MinhThuanLe/RAI_Lab_Kicad_Library/3D/Connector/USB/USB-C_12pin_SMD/USB C Top.png

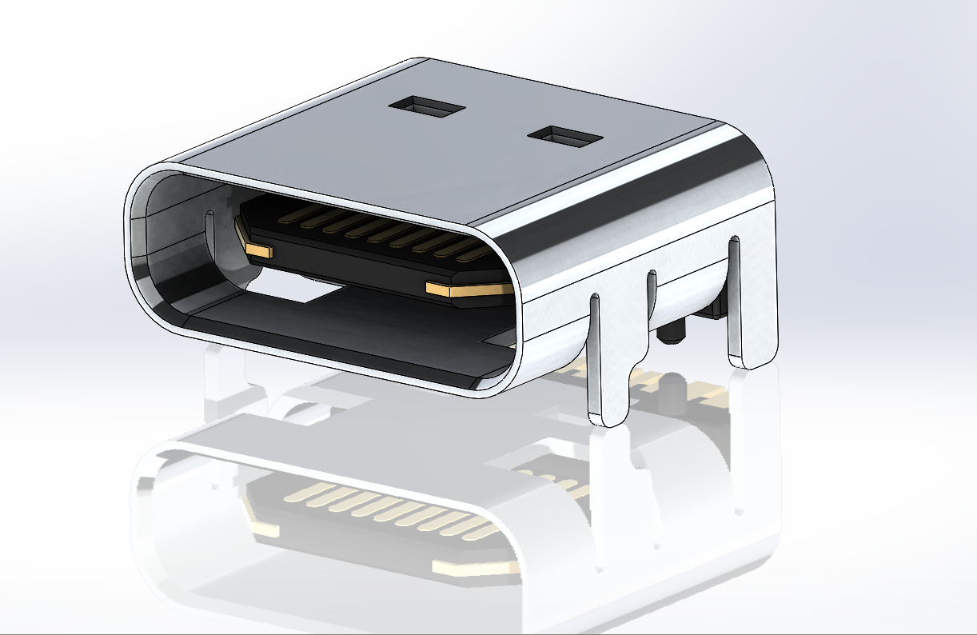
3D/Connector/USB/USB-C_12pin_SMD/USB C Top.png
