MinhThuanLe/RAI_Lab_Kicad_Library/3D/BatteryHolder/14500_BatteryHolder/14500 ICR.PNG

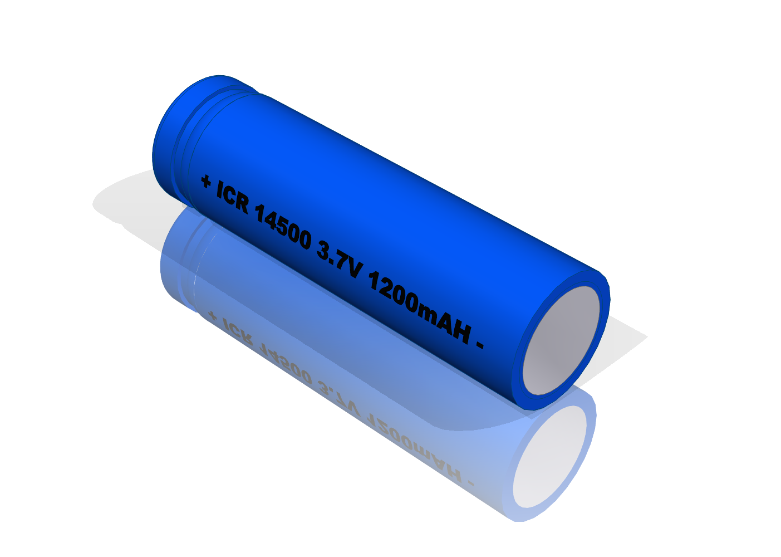
3D/BatteryHolder/14500_BatteryHolder/14500 ICR.PNG
