MinhThuanLe/RAI_Lab_Kicad_Library/3D/BatteryHolder/CR1220_BatteryHolder/Top_CR1220.PNG

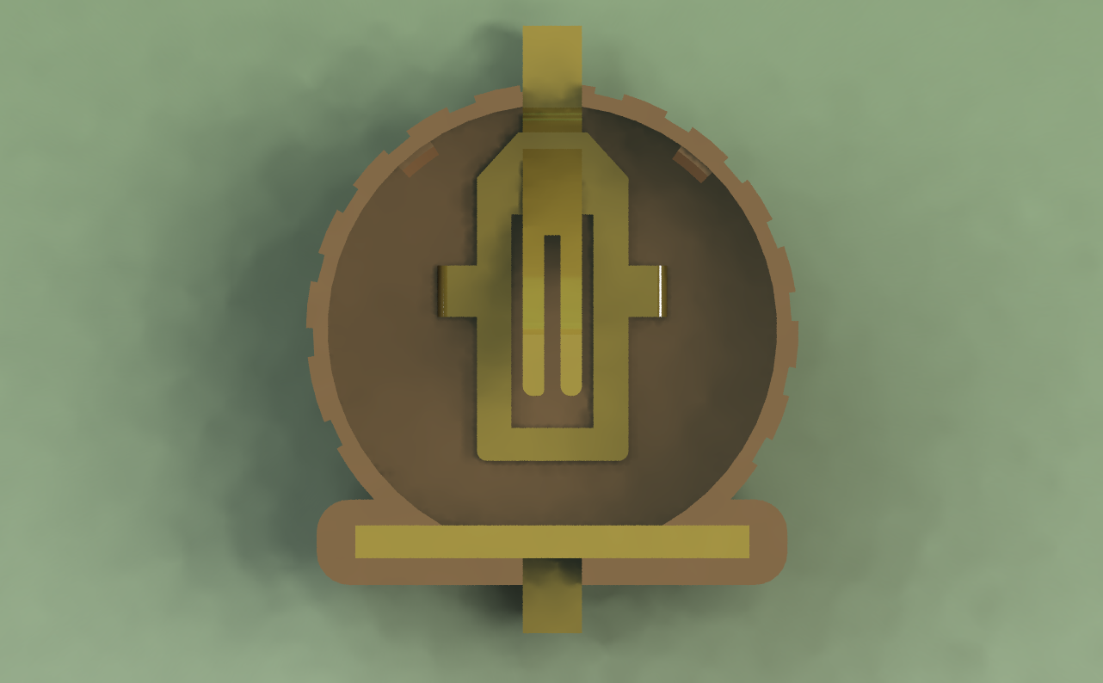
3D/BatteryHolder/CR1220_BatteryHolder/Top_CR1220.PNG
