MinhThuanLe/RAI_Lab_Kicad_Library/3D/BatteryHolder/CR2032_BatteryHolder/CR2032_holder_2018-Jul-28_07-22-14PM-000_CustomizedView1611227186.jpg

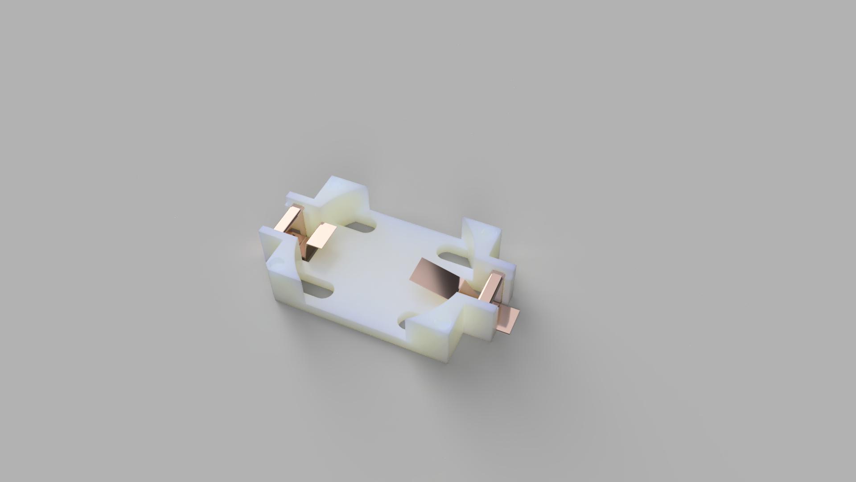
3D/BatteryHolder/CR2032_BatteryHolder/CR2032_holder_2018-Jul-28_07-22-14PM-000_CustomizedView1611227186.jpg
