MinhThuanLe/RAI_Lab_Kicad_Library/3D/BatteryHolder/SINGLE AA BATHOLDER/Renderings/BATT-1.JPG

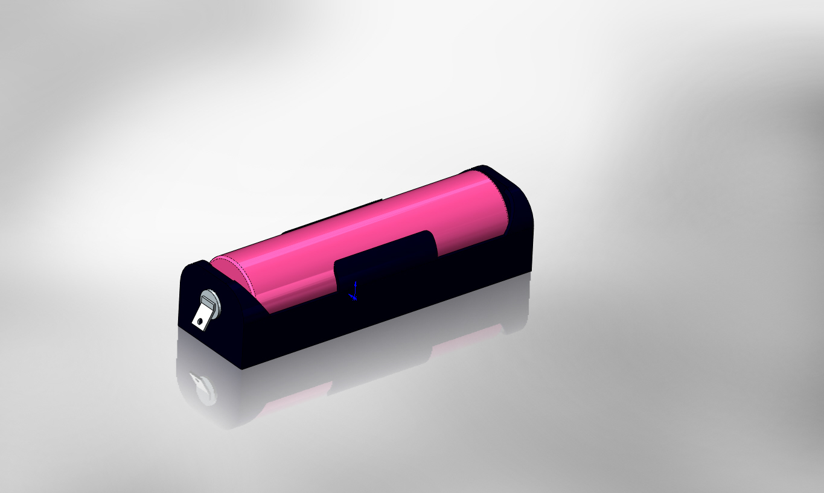
3D/BatteryHolder/SINGLE AA BATHOLDER/Renderings/BATT-1.JPG
