MinhThuanLe/RAI_Lab_Kicad_Library/3D/Comunication/TD301D485/TDx01D485.jpg

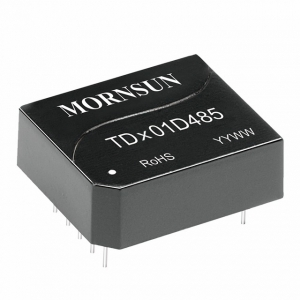
3D/Comunication/TD301D485/TDx01D485.jpg
