MinhThuanLe/RAI_Lab_Kicad_Library/3D/Connector/1706714/1706714.jpg

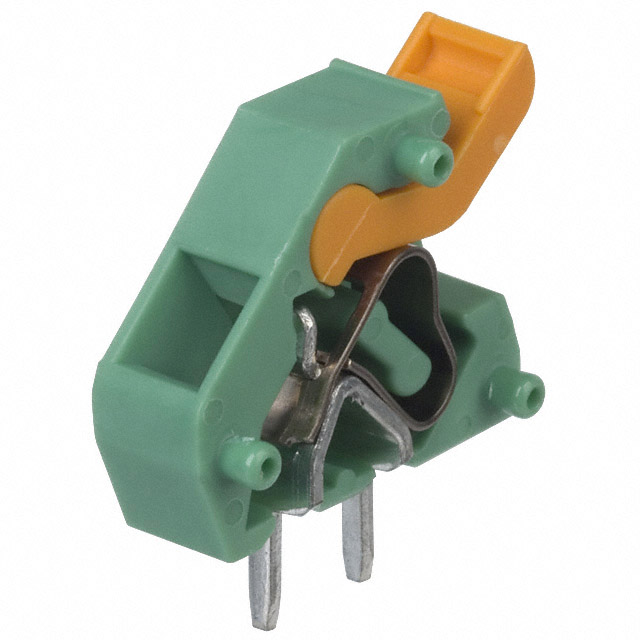
3D/Connector/1706714/1706714.jpg
