MinhThuanLe/RAI_Lab_Kicad_Library/3D/Connector/Banana/14116.jpg

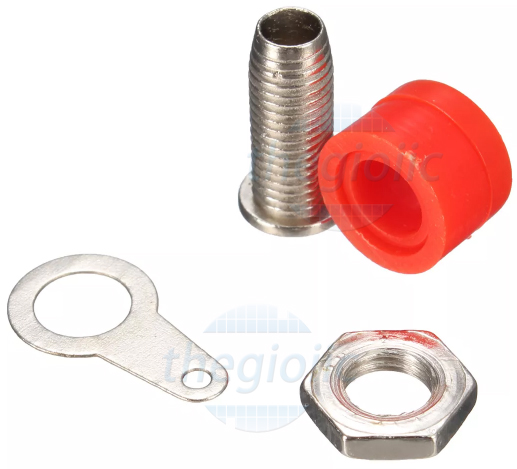
3D/Connector/Banana/14116.jpg
