MinhThuanLe/RAI_Lab_Kicad_Library/3D/Connector/Barrel Jack SMD/BarrelJackSMD.png

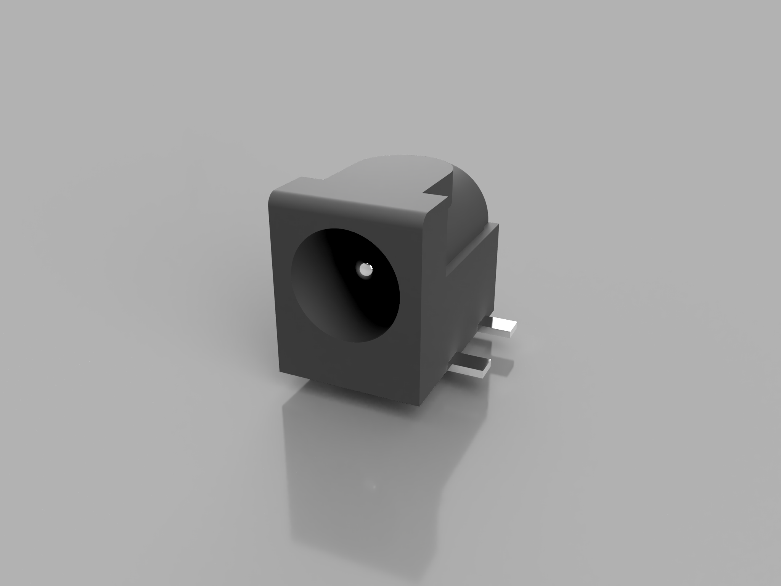
3D/Connector/Barrel Jack SMD/BarrelJackSMD.png
