MinhThuanLe/RAI_Lab_Kicad_Library/3D/Connector/DB/Db15 male PCB Connector.jpg

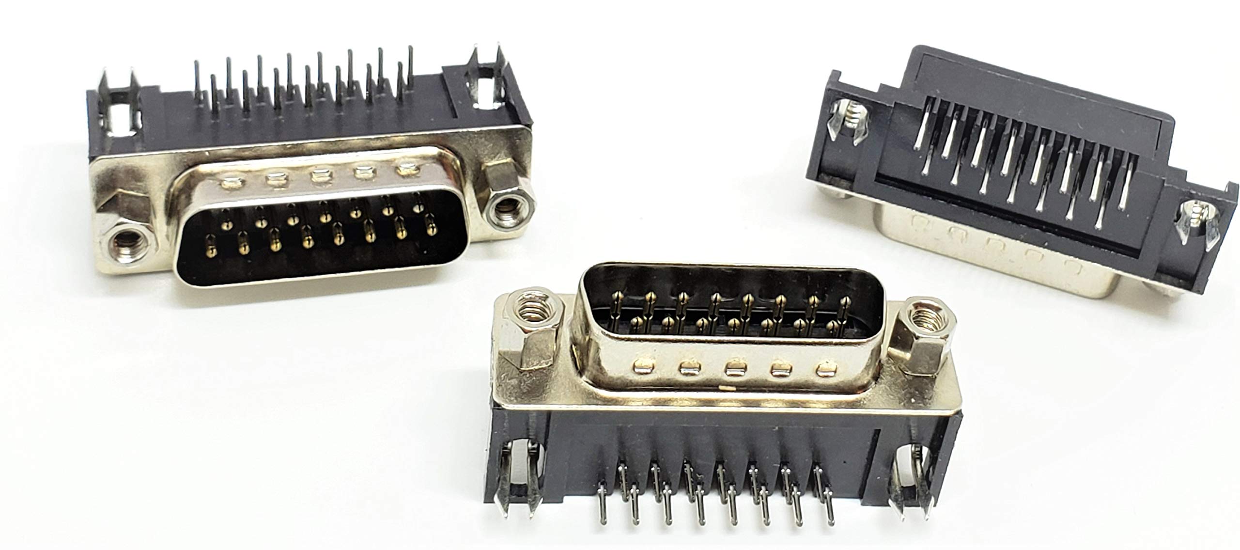
3D/Connector/DB/Db15 male PCB Connector.jpg
