MinhThuanLe/RAI_Lab_Kicad_Library/3D/Connector/DB/VGA_DB15_PCB_RightAngle/c0fe27b1468488ebe378d43be63cc26ed1ba039f.jpg

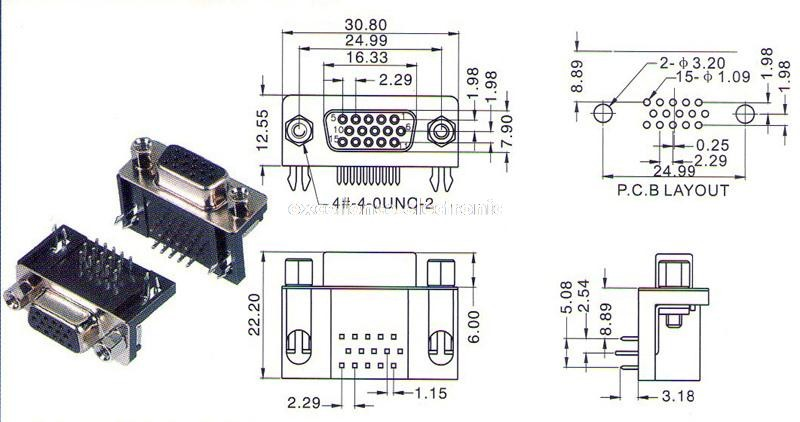
3D/Connector/DB/VGA_DB15_PCB_RightAngle/c0fe27b1468488ebe378d43be63cc26ed1ba039f.jpg
