MinhThuanLe/RAI_Lab_Kicad_Library/3D/Connector/DB/VGA_DB15_PCB_RightAngle/VGA connector on plate (short) - Render image.jpg

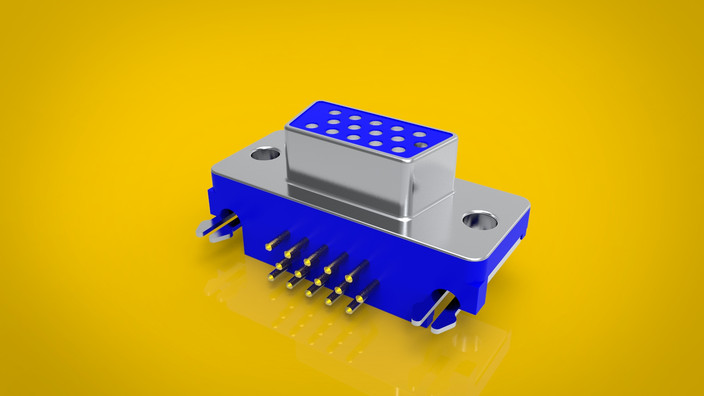
3D/Connector/DB/VGA_DB15_PCB_RightAngle/VGA connector on plate (short) - Render image.jpg
