MinhThuanLe/RAI_Lab_Kicad_Library/3D/Connector/GroveConnector/sit_back.PNG

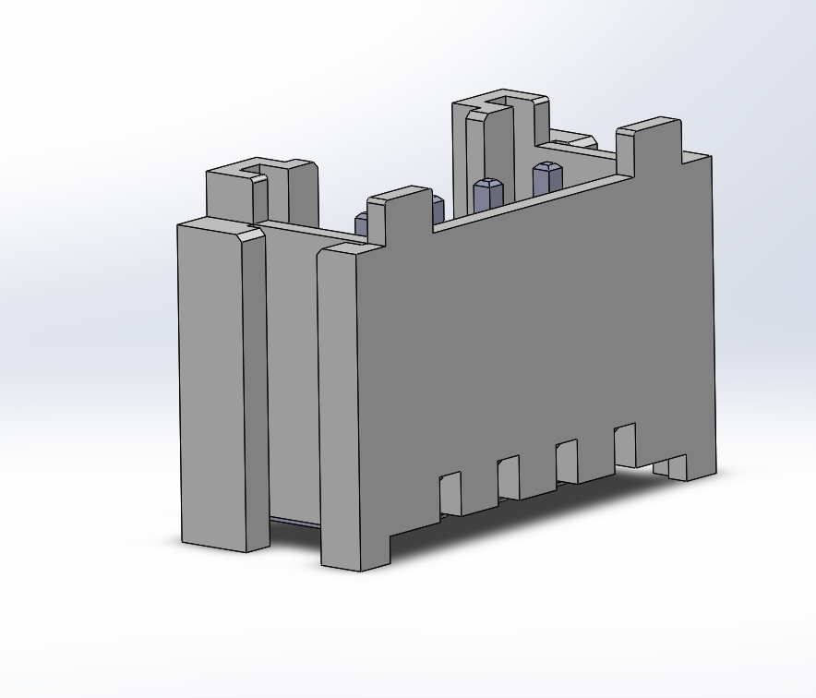
3D/Connector/GroveConnector/sit_back.PNG
