MinhThuanLe/RAI_Lab_Kicad_Library/3D/Connector/GroveConnector/stand_front2.PNG

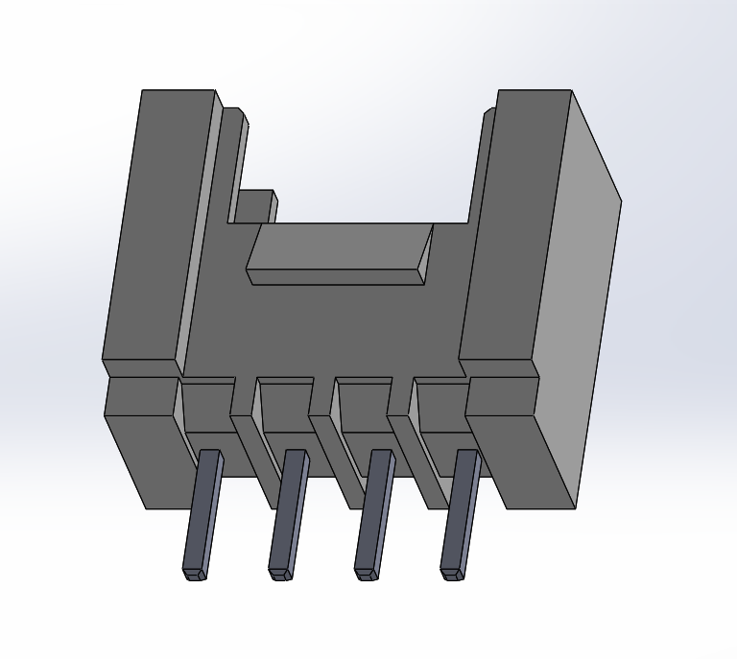
3D/Connector/GroveConnector/stand_front2.PNG
