MinhThuanLe/RAI_Lab_Kicad_Library/3D/Connector/Header Male 2.0mm/TH/Renderings/PinHeadersSF2014.jpg

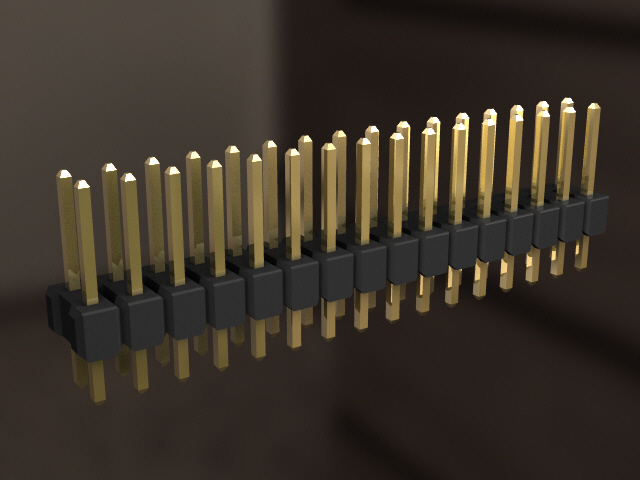
3D/Connector/Header Male 2.0mm/TH/Renderings/PinHeadersSF2014.jpg
