MinhThuanLe/RAI_Lab_Kicad_Library/3D/Connector/Header/Header 1.27mm/Male 1.27mm 2Row SMD/1_27mm_2x11pin.PNG

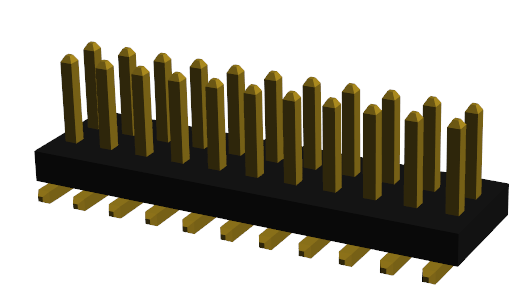
3D/Connector/Header/Header 1.27mm/Male 1.27mm 2Row SMD/1_27mm_2x11pin.PNG
