MinhThuanLe/RAI_Lab_Kicad_Library/3D/Connector/IDC/bh-connector-set-1.snapshot.1/render.JPG

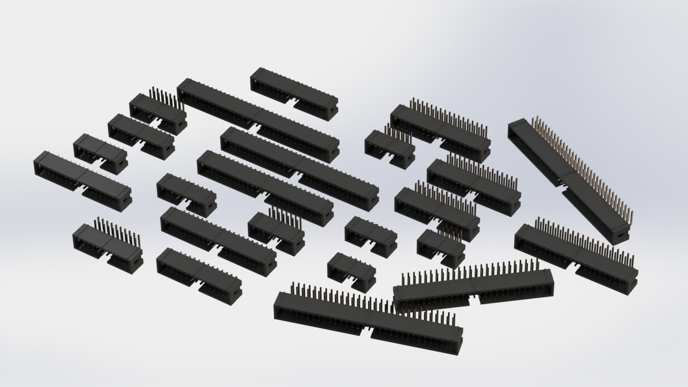
3D/Connector/IDC/bh-connector-set-1.snapshot.1/render.JPG
