MinhThuanLe/RAI_Lab_Kicad_Library/3D/Connector/IDC/IDC Connector 2.54mm/IDC_prev.png

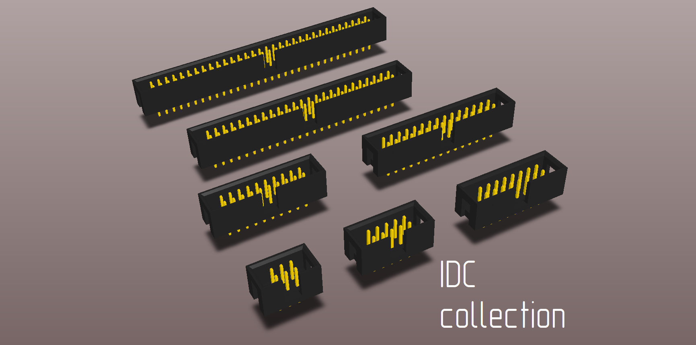
3D/Connector/IDC/IDC Connector 2.54mm/IDC_prev.png
