MinhThuanLe/RAI_Lab_Kicad_Library/3D/Connector/IPEX_Antenna/i-pex-mhf-micro-coax-rf-receptacle-switch-sw23-1.snapshot.2/I-PEX MHF SW23 Coax Switch Recepticle photo.JPG

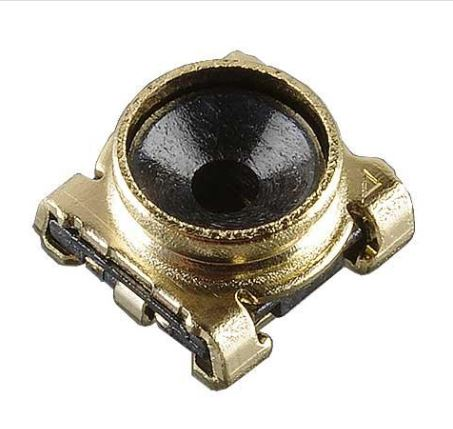
3D/Connector/IPEX_Antenna/i-pex-mhf-micro-coax-rf-receptacle-switch-sw23-1.snapshot.2/I-PEX MHF SW23 Coax Switch Recepticle photo.JPG
