MinhThuanLe/RAI_Lab_Kicad_Library/3D/Connector/Jack_DC/Power Jack Front.jpg

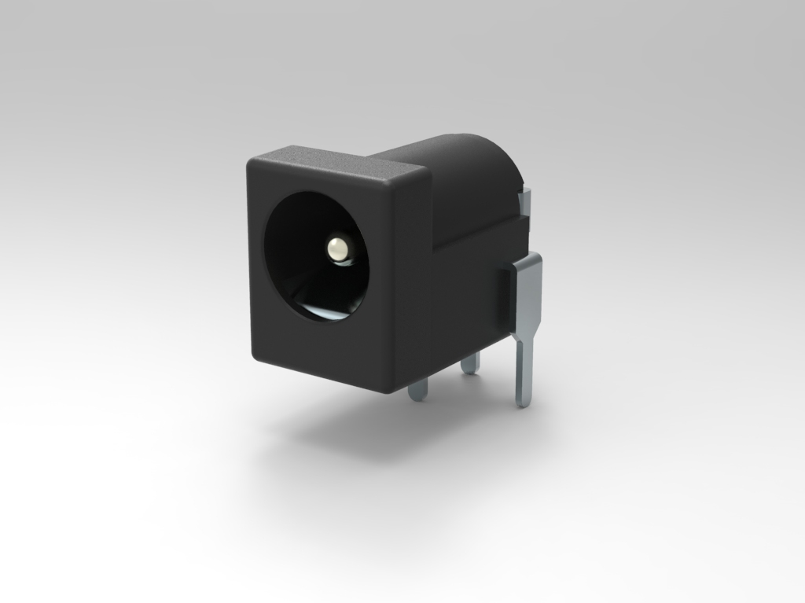
3D/Connector/Jack_DC/Power Jack Front.jpg
