MinhThuanLe/RAI_Lab_Kicad_Library/3D/Connector/JST/DIP/JST-PH-Thru-Vertical-2.00mm/JST - 2.00mm - PH - Assortment.PNG

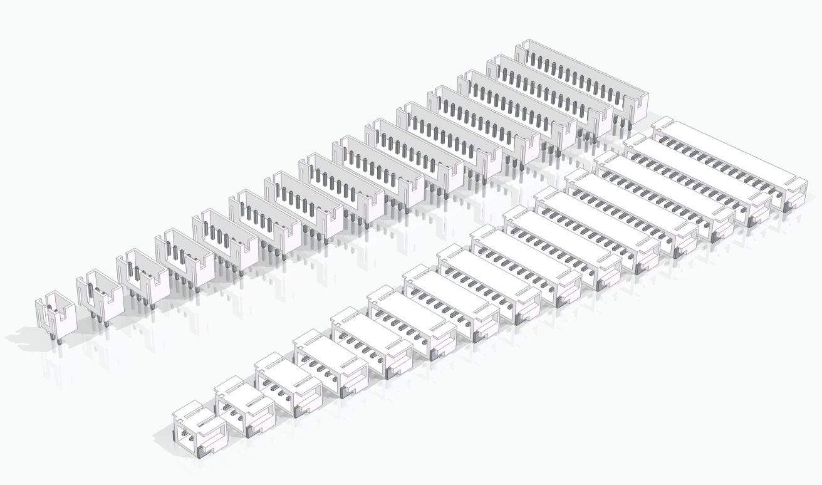
3D/Connector/JST/DIP/JST-PH-Thru-Vertical-2.00mm/JST - 2.00mm - PH - Assortment.PNG
