MinhThuanLe/RAI_Lab_Kicad_Library/3D/Connector/JST/DIP/JST-VH-Thru-Vertical-3.96mm/Capture.PNG

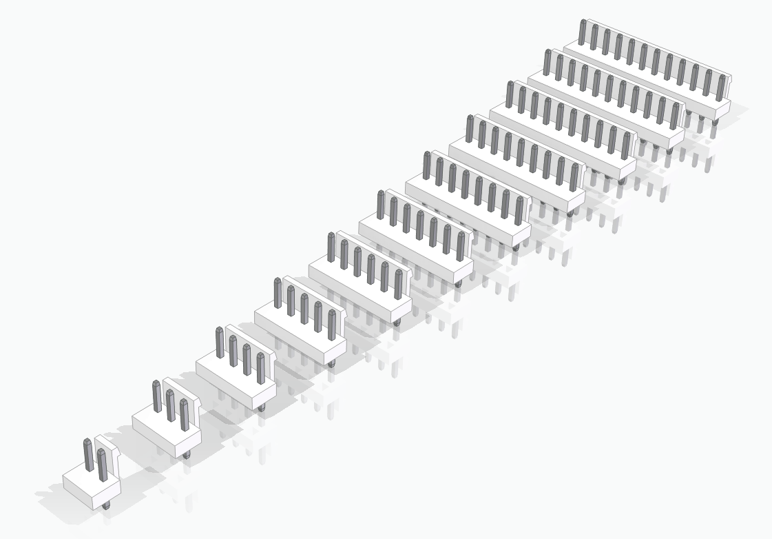
3D/Connector/JST/DIP/JST-VH-Thru-Vertical-3.96mm/Capture.PNG
