MinhThuanLe/RAI_Lab_Kicad_Library/3D/Connector/JST/DIP/JST-XH-Thru-Vertical-2.54mm-4P/2016-12-01_19-26-19.png

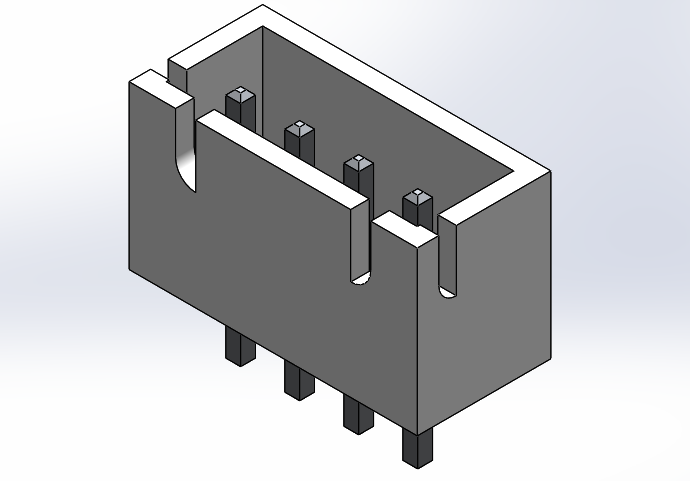
3D/Connector/JST/DIP/JST-XH-Thru-Vertical-2.54mm-4P/2016-12-01_19-26-19.png
