MinhThuanLe/RAI_Lab_Kicad_Library/3D/Connector/JST/DIP/JST-XH-Thru-Vertical-2.54mm-5P/JST 5pin.PNG

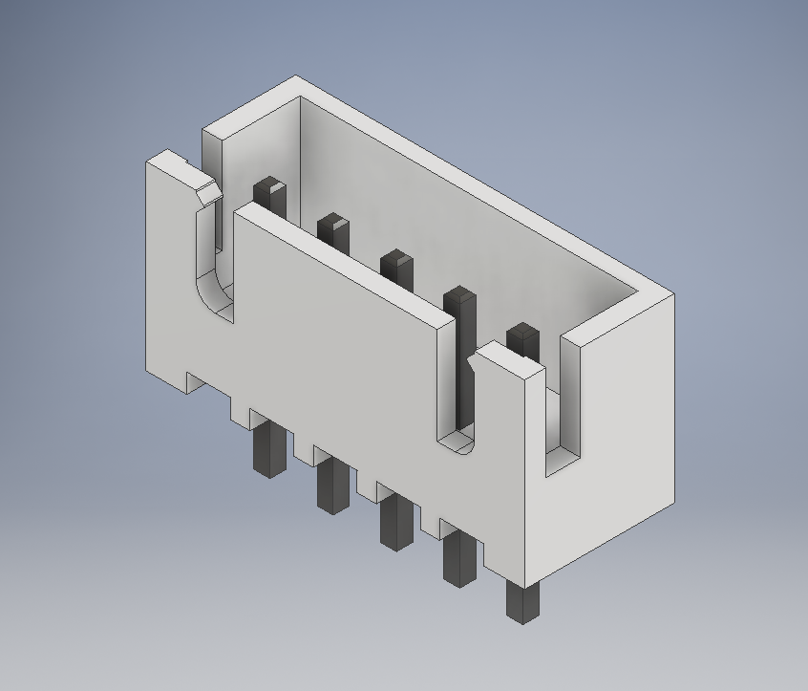
3D/Connector/JST/DIP/JST-XH-Thru-Vertical-2.54mm-5P/JST 5pin.PNG
