MinhThuanLe/RAI_Lab_Kicad_Library/3D/Connector/JST/DIP/JST-XH-Thru-Vertical-2.54mm-8P/JST XH 8 S8B-XH-A1 shrouded header connector v4.png

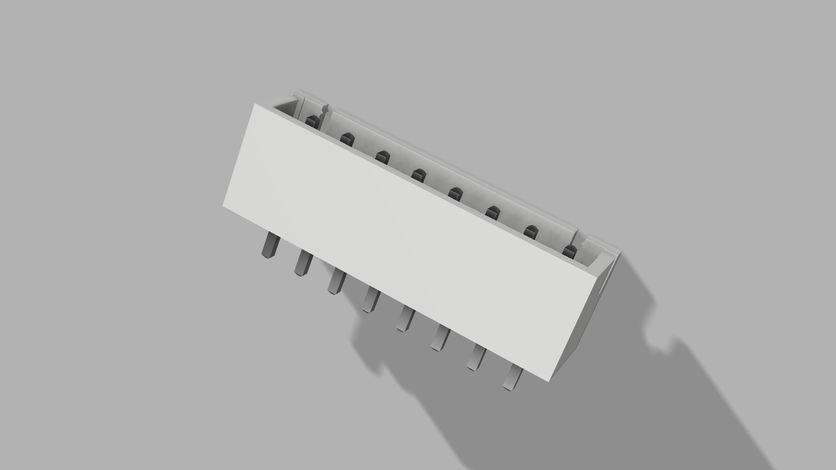
3D/Connector/JST/DIP/JST-XH-Thru-Vertical-2.54mm-8P/JST XH 8 S8B-XH-A1 shrouded header connector v4.png
