MinhThuanLe/RAI_Lab_Kicad_Library/3D/Connector/KF7.62/kf7-62-screw-terminal-1.snapshot.1/KF7.62.png

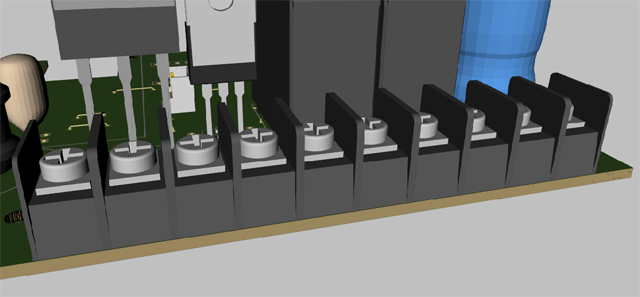
3D/Connector/KF7.62/kf7-62-screw-terminal-1.snapshot.1/KF7.62.png
