MinhThuanLe/RAI_Lab_Kicad_Library/3D/Connector/KF2510/molex3.jpg

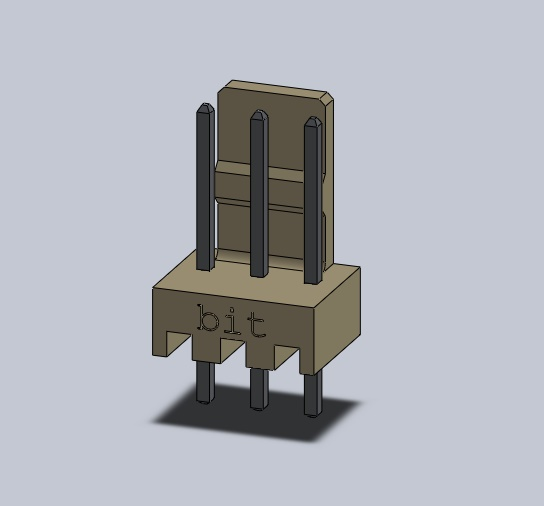
3D/Connector/KF2510/molex3.jpg
