MinhThuanLe/RAI_Lab_Kicad_Library/3D/Connector/RJ11/TJ6P6C/Pic_TJ6-6Cmin.jpg

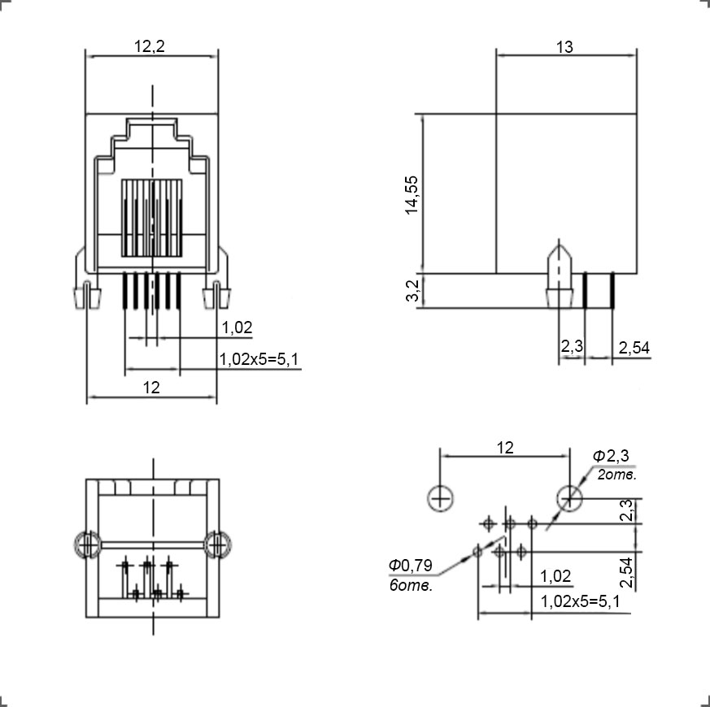
3D/Connector/RJ11/TJ6P6C/Pic_TJ6-6Cmin.jpg
