MinhThuanLe/RAI_Lab_Kicad_Library/3D/Connector/RJ11/TJ6P6C/TJ6P6C 2.png

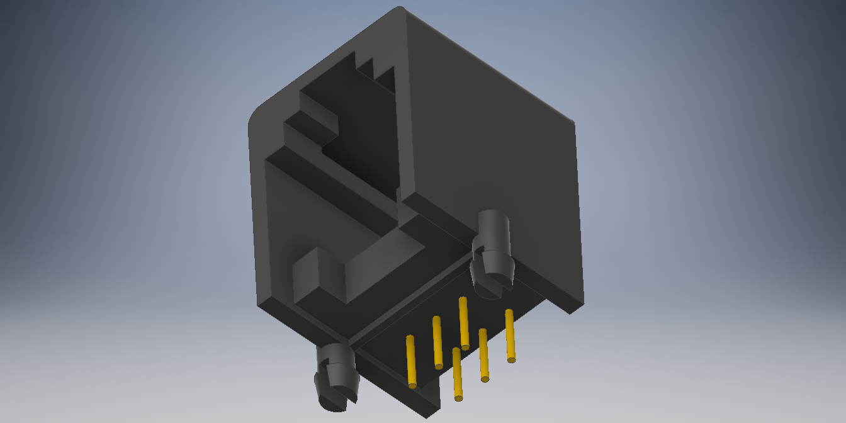
3D/Connector/RJ11/TJ6P6C/TJ6P6C 2.png
