MinhThuanLe/RAI_Lab_Kicad_Library/3D/Connector/ShuntJumpter/Jumper Closed.png

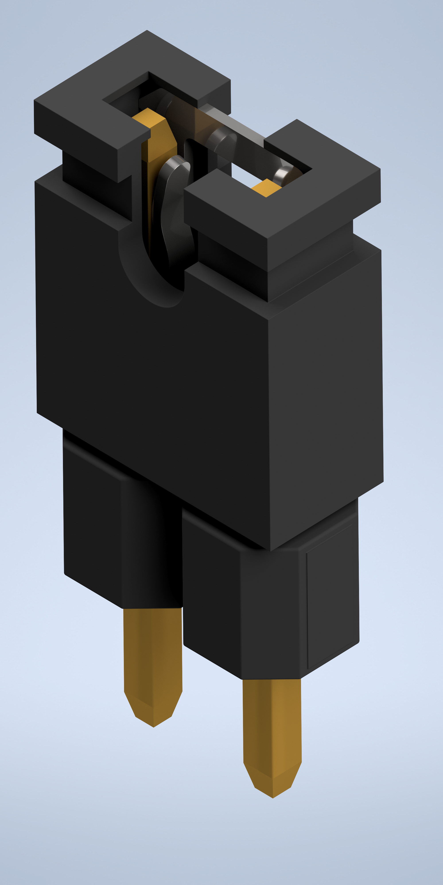
3D/Connector/ShuntJumpter/Jumper Closed.png
