MinhThuanLe/RAI_Lab_Kicad_Library/3D/Connector/Sim_card_holder/Renderings/ATTEND_115A-ADA0-R02.JPG

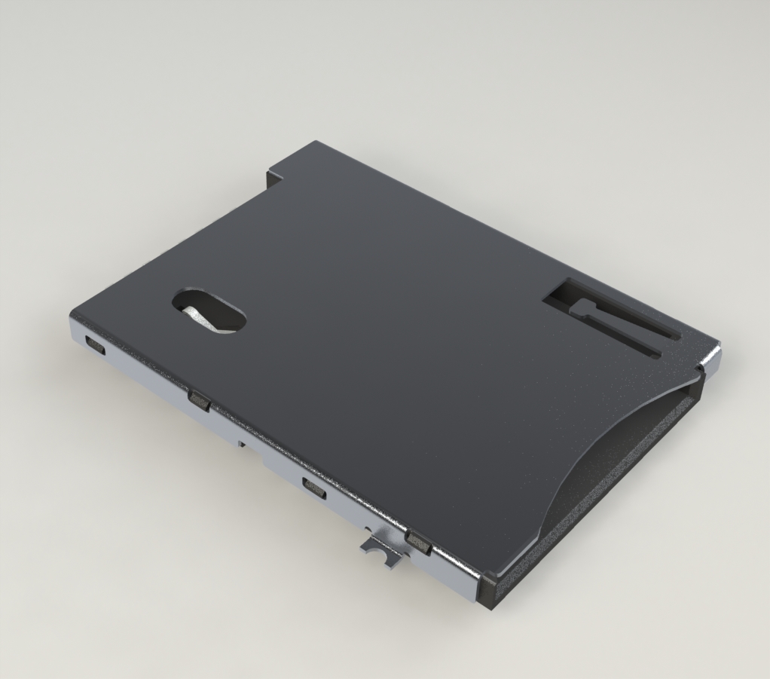
3D/Connector/Sim_card_holder/Renderings/ATTEND_115A-ADA0-R02.JPG
