MinhThuanLe/RAI_Lab_Kicad_Library/3D/Connector/SIMCardHolder/NanoSIM/Molex/47388001/2.JPG

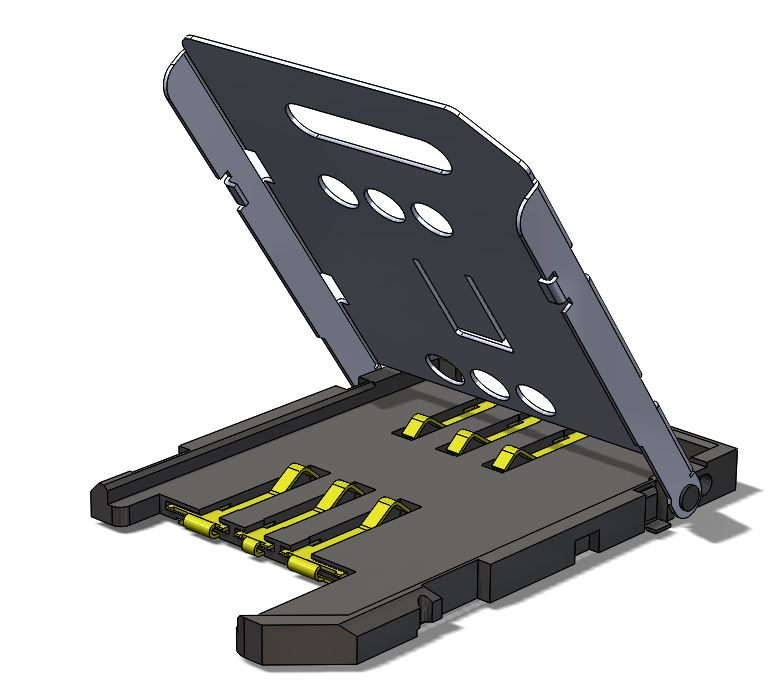
3D/Connector/SIMCardHolder/NanoSIM/Molex/47388001/2.JPG
