MinhThuanLe/RAI_Lab_Kicad_Library/3D/Connector/Terminal Screw 3P Blue/001.JPG

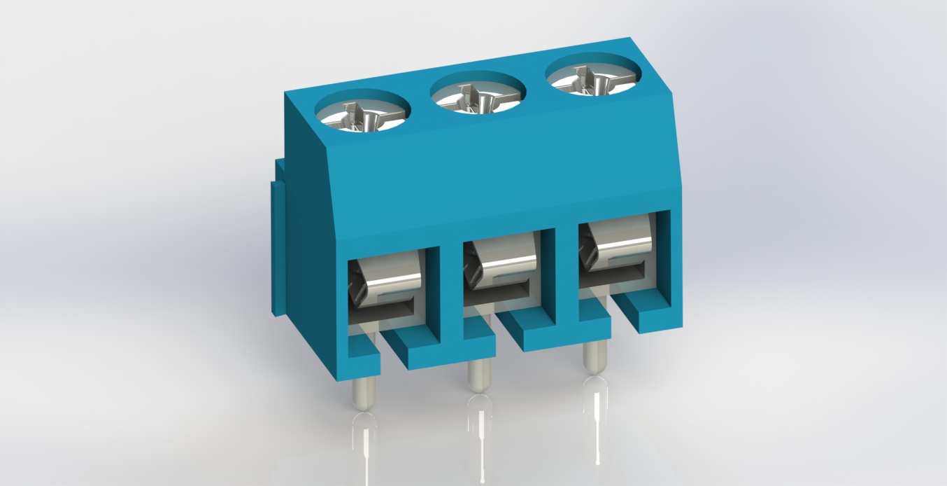
3D/Connector/Terminal Screw 3P Blue/001.JPG
