MinhThuanLe/RAI_Lab_Kicad_Library/3D/Connector/terminal-block-connector-1.snapshot.7/691216510002_1776244-2.jpg

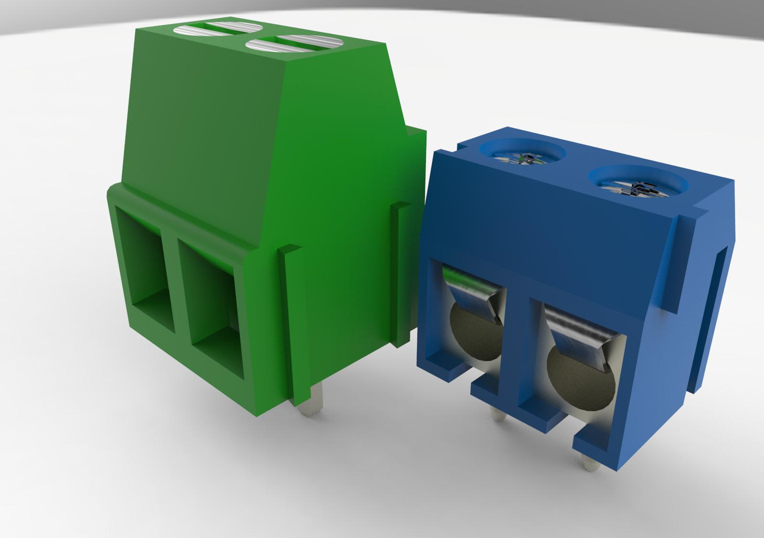
3D/Connector/terminal-block-connector-1.snapshot.7/691216510002_1776244-2.jpg
