MinhThuanLe/RAI_Lab_Kicad_Library/3D/Connector/terminal-block-connector-1.snapshot.7/TE 1776244-2-1.JPG

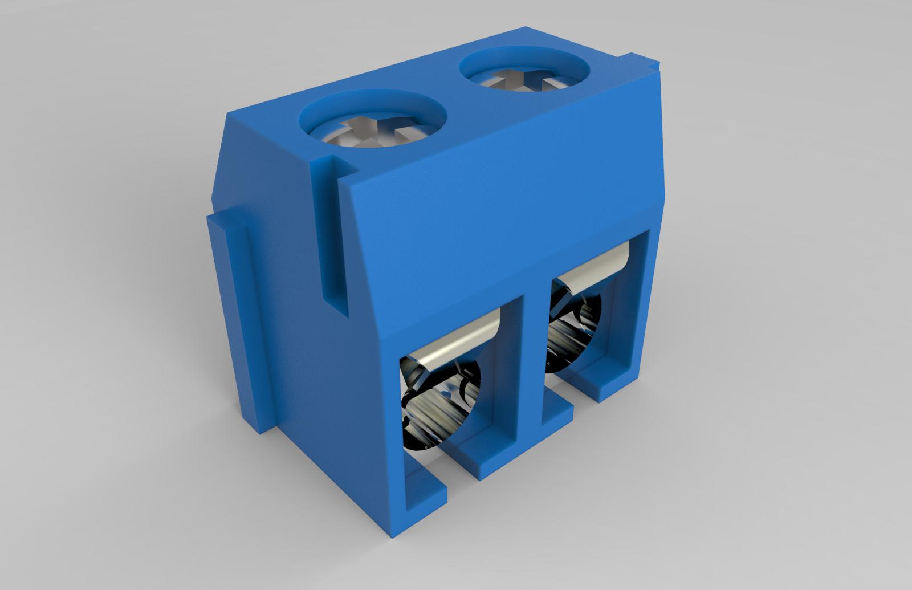
3D/Connector/terminal-block-connector-1.snapshot.7/TE 1776244-2-1.JPG
