MinhThuanLe/RAI_Lab_Kicad_Library/3D/Connector/terminal-block-connector-1.snapshot.7/WURTH_691216510002.jpg

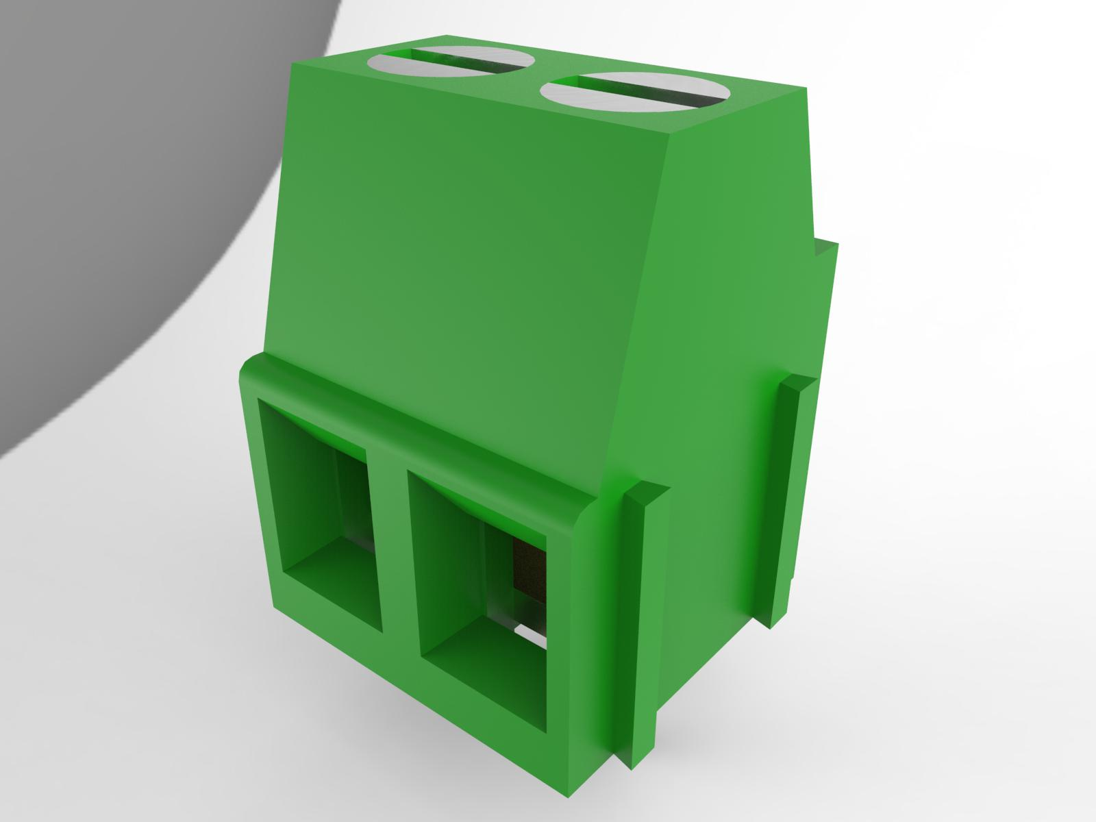
3D/Connector/terminal-block-connector-1.snapshot.7/WURTH_691216510002.jpg
