MinhThuanLe/RAI_Lab_Kicad_Library/3D/Connector/TerminalBlock/borne-5-08mm-duplo-nivel-1.snapshot.2/borne 2.png

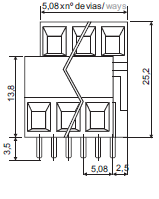
3D/Connector/TerminalBlock/borne-5-08mm-duplo-nivel-1.snapshot.2/borne 2.png
