MinhThuanLe/RAI_Lab_Kicad_Library/3D/Connector/USB-C_12pin_SMD/USB C Bottom.png

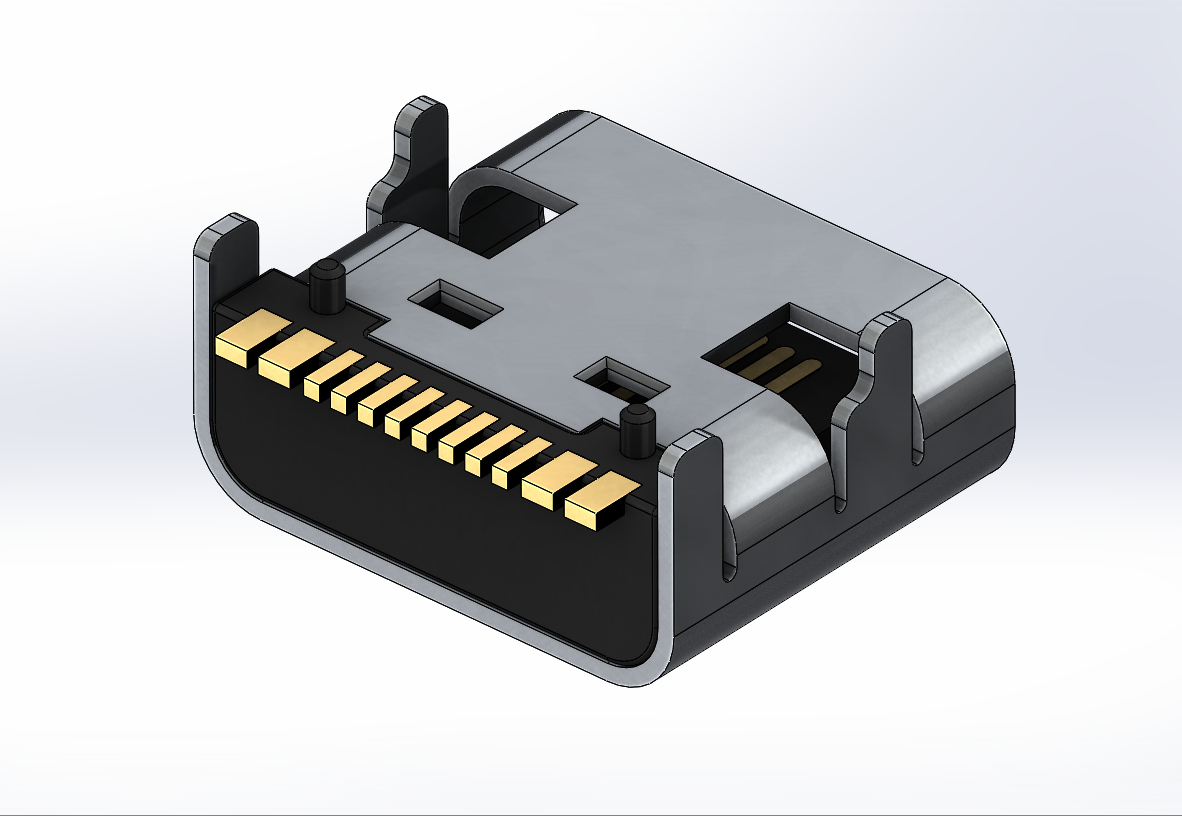
3D/Connector/USB-C_12pin_SMD/USB C Bottom.png
