MinhThuanLe/RAI_Lab_Kicad_Library/3D/Connector/XH_2.54/JST XH Assortment.PNG

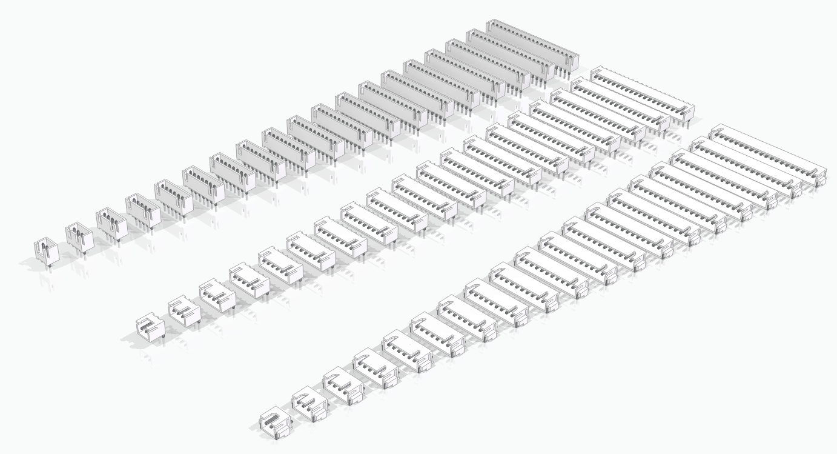
3D/Connector/XH_2.54/JST XH Assortment.PNG
