MinhThuanLe/RAI_Lab_Kicad_Library/3D/Crystal/CrystalOscillator2016_4P_SMD/QFN_2016_4pins iso rendering - top.JPG

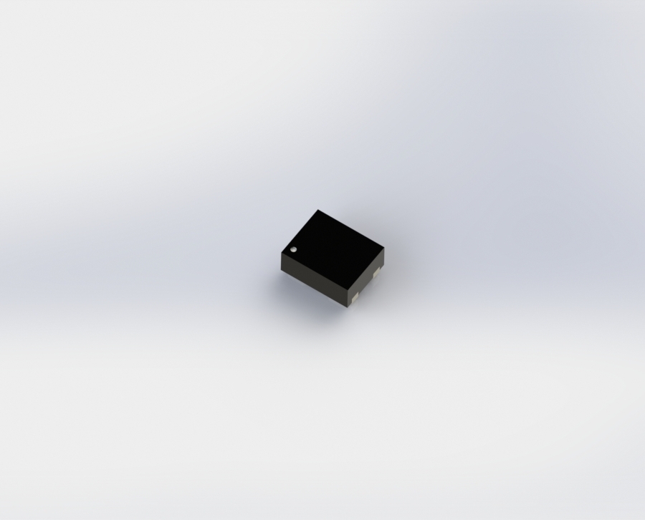
3D/Crystal/CrystalOscillator2016_4P_SMD/QFN_2016_4pins iso rendering - top.JPG
