MinhThuanLe/RAI_Lab_Kicad_Library/3D/Diode/Diodes-smd-packages.png

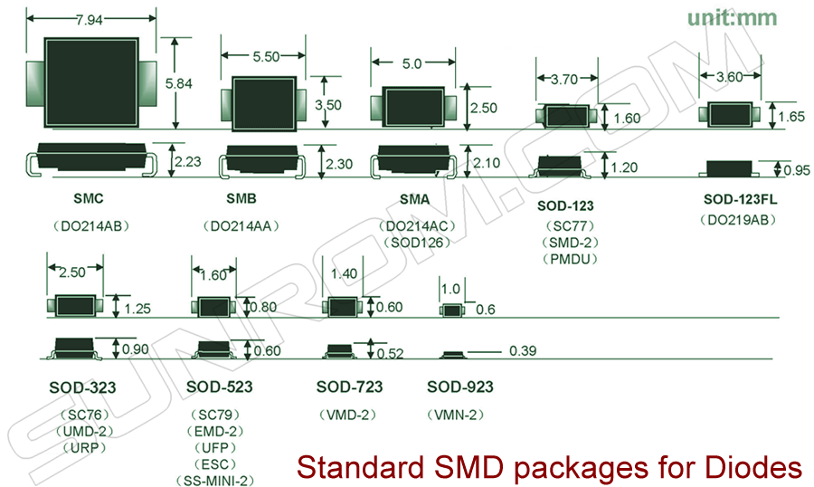
3D/Diode/Diodes-smd-packages.png
