MinhThuanLe/RAI_Lab_Kicad_Library/3D/Diode/LED/GP1UE26RK0VF.jpg

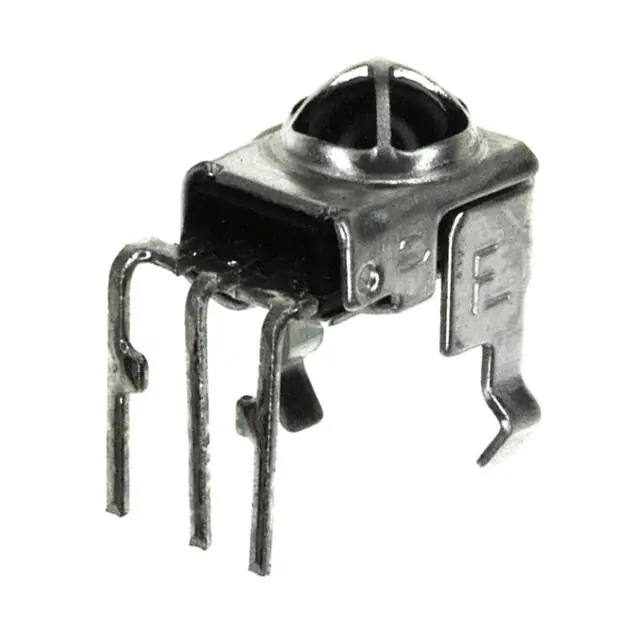
3D/Diode/LED/GP1UE26RK0VF.jpg
