MinhThuanLe/RAI_Lab_Kicad_Library/3D/Diode/LED/ITR9909.jpg

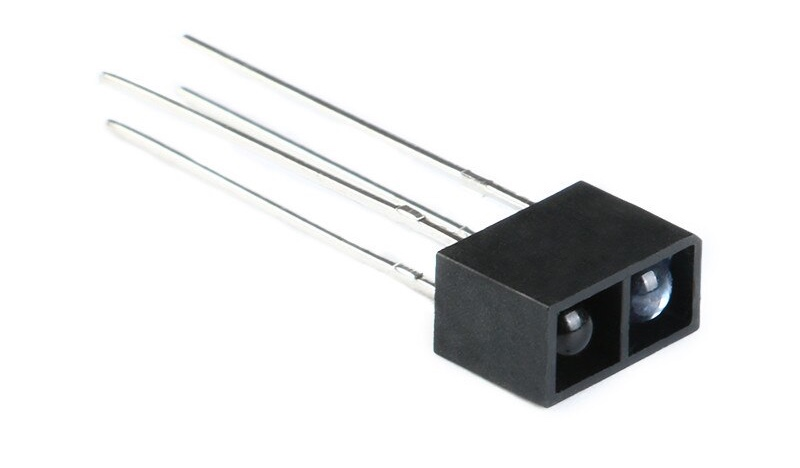
3D/Diode/LED/ITR9909.jpg
