MinhThuanLe/RAI_Lab_Kicad_Library/3D/Diode/LED/LED/Lite-On SMD LEDs.PNG

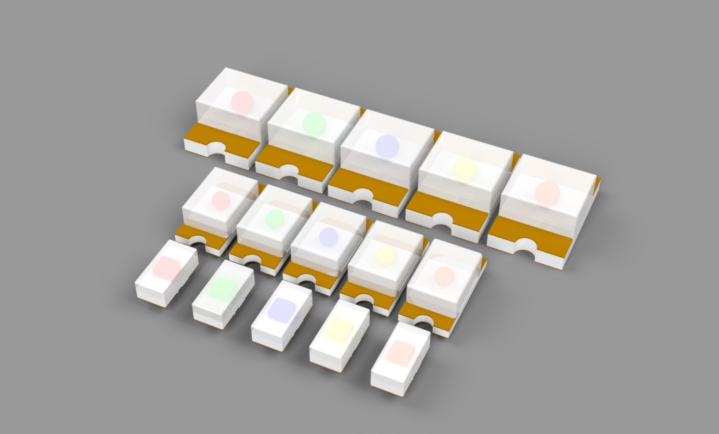
3D/Diode/LED/LED/Lite-On SMD LEDs.PNG
