MinhThuanLe/RAI_Lab_Kicad_Library/3D/Diode/LED/LED_Housing/LED 3mm red housing_1.jpg

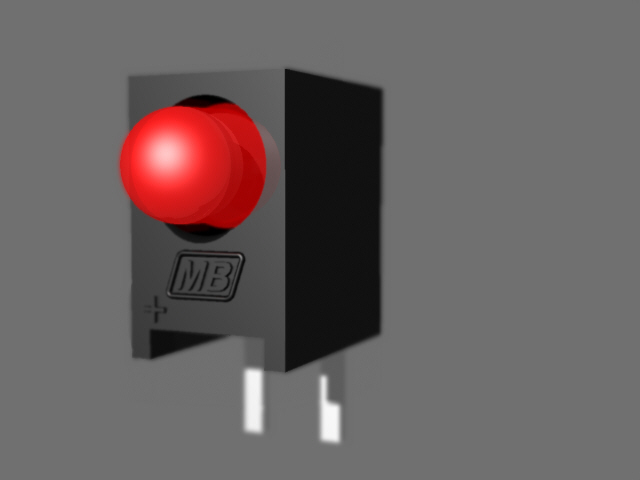
3D/Diode/LED/LED_Housing/LED 3mm red housing_1.jpg
