MinhThuanLe/RAI_Lab_Kicad_Library/3D/Diode/LED/LED_Housing/led model dimensions.png

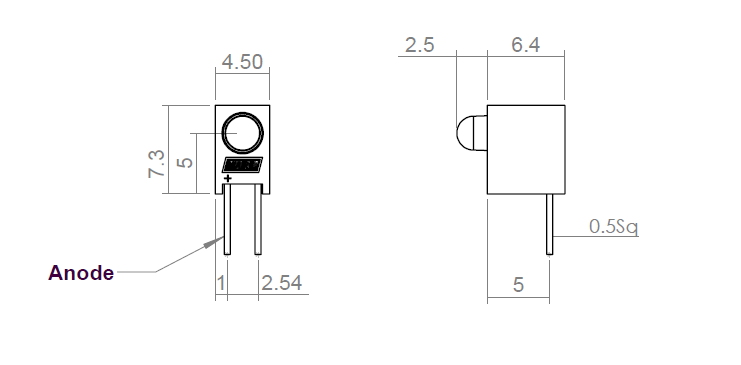
3D/Diode/LED/LED_Housing/led model dimensions.png
