MinhThuanLe/RAI_Lab_Kicad_Library/3D/Diode/LED/LED_Housing/LEDs 3mm housing_4.jpg

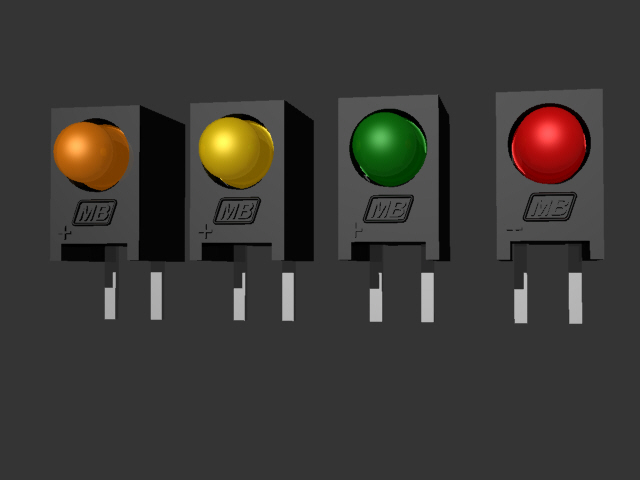
3D/Diode/LED/LED_Housing/LEDs 3mm housing_4.jpg
