MinhThuanLe/RAI_Lab_Kicad_Library/3D/Diode/LED/TCRT5000 .png

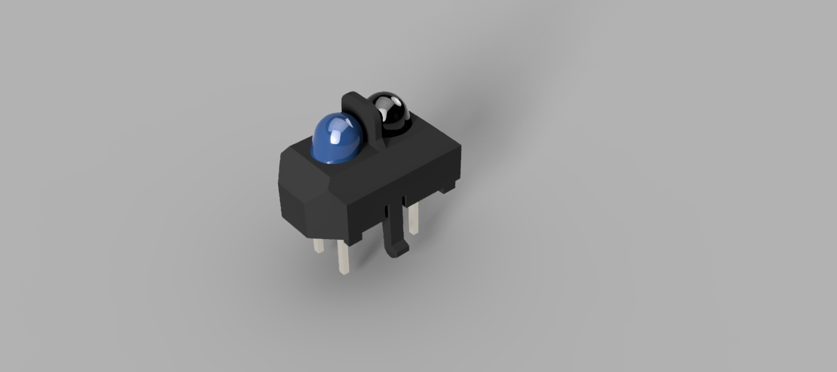
3D/Diode/LED/TCRT5000 .png
