MinhThuanLe/RAI_Lab_Kicad_Library/3D/Diode/LED/VS1383B back.JPG

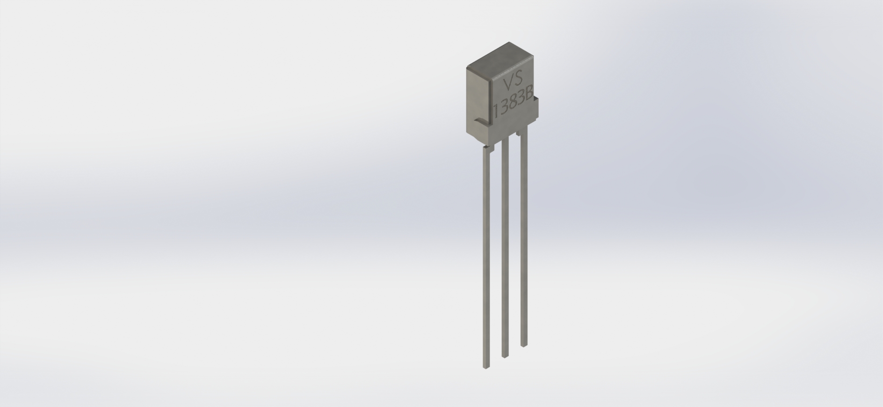
3D/Diode/LED/VS1383B back.JPG
