MinhThuanLe/RAI_Lab_Kicad_Library/3D/Diode/LED/VS1383B front.JPG

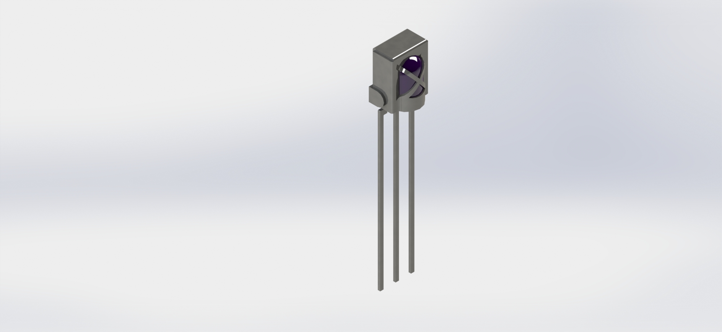
3D/Diode/LED/VS1383B front.JPG
