MinhThuanLe/RAI_Lab_Kicad_Library/3D/Diode/SMA/Package diode SMA.jpg

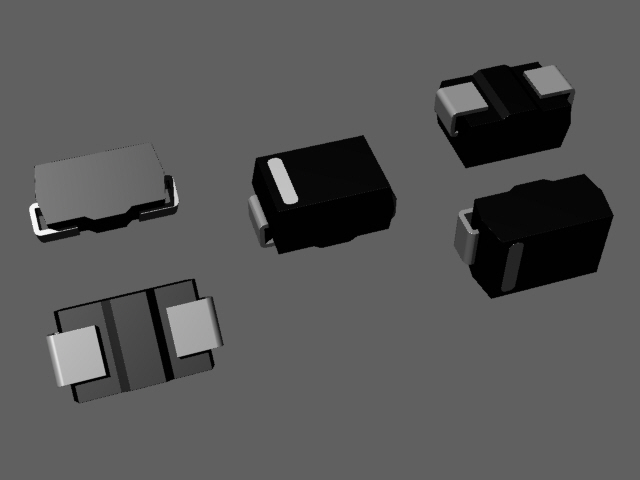
3D/Diode/SMA/Package diode SMA.jpg
