MinhThuanLe/RAI_Lab_Kicad_Library/3D/Diode/SOD323/SOD-600.jpg

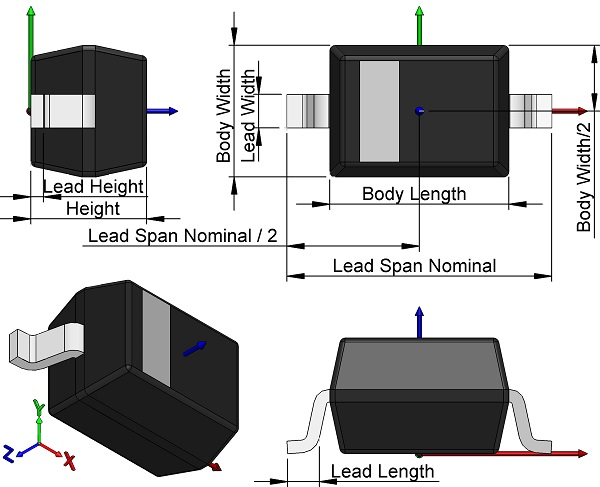
3D/Diode/SOD323/SOD-600.jpg
