MinhThuanLe/RAI_Lab_Kicad_Library/3D/Encoder/DIP/11mm-metal-shaft-rotary-encoders-horizontal-w-push-on-switch/EC11B-SW-Horiz-F.png

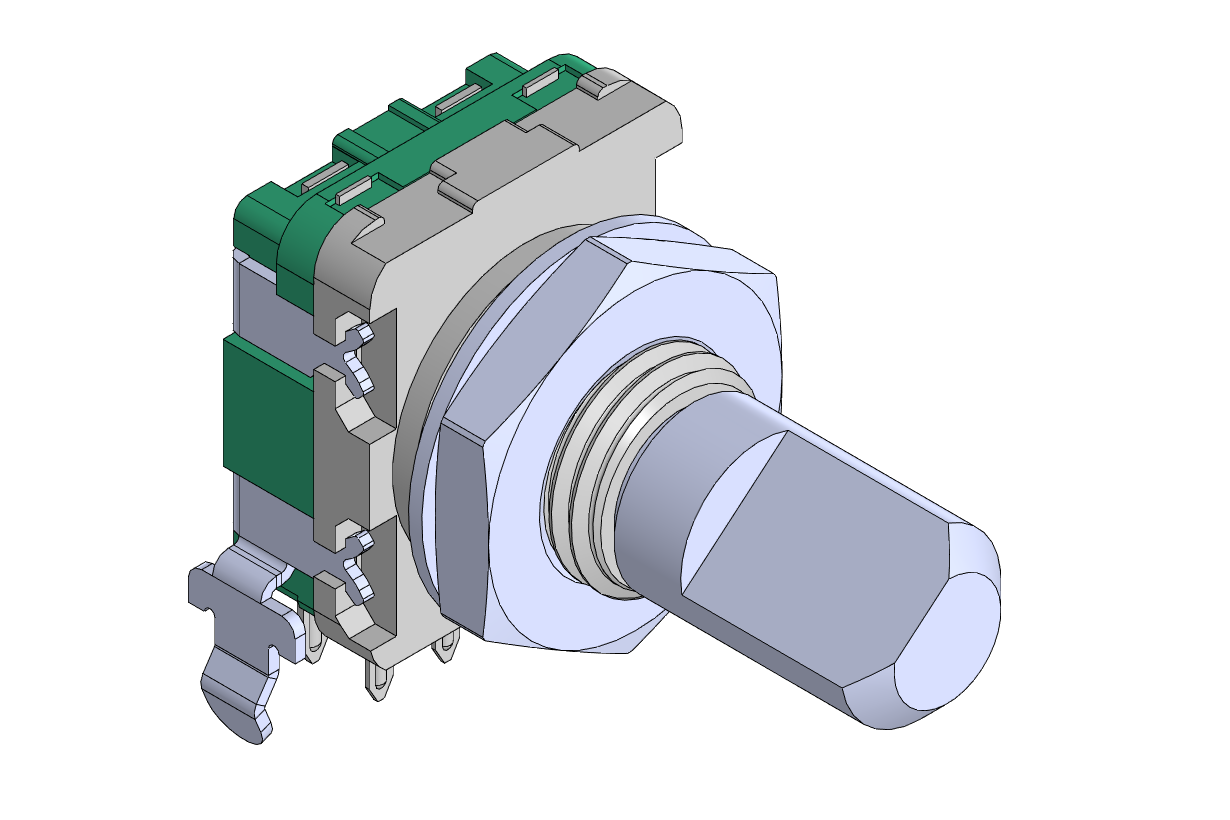
3D/Encoder/DIP/11mm-metal-shaft-rotary-encoders-horizontal-w-push-on-switch/EC11B-SW-Horiz-F.png
