MinhThuanLe/RAI_Lab_Kicad_Library/3D/Encoder/DIP/11mm-metal-shaft-rotary-encoders-tht-vertical-w-push-on-switch/EC11-THT-25R-black.png

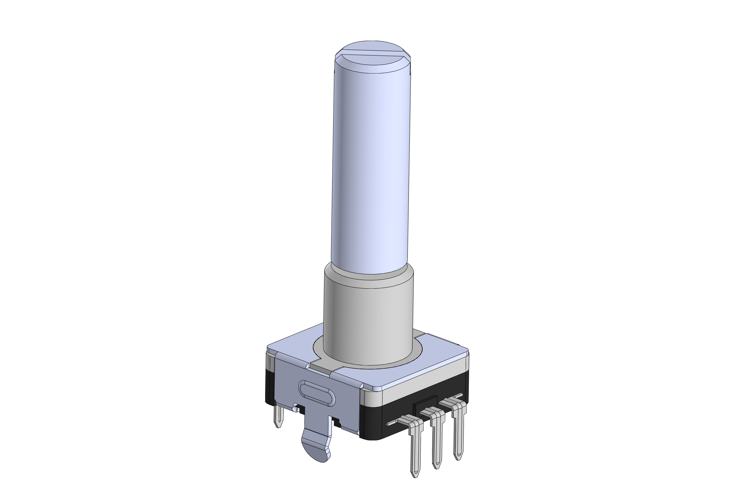
3D/Encoder/DIP/11mm-metal-shaft-rotary-encoders-tht-vertical-w-push-on-switch/EC11-THT-25R-black.png
