MinhThuanLe/RAI_Lab_Kicad_Library/3D/Encoder/DIP/rotary-encoder-17.snapshot.2/1.PNG

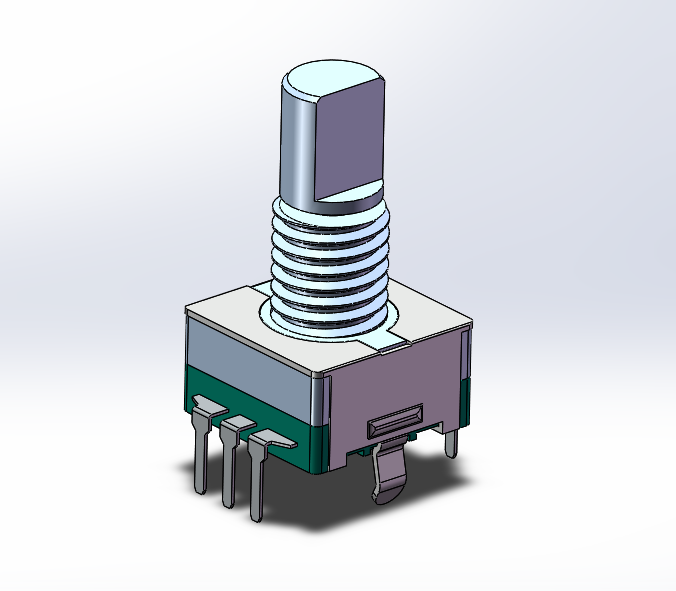
3D/Encoder/DIP/rotary-encoder-17.snapshot.2/1.PNG
