MinhThuanLe/RAI_Lab_Kicad_Library/3D/Fuses/FuseHolderGlass5x20mm/fuse.jpg

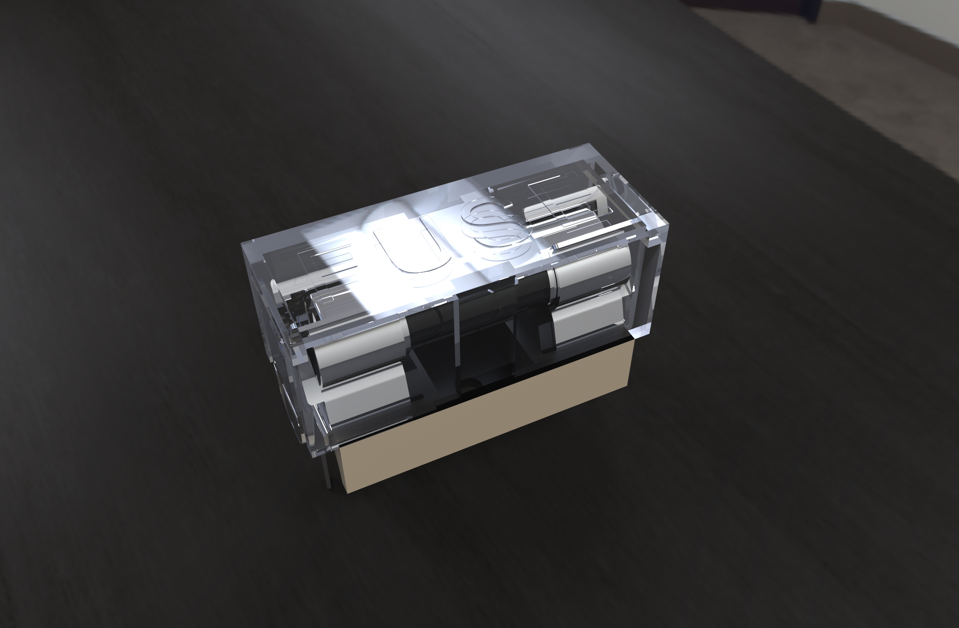
3D/Fuses/FuseHolderGlass5x20mm/fuse.jpg
