MinhThuanLe/RAI_Lab_Kicad_Library/3D/Fuses/FuseSMD/litteFuse/Littelfuse_0154.500DRT_without_value_black_2020-Jun-30_08-23-00AM-000_CustomizedView4664949642.png

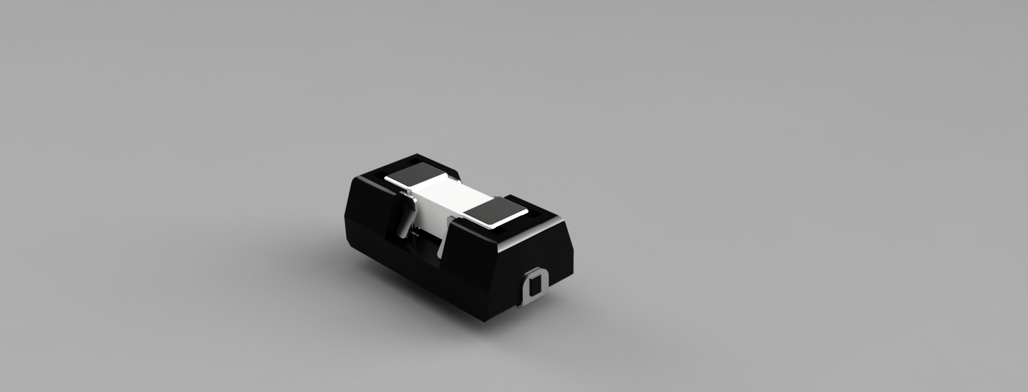
3D/Fuses/FuseSMD/litteFuse/Littelfuse_0154.500DRT_without_value_black_2020-Jun-30_08-23-00AM-000_CustomizedView4664949642.png
