MinhThuanLe/RAI_Lab_Kicad_Library/3D/Fuses/FuseSMD/Resettable Fuse/1206/Bourns SF Fuse/Bourns SF-1206SA-R series SMD Fuses.jpg

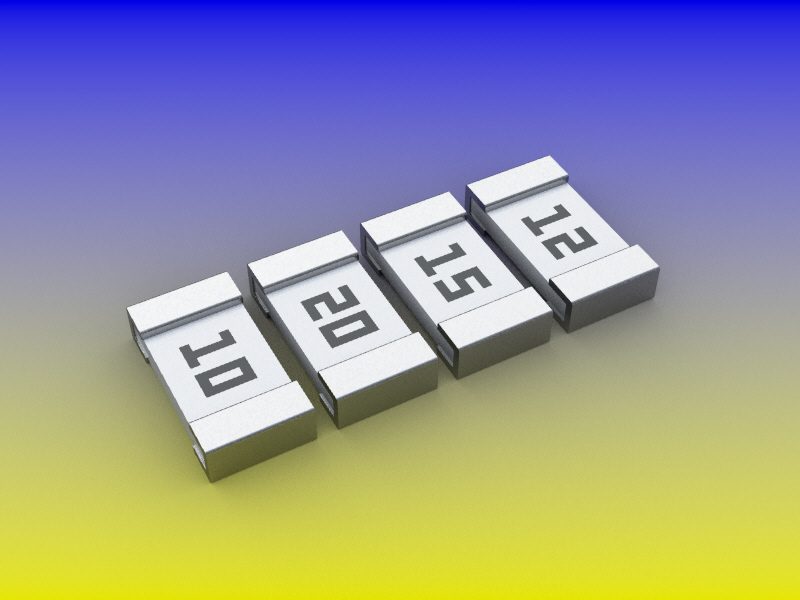
3D/Fuses/FuseSMD/Resettable Fuse/1206/Bourns SF Fuse/Bourns SF-1206SA-R series SMD Fuses.jpg
