MinhThuanLe/RAI_Lab_Kicad_Library/3D/Fuses/FuseSMD/Resettable Fuse/1206_dimensions.PNG

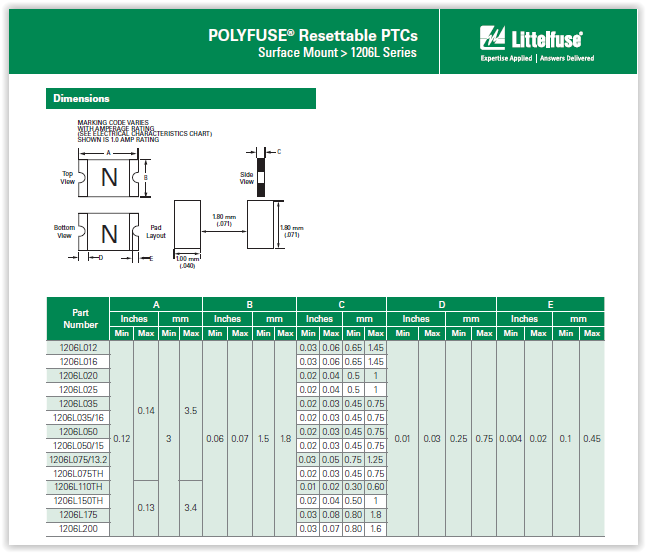
3D/Fuses/FuseSMD/Resettable Fuse/1206_dimensions.PNG
