MinhThuanLe/RAI_Lab_Kicad_Library/3D/Fuses/FuseSMD/Resettable Fuse/1812/smd1812.bmp

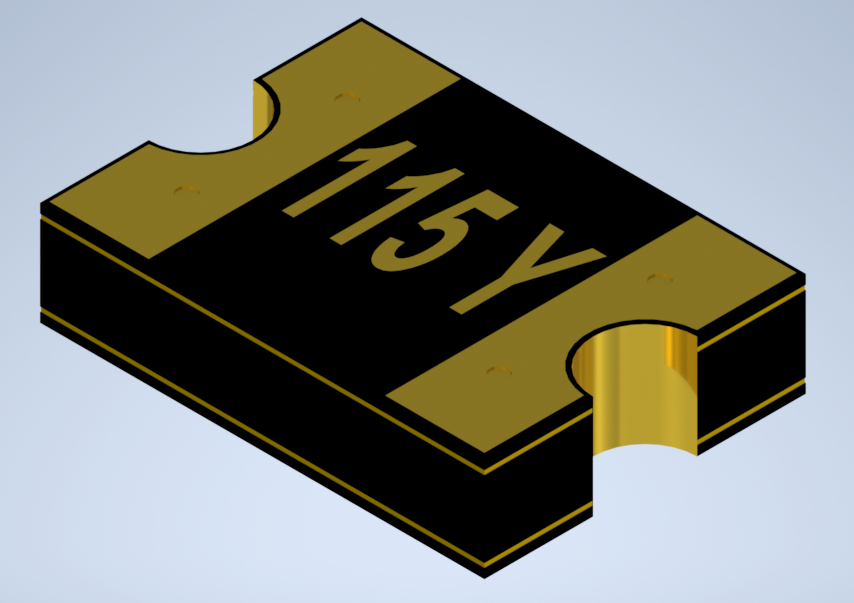
3D/Fuses/FuseSMD/Resettable Fuse/1812/smd1812.bmp
