MinhThuanLe/RAI_Lab_Kicad_Library/3D/Fuses/FuseSMD/Resettable Fuse/fuse_dimensions.PNG

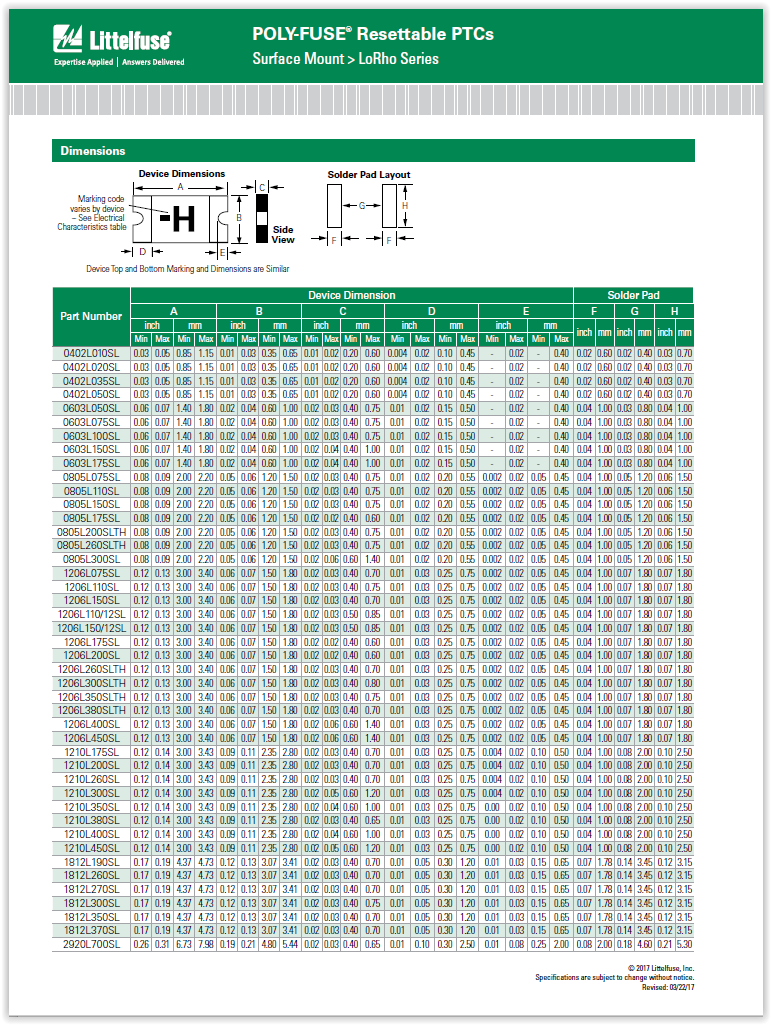
3D/Fuses/FuseSMD/Resettable Fuse/fuse_dimensions.PNG
