MinhThuanLe/RAI_Lab_Kicad_Library/3D/Inductor/SMD/GrayPowerInductor/AMPLF-MPC-ASPI.jpg

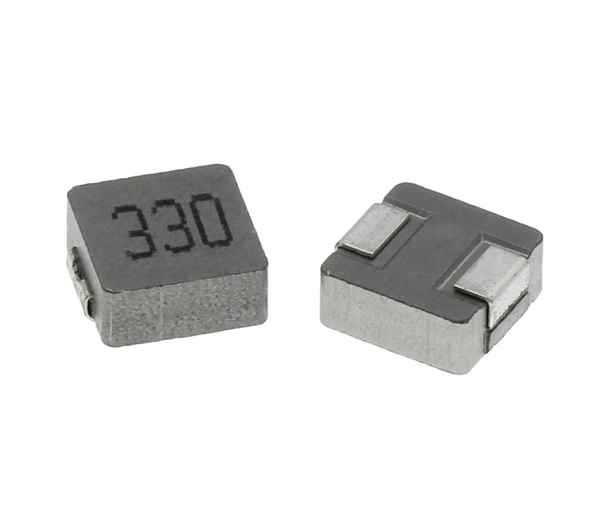
3D/Inductor/SMD/GrayPowerInductor/AMPLF-MPC-ASPI.jpg
