MinhThuanLe/RAI_Lab_Kicad_Library/3D/Inductor/SMD/GrayPowerInductor/Inductors.JPG

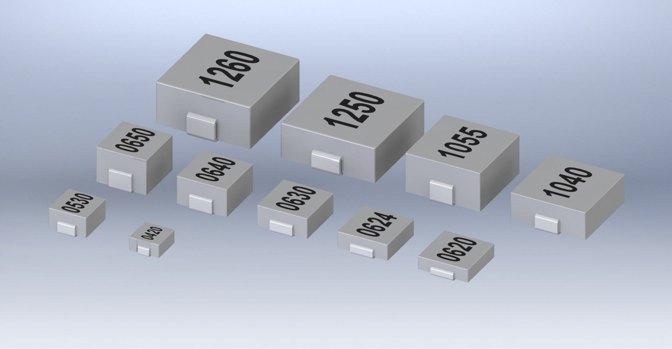
3D/Inductor/SMD/GrayPowerInductor/Inductors.JPG
