MinhThuanLe/RAI_Lab_Kicad_Library/3D/Isolation/OPTO/pc817/tải xuống.png

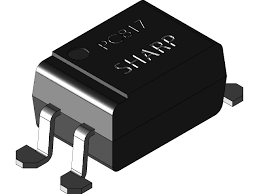
3D/Isolation/OPTO/pc817/tải xuống.png
