MinhThuanLe/RAI_Lab_Kicad_Library/3D/LCD/LCD1602/I2c board detail.jpg

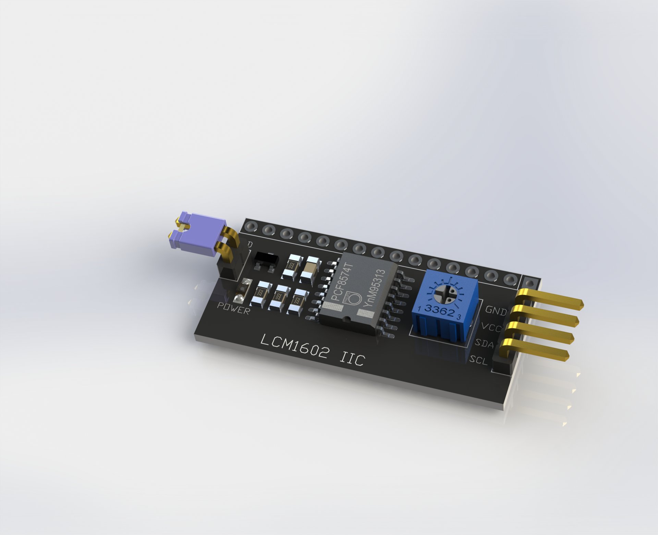
3D/LCD/LCD1602/I2c board detail.jpg
