MinhThuanLe/RAI_Lab_Kicad_Library/3D/MCU_SoC_Package/Espressif/ESP32-C3-MINI/ESP32PICOMINI02 v1501.png

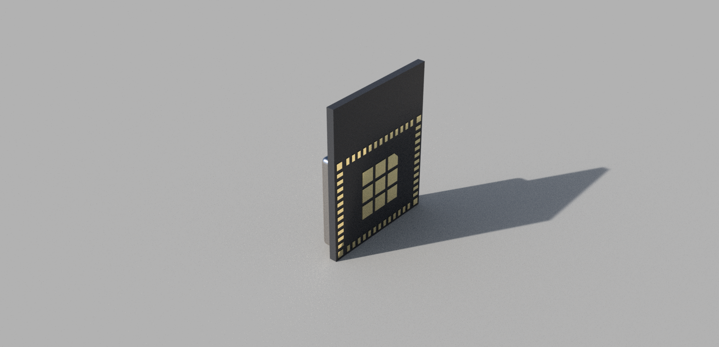
3D/MCU_SoC_Package/Espressif/ESP32-C3-MINI/ESP32PICOMINI02 v1501.png
