MinhThuanLe/RAI_Lab_Kicad_Library/3D/MCU_SoC_Package/Espressif/ESP32-C3-WROOM-02/3.png

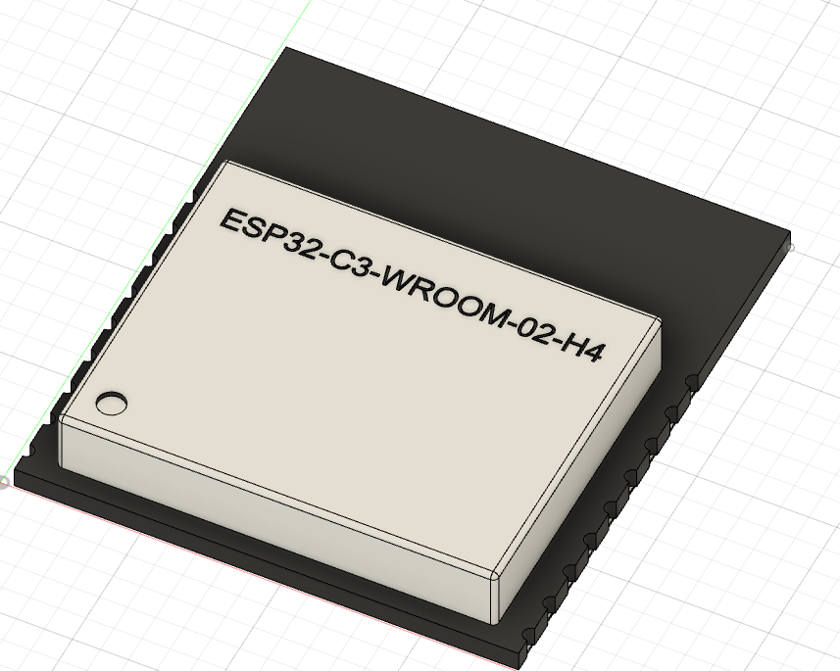
3D/MCU_SoC_Package/Espressif/ESP32-C3-WROOM-02/3.png
