MinhThuanLe/RAI_Lab_Kicad_Library/3D/MCU_SoC_Package/QFN28 5x5/QFN28.PNG

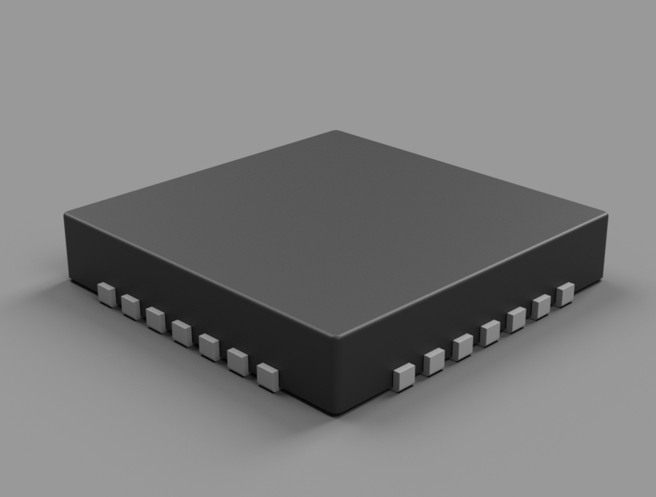
3D/MCU_SoC_Package/QFN28 5x5/QFN28.PNG
