MinhThuanLe/RAI_Lab_Kicad_Library/3D/MCU_SoC_Package/QFN/QFN-40_5x5.PNG

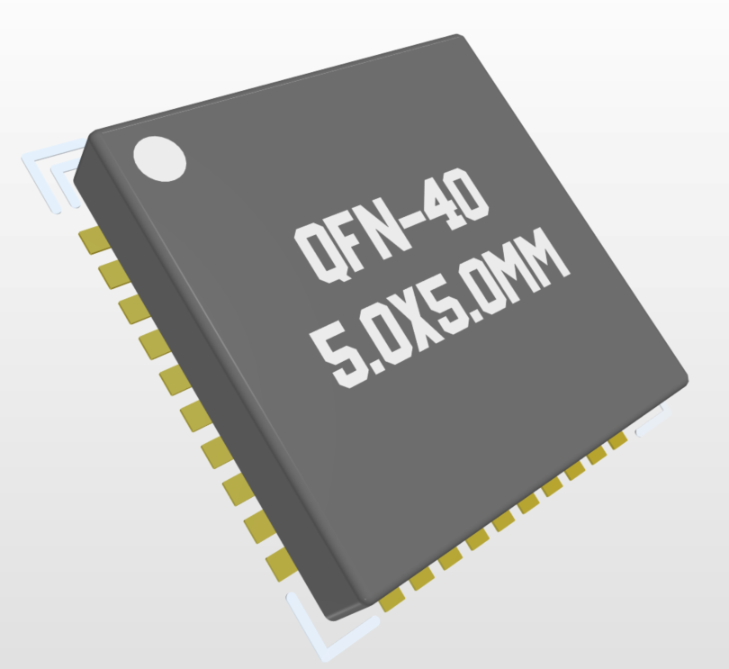
3D/MCU_SoC_Package/QFN/QFN-40_5x5.PNG
