MinhThuanLe/RAI_Lab_Kicad_Library/3D/MCU_SoC_Package/QFN/QFN_family.PNG

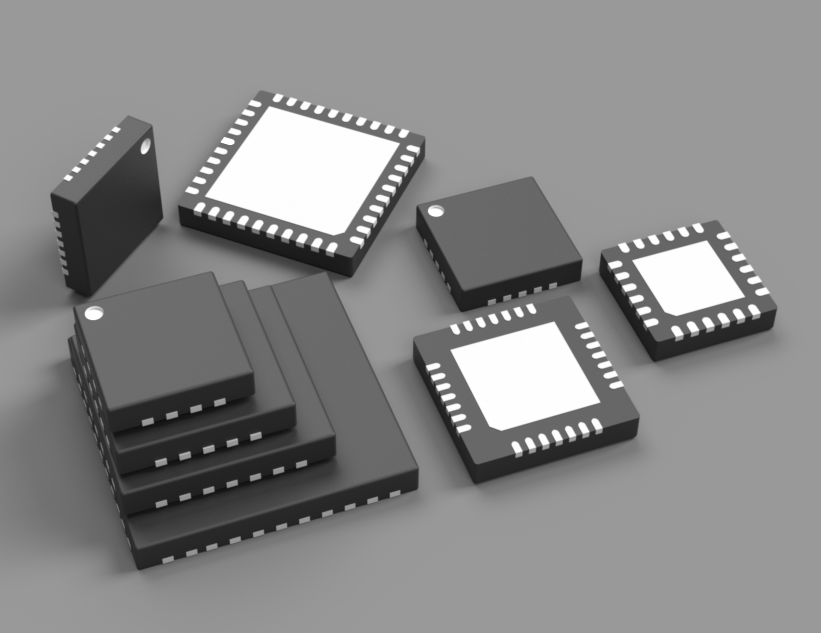
3D/MCU_SoC_Package/QFN/QFN_family.PNG
