MinhThuanLe/RAI_Lab_Kicad_Library/3D/MCU_SoC_Package/SOIC_package/SOIC_Render.JPG

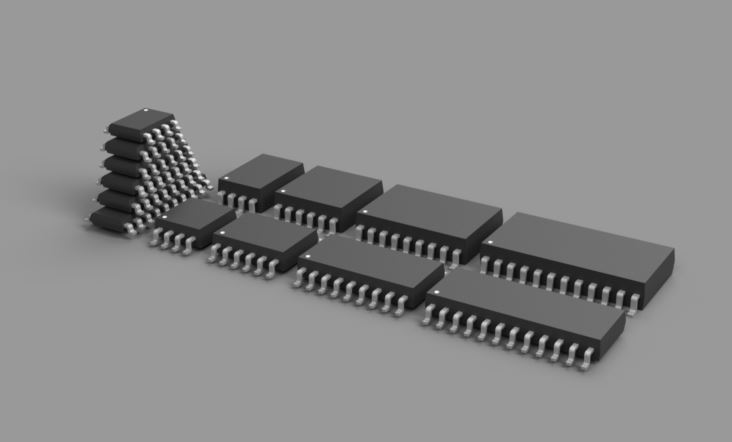
3D/MCU_SoC_Package/SOIC_package/SOIC_Render.JPG
