MinhThuanLe/RAI_Lab_Kicad_Library/3D/MCU_SoC_Package/SOP4/DiodeBridge/SOIC-4 (Fairchild) 02.JPG

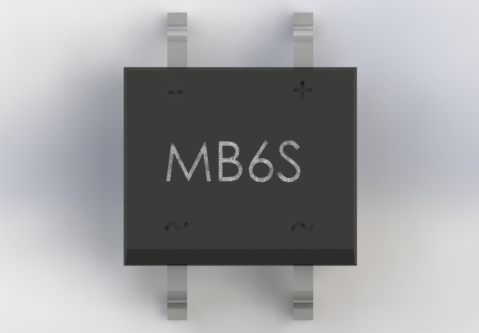
3D/MCU_SoC_Package/SOP4/DiodeBridge/SOIC-4 (Fairchild) 02.JPG
