MinhThuanLe/RAI_Lab_Kicad_Library/3D/MCU_SoC_Package/SOP4/SOP-5-4.png

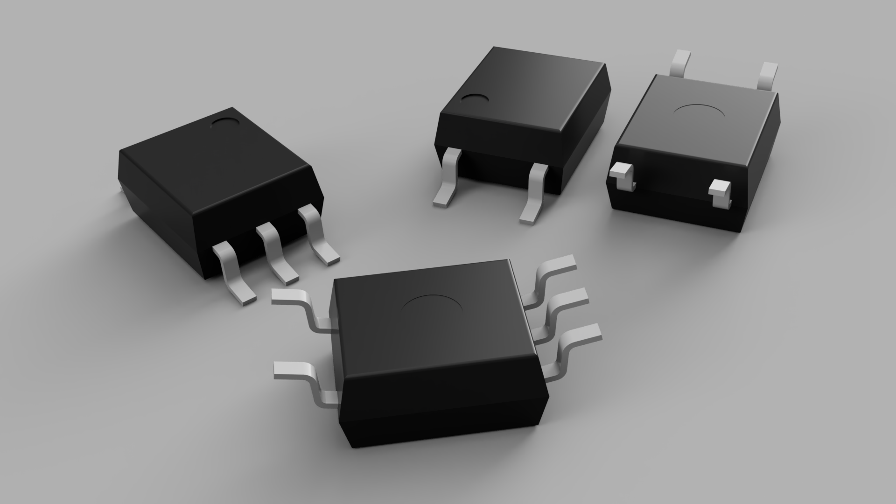
3D/MCU_SoC_Package/SOP4/SOP-5-4.png
