MinhThuanLe/RAI_Lab_Kicad_Library/3D/MCU_SoC_Package/SOT23-5/SOT-23_5pins iso rendering.JPG

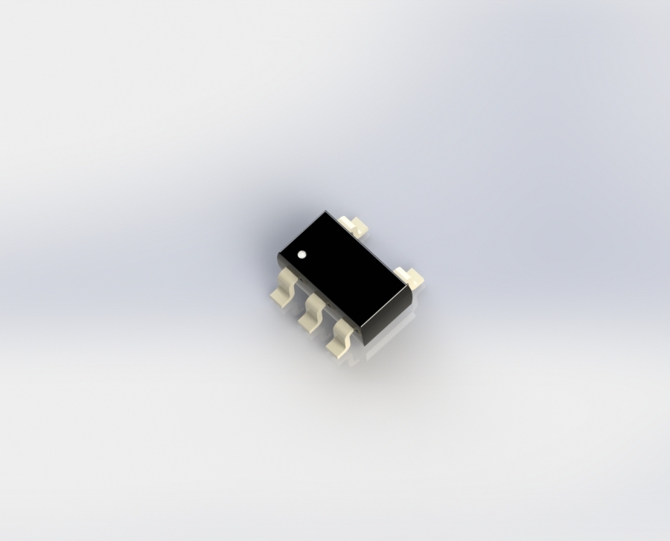
3D/MCU_SoC_Package/SOT23-5/SOT-23_5pins iso rendering.JPG
