MinhThuanLe/RAI_Lab_Kicad_Library/3D/MCU_SoC_Package/SOT23/SOT23.jpg

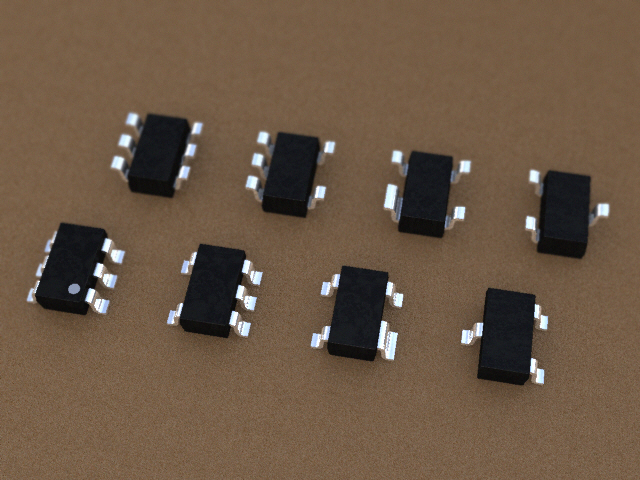
3D/MCU_SoC_Package/SOT23/SOT23.jpg
