MinhThuanLe/RAI_Lab_Kicad_Library/3D/MCU_SoC_Package/SOT223/large.png

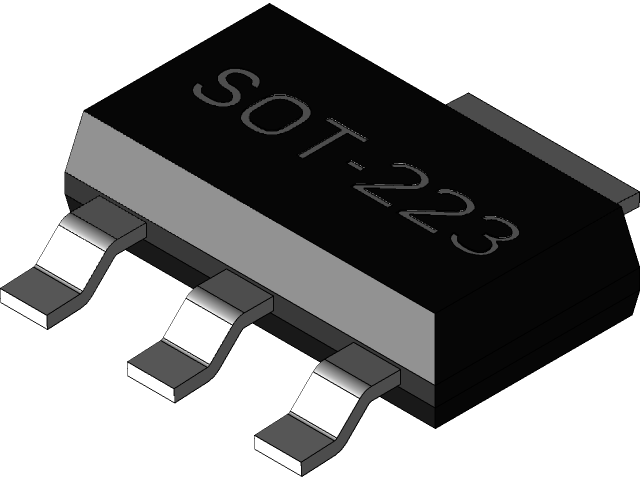
3D/MCU_SoC_Package/SOT223/large.png
