MinhThuanLe/RAI_Lab_Kicad_Library/3D/MCU_SoC_Package/SOT363/1.PNG

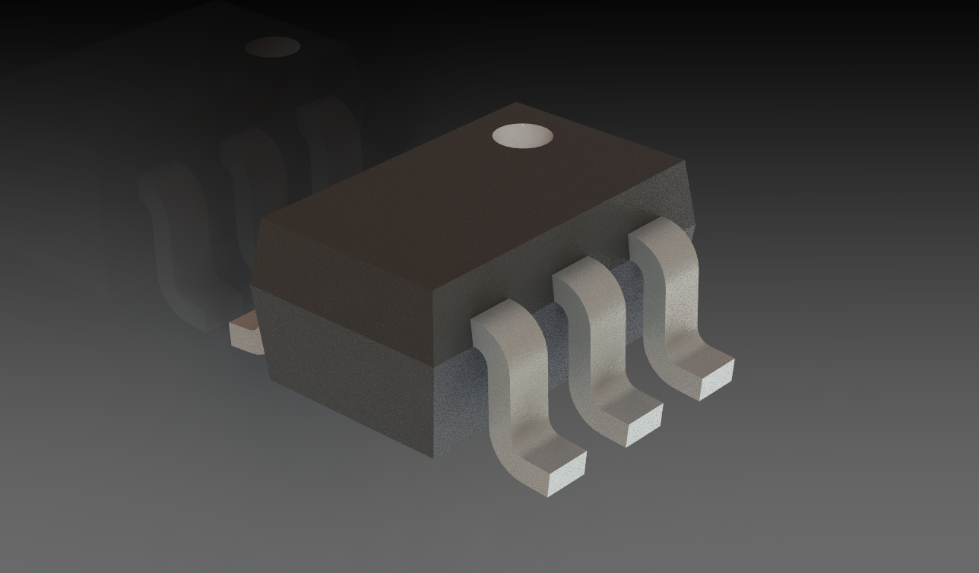
3D/MCU_SoC_Package/SOT363/1.PNG
