MinhThuanLe/RAI_Lab_Kicad_Library/3D/MCU_SoC_Package/SSOP28/Renderings/untitled.118.jpg

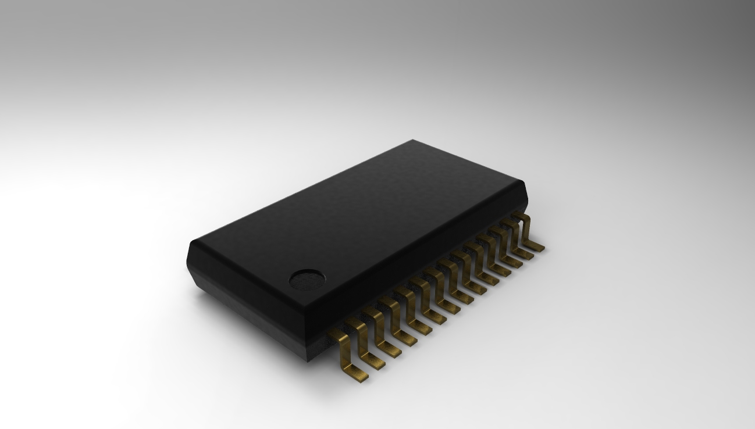
3D/MCU_SoC_Package/SSOP28/Renderings/untitled.118.jpg
