MinhThuanLe/RAI_Lab_Kicad_Library/3D/MCU_SoC_Package/STM32F103C8T6 chip/STM32.PNG

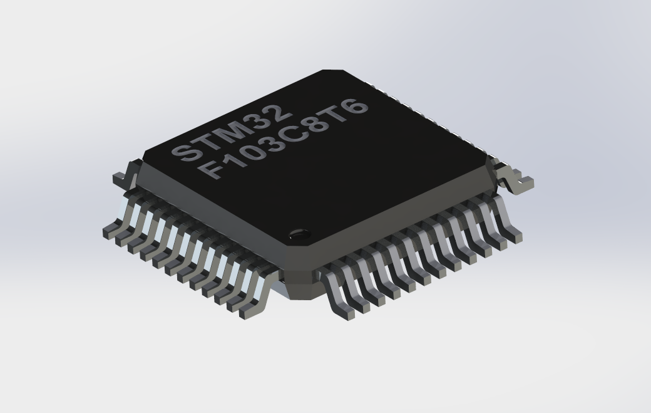
3D/MCU_SoC_Package/STM32F103C8T6 chip/STM32.PNG
