MinhThuanLe/RAI_Lab_Kicad_Library/3D/MCU_SoC_Package/TO247/TO247.jpg

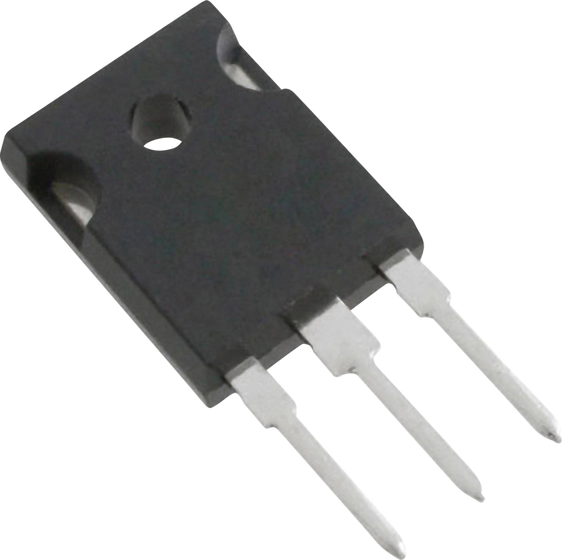
3D/MCU_SoC_Package/TO247/TO247.jpg
