MinhThuanLe/RAI_Lab_Kicad_Library/3D/MCU_SoC_Package/TO252/TO252_2/tải xuống.png

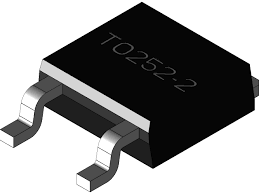
3D/MCU_SoC_Package/TO252/TO252_2/tải xuống.png
