MinhThuanLe/RAI_Lab_Kicad_Library/3D/MCU_SoC_Package/TQFP_32pin/Package, TQFP, 32, 7x7x1mm.JPG

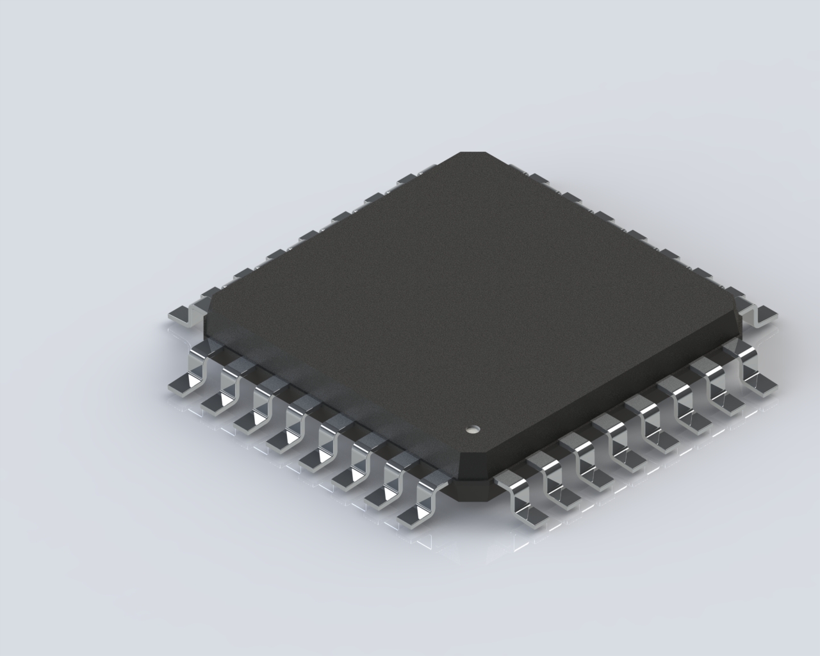
3D/MCU_SoC_Package/TQFP_32pin/Package, TQFP, 32, 7x7x1mm.JPG
