MinhThuanLe/RAI_Lab_Kicad_Library/3D/MCU_SoC_Package/TSSOP/TSSOP .jpg

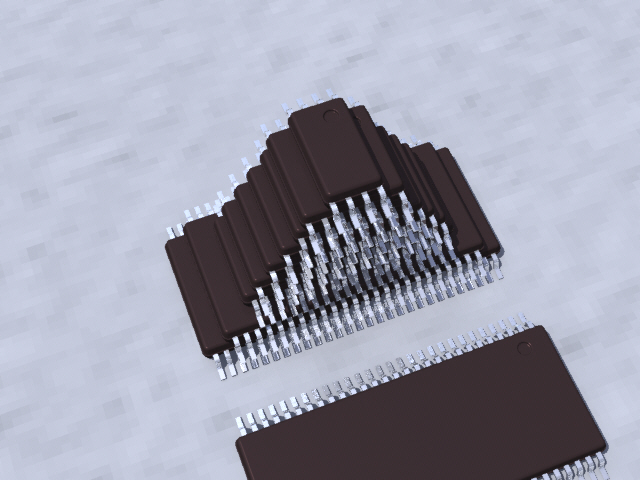
3D/MCU_SoC_Package/TSSOP/TSSOP .jpg
