MinhThuanLe/RAI_Lab_Kicad_Library/3D/Module/DepKitESP32/Goouuu-ESP32 Development Board - ISO.JPG

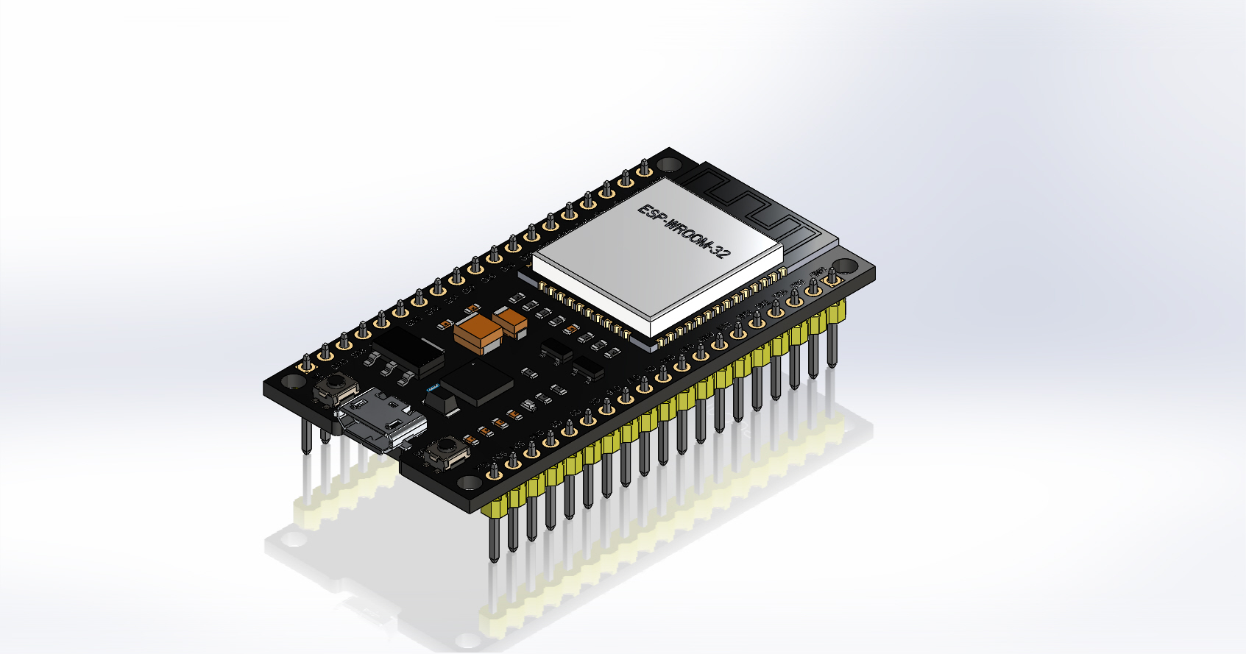
3D/Module/DepKitESP32/Goouuu-ESP32 Development Board - ISO.JPG
