MinhThuanLe/RAI_Lab_Kicad_Library/3D/Module/LCD/LCD_20x4_I2C_PCF8574/LCD Display 2.PNG

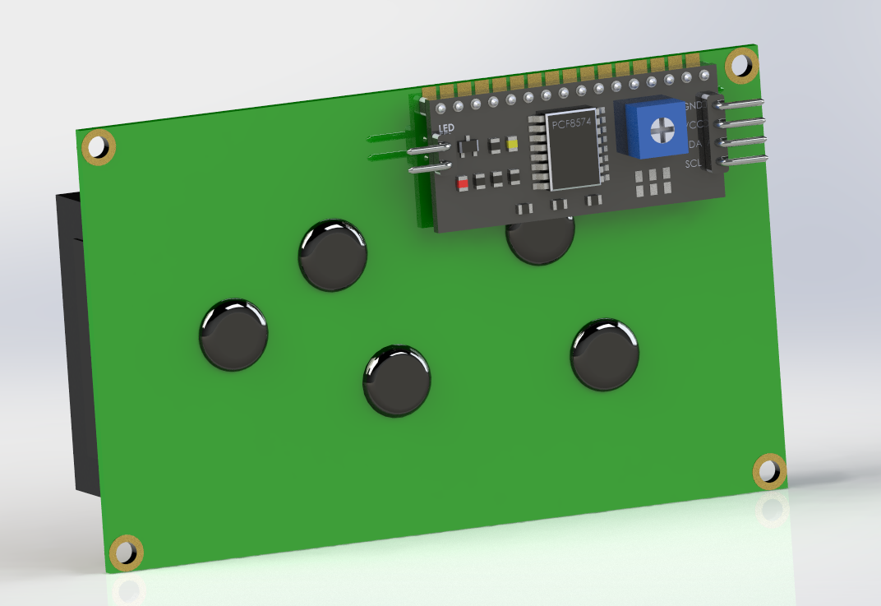
3D/Module/LCD/LCD_20x4_I2C_PCF8574/LCD Display 2.PNG
