MinhThuanLe/RAI_Lab_Kicad_Library/3D/Module/LCD/LCD_20x4_I2C_PCF8574/LCD Display.PNG

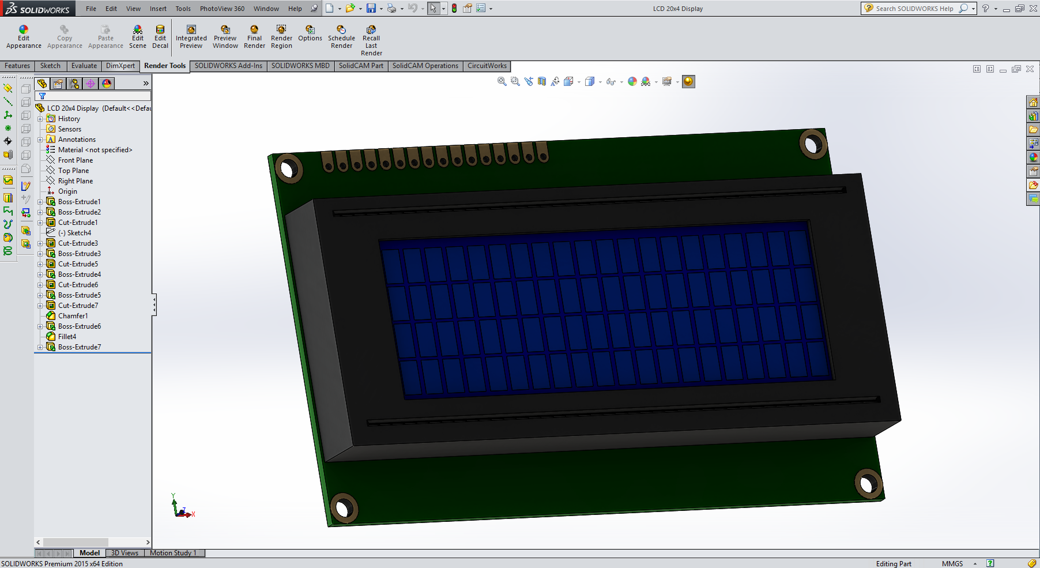
3D/Module/LCD/LCD_20x4_I2C_PCF8574/LCD Display.PNG
