MinhThuanLe/RAI_Lab_Kicad_Library/3D/Module/LCD/WG12864A_LCD128x64/wg12864a.jpg

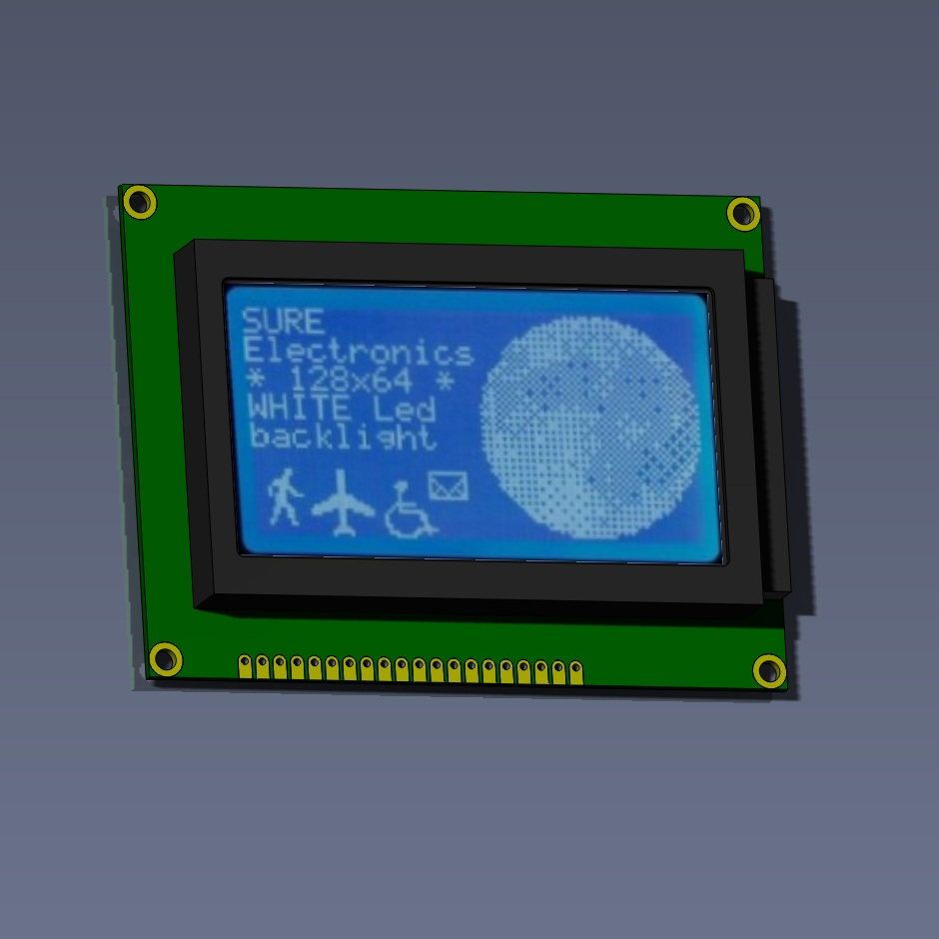
3D/Module/LCD/WG12864A_LCD128x64/wg12864a.jpg
