MinhThuanLe/RAI_Lab_Kicad_Library/3D/Module/RTL8720BW16/BW16_back.png

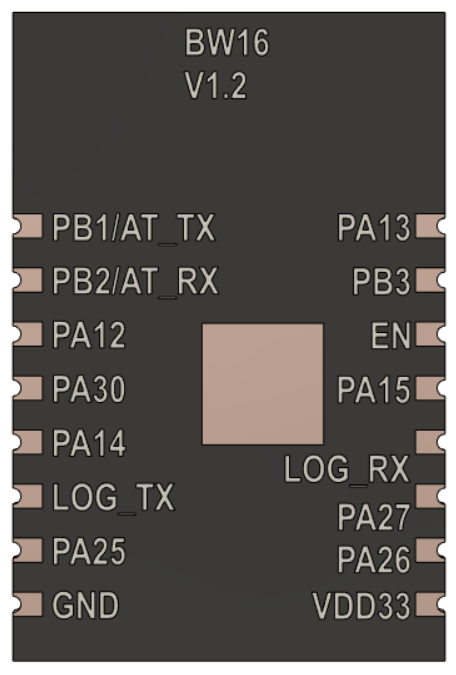
3D/Module/RTL8720BW16/BW16_back.png
