MinhThuanLe/RAI_Lab_Kicad_Library/3D/Module/STM32F1C8T6/STM32F103C8T6_Blue_Pill v6.png

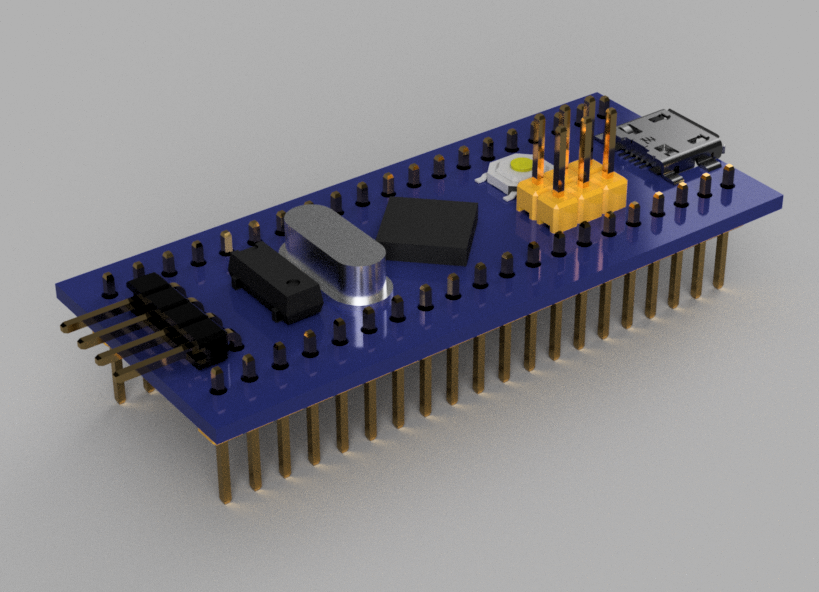
3D/Module/STM32F1C8T6/STM32F103C8T6_Blue_Pill v6.png
