MinhThuanLe/RAI_Lab_Kicad_Library/3D/Potentiometer/RM065/Poti_10kohm.jpg

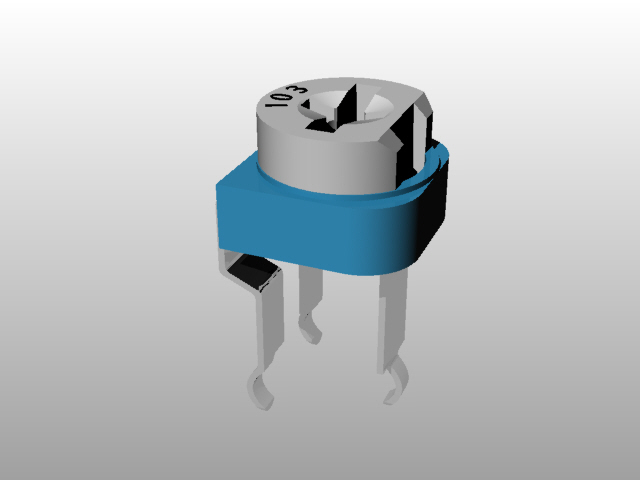
3D/Potentiometer/RM065/Poti_10kohm.jpg
