MinhThuanLe/RAI_Lab_Kicad_Library/3D/Potentiometer/TC-33X-2/Renderings/AB2_POT_TRIM_SIDE.png

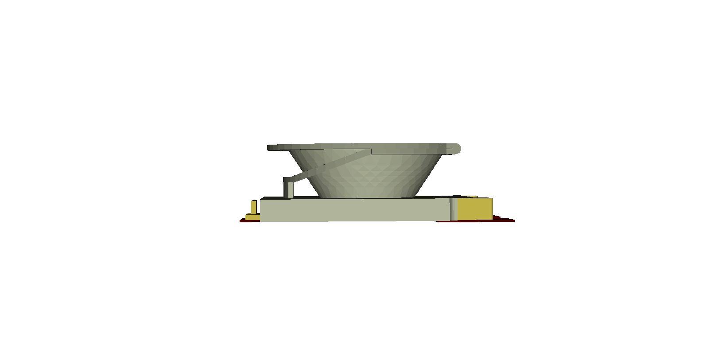
3D/Potentiometer/TC-33X-2/Renderings/AB2_POT_TRIM_SIDE.png
