MinhThuanLe/RAI_Lab_Kicad_Library/3D/Potentiometer/Trimmer 3296/Trimmer 3296.JPG

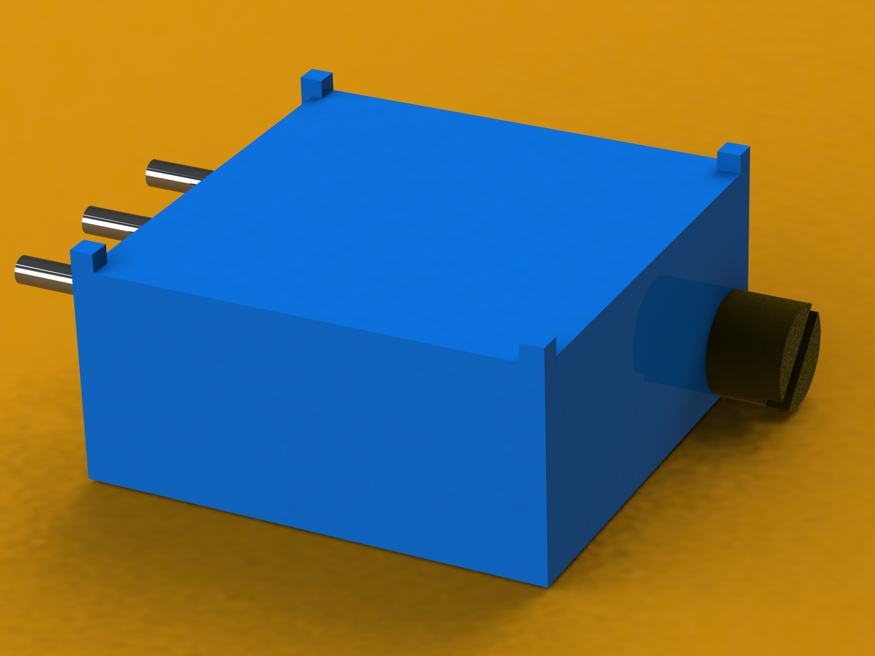
3D/Potentiometer/Trimmer 3296/Trimmer 3296.JPG
