MinhThuanLe/RAI_Lab_Kicad_Library/3D/Potentiometer/WH148-3P/4067.jpg

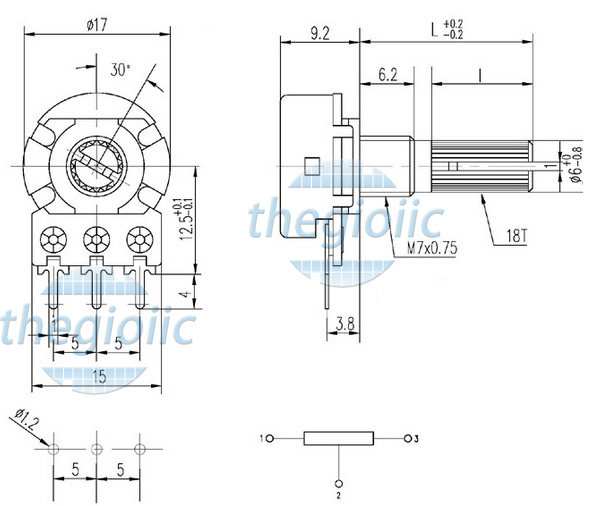
3D/Potentiometer/WH148-3P/4067.jpg
