MinhThuanLe/RAI_Lab_Kicad_Library/3D/Power/DCDC_converter/Isolate/1W/34749.jpg

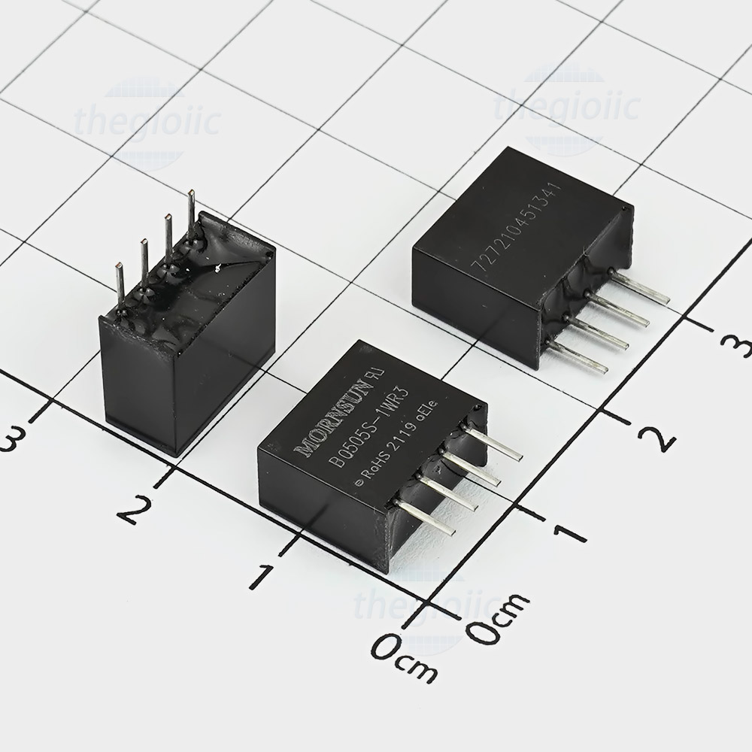
3D/Power/DCDC_converter/Isolate/1W/34749.jpg
