MinhThuanLe/RAI_Lab_Kicad_Library/3D/Switch_Button/Button/DIP/PTS125S_12x12/12mm x 12mm Tactile switch front view.png

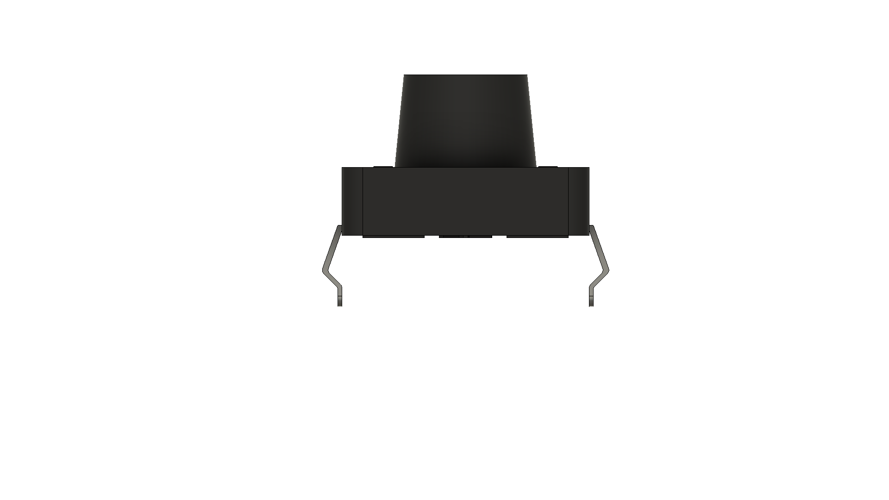
3D/Switch_Button/Button/DIP/PTS125S_12x12/12mm x 12mm Tactile switch front view.png
