MinhThuanLe/RAI_Lab_Kicad_Library/3D/Switch_Button/Button/SMD/PTS125S_12x12/12x12mm SMD Assortment.PNG

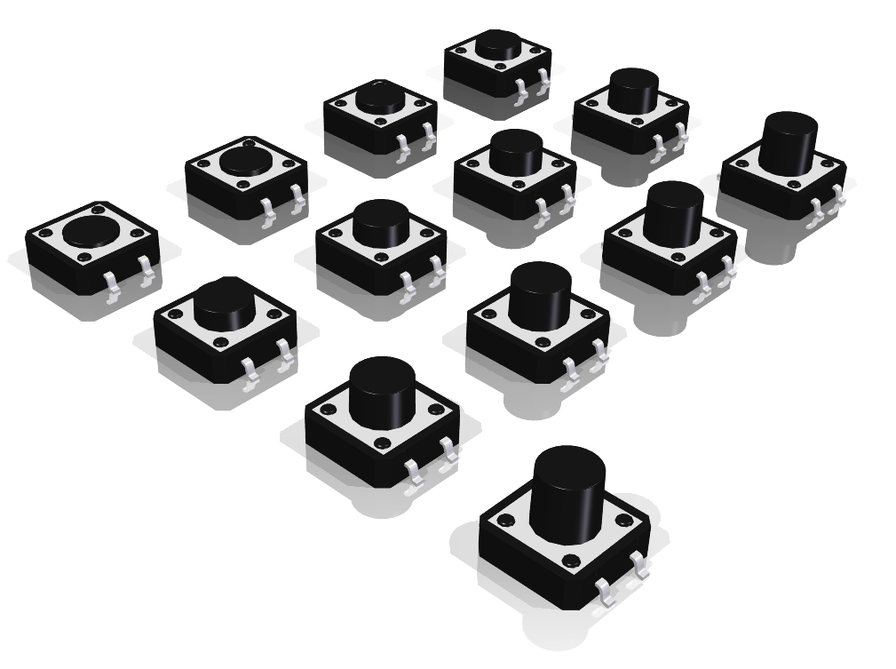
3D/Switch_Button/Button/SMD/PTS125S_12x12/12x12mm SMD Assortment.PNG
