MinhThuanLe/RAI_Lab_Kicad_Library/3D/Switch_Button/Button/SMD/PTS810_SKRPABE010_Button/Untitled.JPG

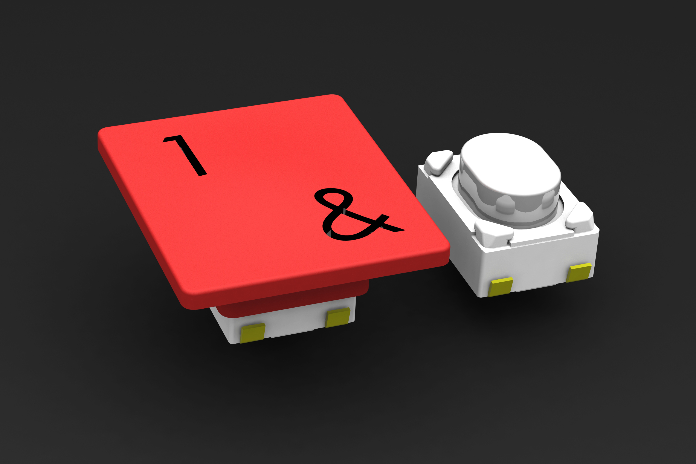
3D/Switch_Button/Button/SMD/PTS810_SKRPABE010_Button/Untitled.JPG
