MinhThuanLe/RAI_Lab_Kicad_Library/3D/Switch_Button/Button_SMD/21894.jpg

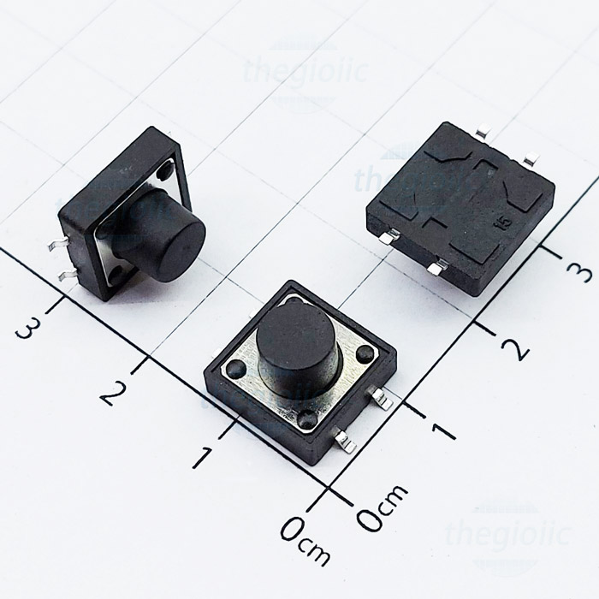
3D/Switch_Button/Button_SMD/21894.jpg
