MinhThuanLe/RAI_Lab_Kicad_Library/3D/Switch_Button/DIP Switch SMD 1Pto12P 2.54mm/SMD DIP SWITCH RENDER.png

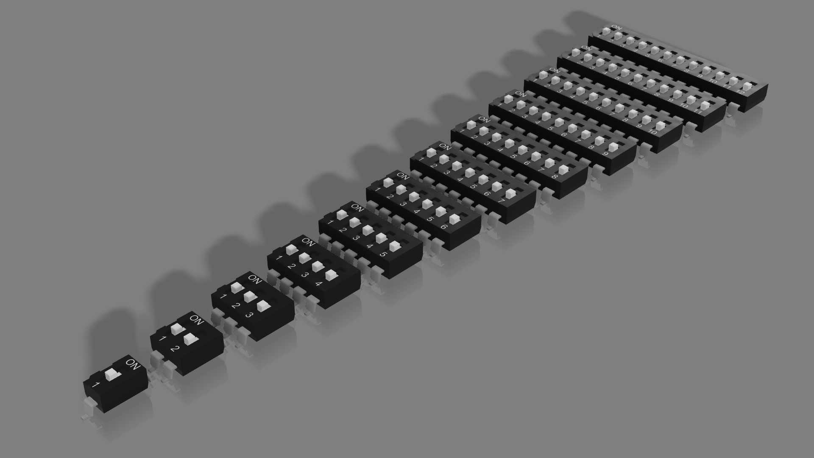
3D/Switch_Button/DIP Switch SMD 1Pto12P 2.54mm/SMD DIP SWITCH RENDER.png
