MinhThuanLe/RAI_Lab_Kicad_Library/3D/Switch_Button/DIP/SlideSwitch_SPDT/09609-01.jpg

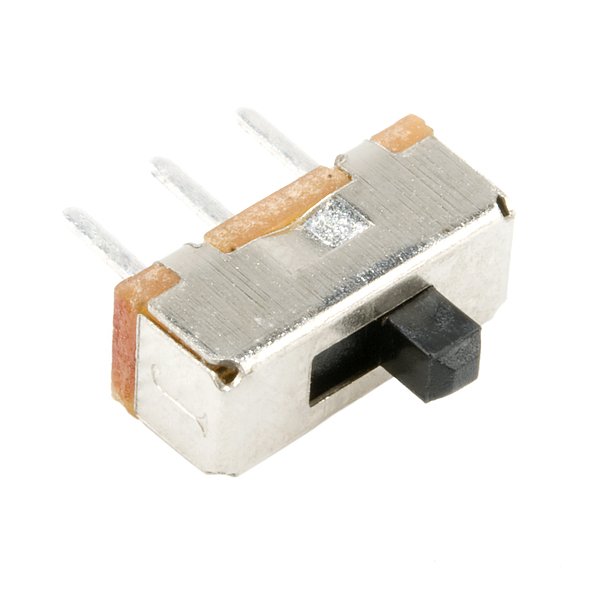
3D/Switch_Button/DIP/SlideSwitch_SPDT/09609-01.jpg
