MinhThuanLe/RAI_Lab_Kicad_Library/3D/Switch_Button/Selector_Switch/Selector Switch Assortment.PNG

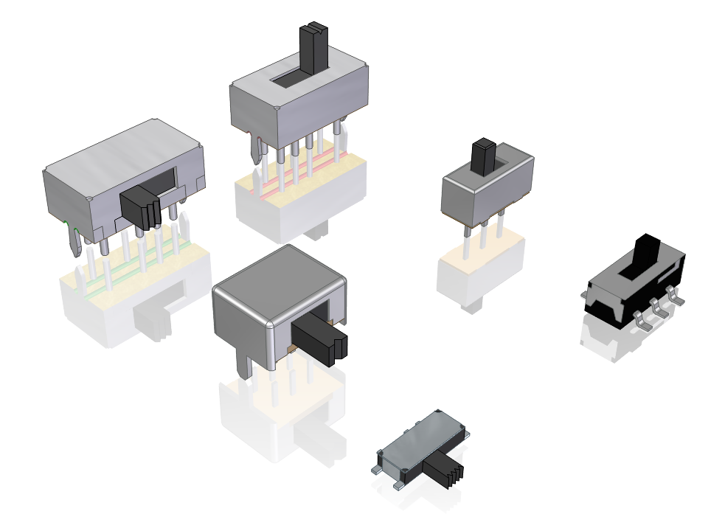
3D/Switch_Button/Selector_Switch/Selector Switch Assortment.PNG
