MinhThuanLe/RAI_Lab_Kicad_Library/3D/Switch_Button/Slide Switch SMD/Renderings/10860-01.jpg

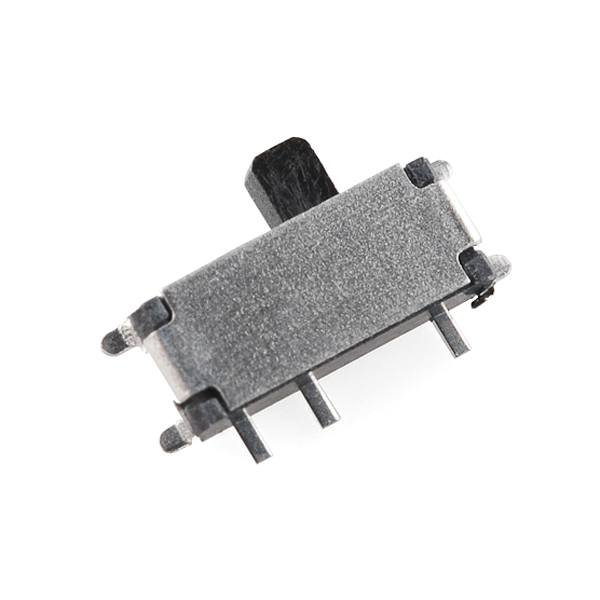
3D/Switch_Button/Slide Switch SMD/Renderings/10860-01.jpg
