MinhThuanLe/RAI_Lab_Kicad_Library/3D/Switch_Button/Slide Switch SMD/Renderings/switch.PNG

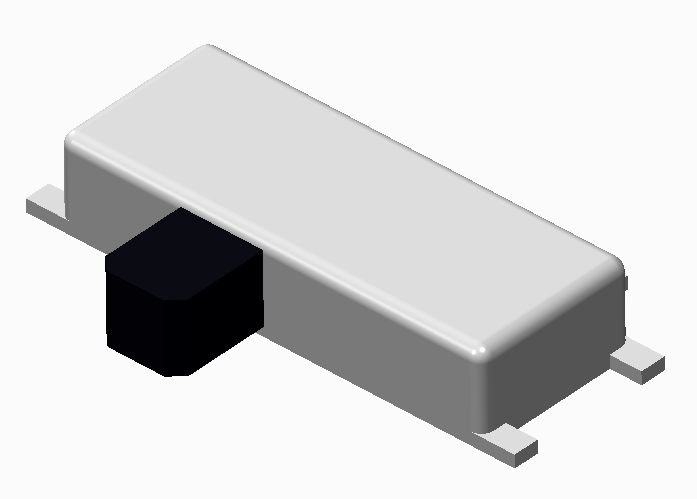
3D/Switch_Button/Slide Switch SMD/Renderings/switch.PNG
