MinhThuanLe/RAI_Lab_Kicad_Library/3D/Switch_Button/Switch/DIP/MFG_JS203011CQN.jpg

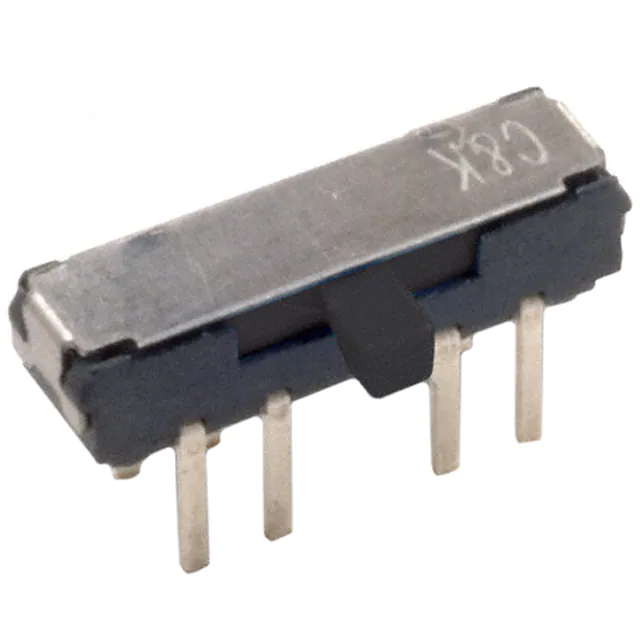
3D/Switch_Button/Switch/DIP/MFG_JS203011CQN.jpg
