MinhThuanLe/RAI_Lab_Kicad_Library/3D/Switch_Button/Switch/DIP/MSS22D18.jpg

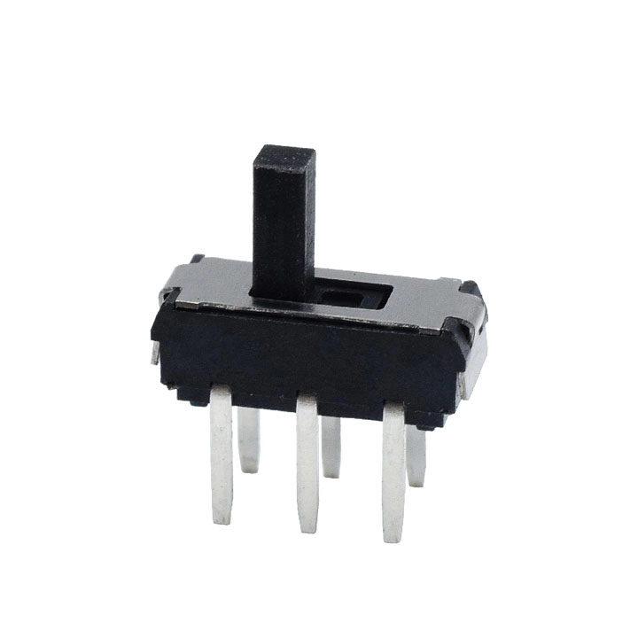
3D/Switch_Button/Switch/DIP/MSS22D18.jpg
