MinhThuanLe/RAI_Lab_Kicad_Library/3D/Switch_Button/Switch/DIP/SK22D07.jpg

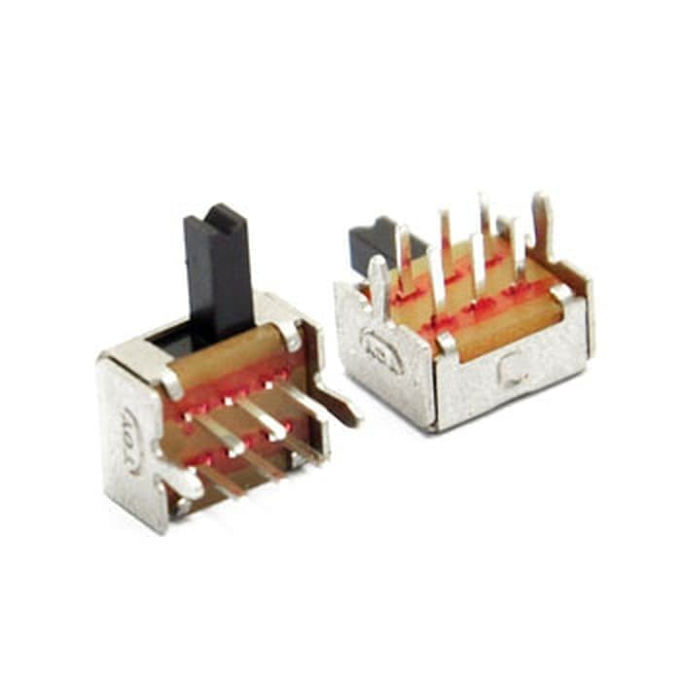
3D/Switch_Button/Switch/DIP/SK22D07.jpg
