MinhThuanLe/RAI_Lab_Kicad_Library/3D/Switch_Button/Switch/DIP/SS12D00.jpg

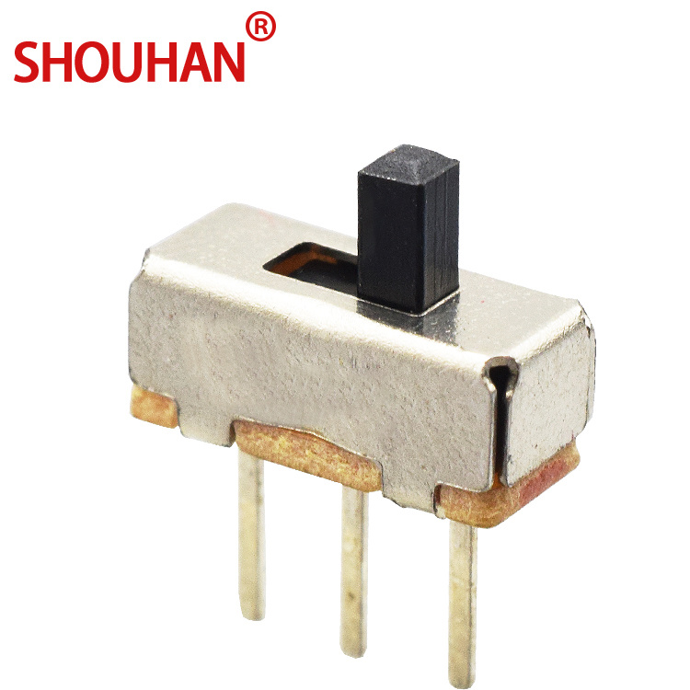
3D/Switch_Button/Switch/DIP/SS12D00.jpg
