MinhThuanLe/RAI_Lab_Kicad_Library/3D/Connector/Header/Header 1.27mm/Male 1.27mm 2Row SMD/1_27mm_single_pin_assembled.STEP

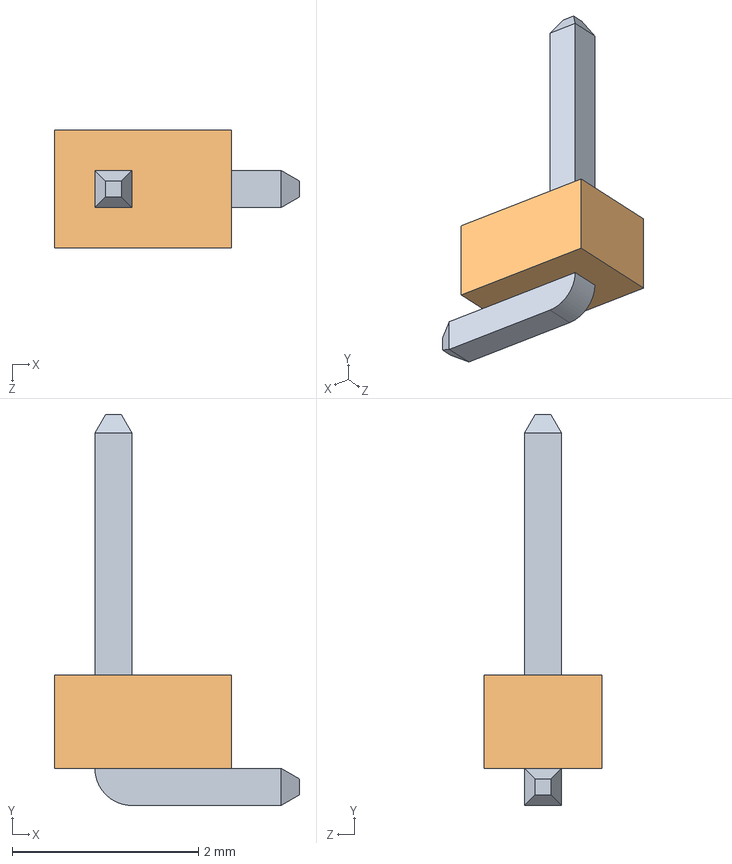
[picture p166: CAD file, 2025-10-22]
3D/Connector/Header/Header 1.27mm/Male 1.27mm 2Row SMD/1_27mm_single_pin_assembled.STEP
2.64 x 4.20 x 1.27 mm
1_27mm_pin_right_angle
1_27mm_plastic_for_pin
