MinhThuanLe/RAI_Lab_Kicad_Library/3D/Connector/SIMCardHolder/NanoSIM/Molex/78800001/SIM, Micro, 78800001, ASSY.STEP

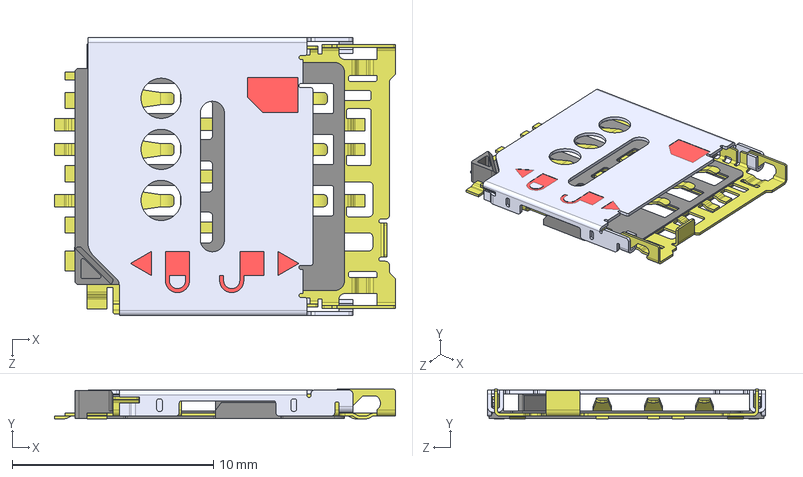
[picture p167: CAD file, 2025-10-22]
3D/Connector/SIMCardHolder/NanoSIM/Molex/78800001/SIM, Micro, 78800001, ASSY.STEP
17.0 x 1.47 x 13.9 mm
SIM, Micro, 78800001, Base
SIM, Micro, 78800001, Contacts
SIM, Micro, 78800001, Lid
