MinhThuanLe/RAI_Lab_Kicad_Library/3D/Module/LCD/LCD_20x4_I2C_PCF8574/LCD Assem.SLDASM

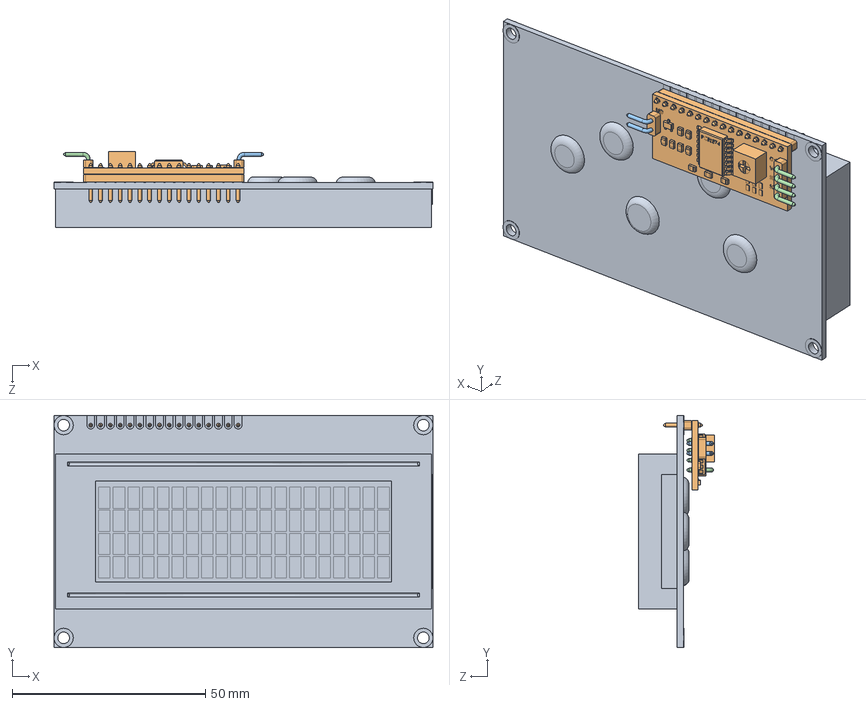
[picture p169: CAD file, 2025-10-22]
3D/Module/LCD/LCD_20x4_I2C_PCF8574/LCD Assem.SLDASM
98.0 x 60.0 x 19.6 mm
LCD 20x4 Display
I2C LCD Adapter PCF8574
2 way header curved
4 way header curved
