MinhThuanLe/RAI_Lab_Kicad_Library/3D/Switch_Button/Button/SMD/PTS810_SKRPABE010_Button/keycapall.SLDASM

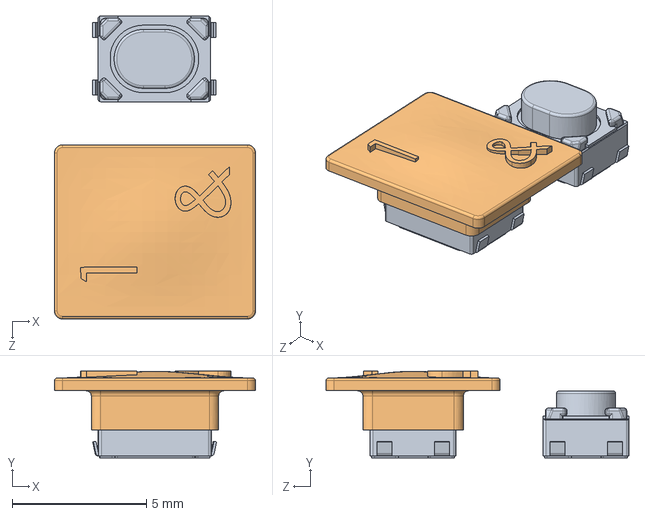
[picture p170: CAD file, 2025-10-22]
3D/Switch_Button/Button/SMD/PTS810_SKRPABE010_Button/keycapall.SLDASM
7.50 x 3.23 x 11.3 mm
SKRPABE010 x 2
keycap
