MinhThuanLe/RAI_Lab_Kicad_Library/3D/Module/LCD/LCD16x2 Display with Driver I2C/LCD WITH IIC/i2c board.SLDASM

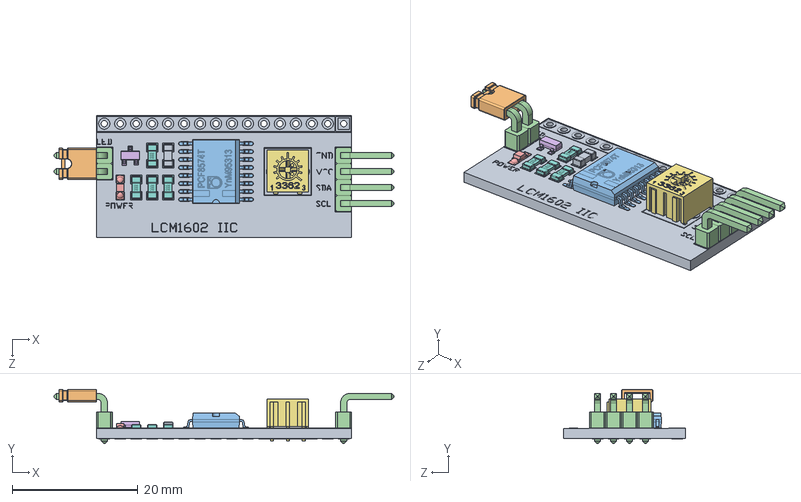
[picture p173: CAD file, 2025-10-22]
3D/Module/LCD/LCD16x2 Display with Driver I2C/LCD WITH IIC/i2c board.SLDASM
54.1 x 8.62 x 19.4 mm
i2C board
jumper__
pcf8574p
bent header x 6
led
ssot3
trimpot 3662
smt_resistor222 x 4
smt_cap
