MinhThuanLe/RAI_Lab_Kicad_Library/3D/BatteryHolder/14500_BatteryHolder/ICR 14500.stp

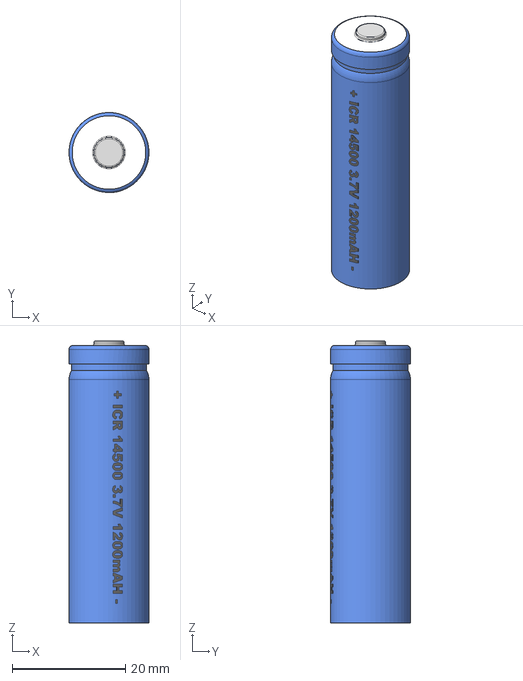
[picture p175: CAD file, 2025-10-22]
3D/BatteryHolder/14500_BatteryHolder/ICR 14500.stp
14.1 x 14.1 x 49.7 mm
