MinhThuanLe/RAI_Lab_Kicad_Library/3D/BatteryHolder/SINGLE AA BATHOLDER/SINGLE AA BATHOLDER.SLDPRT

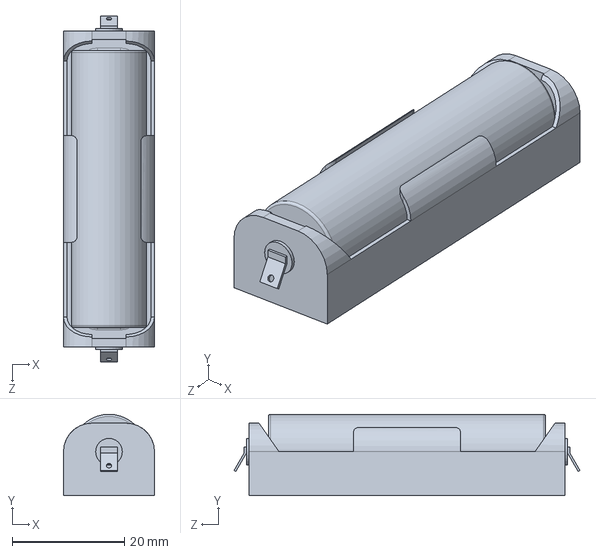
[picture p178: CAD file, 2025-10-22]
3D/BatteryHolder/SINGLE AA BATHOLDER/SINGLE AA BATHOLDER.SLDPRT
16.3 x 14.5 x 61.8 mm
