MinhThuanLe/RAI_Lab_Kicad_Library/3D/Buzzer/Buzzer 9 mm.STEP

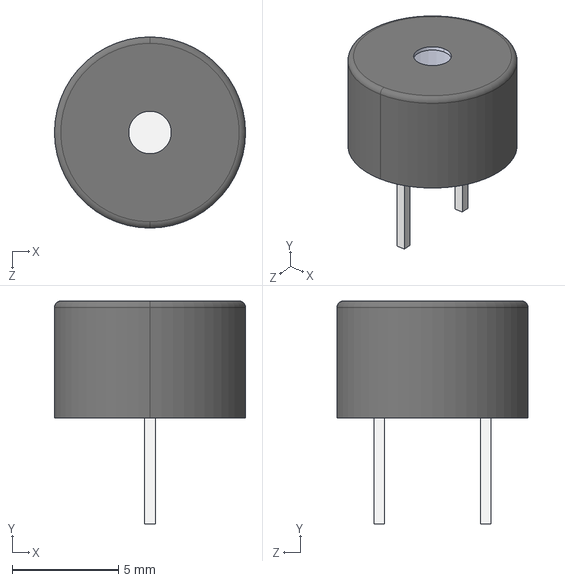
[picture p179: CAD file, 2025-10-22]
3D/Buzzer/Buzzer 9 mm.STEP
9.00 x 10.5 x 9.00 mm
