MinhThuanLe/RAI_Lab_Kicad_Library/3D/Capacitor/Cap_SMD/AluminumCap/100uF 35V.STEP

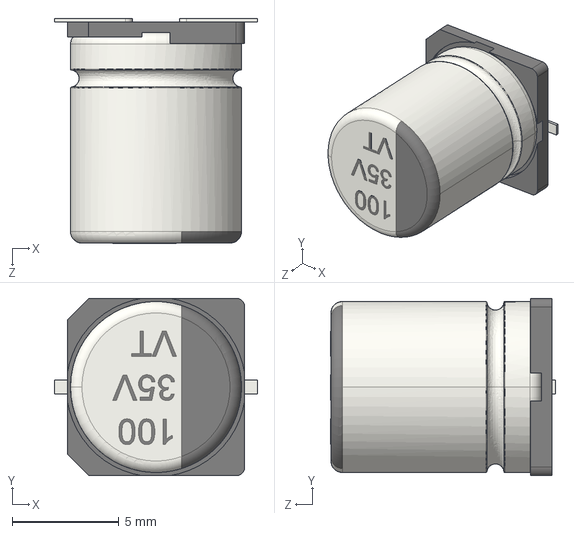
[picture p180: CAD file, 2025-10-22]
3D/Capacitor/Cap_SMD/AluminumCap/100uF 35V.STEP
9.50 x 8.30 x 10.5 mm
