MinhThuanLe/RAI_Lab_Kicad_Library/3D/Capacitor/Cap_SMD/CAP/csmd-2225_l5-72_w6-35_h2-79.stp

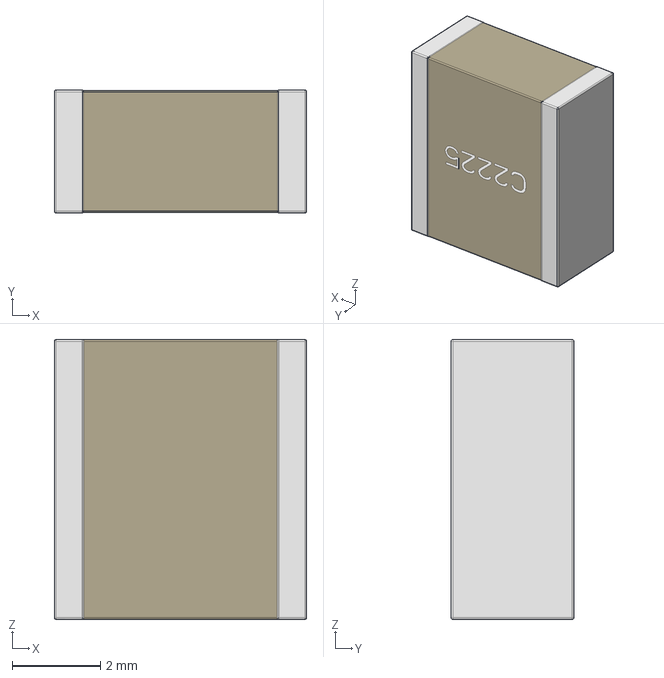
[picture p181: CAD file, 2025-10-22]
3D/Capacitor/Cap_SMD/CAP/csmd-2225_l5-72_w6-35_h2-79.stp
5.72 x 2.79 x 6.35 mm
