MinhThuanLe/RAI_Lab_Kicad_Library/3D/Capacitor/Cap_SMD/CAP/Film Capacitor P10/FILM_GREY_P1000L1300W600H1200PD80.stp

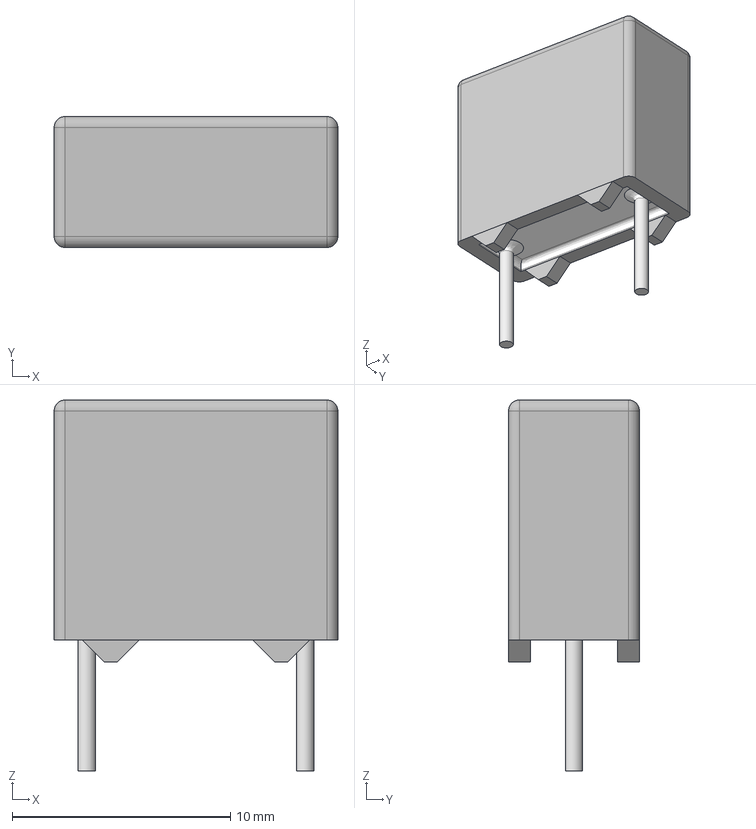
[picture p182: CAD file, 2025-10-22]
3D/Capacitor/Cap_SMD/CAP/Film Capacitor P10/FILM_GREY_P1000L1300W600H1200PD80.stp
13.0 x 6.00 x 17.0 mm
