MinhThuanLe/RAI_Lab_Kicad_Library/3D/Capacitor/Cap_SMD/CAP/Film Capacitor P22.5/FILM_GREY_P2250L2650W1100H2000PD80.stp

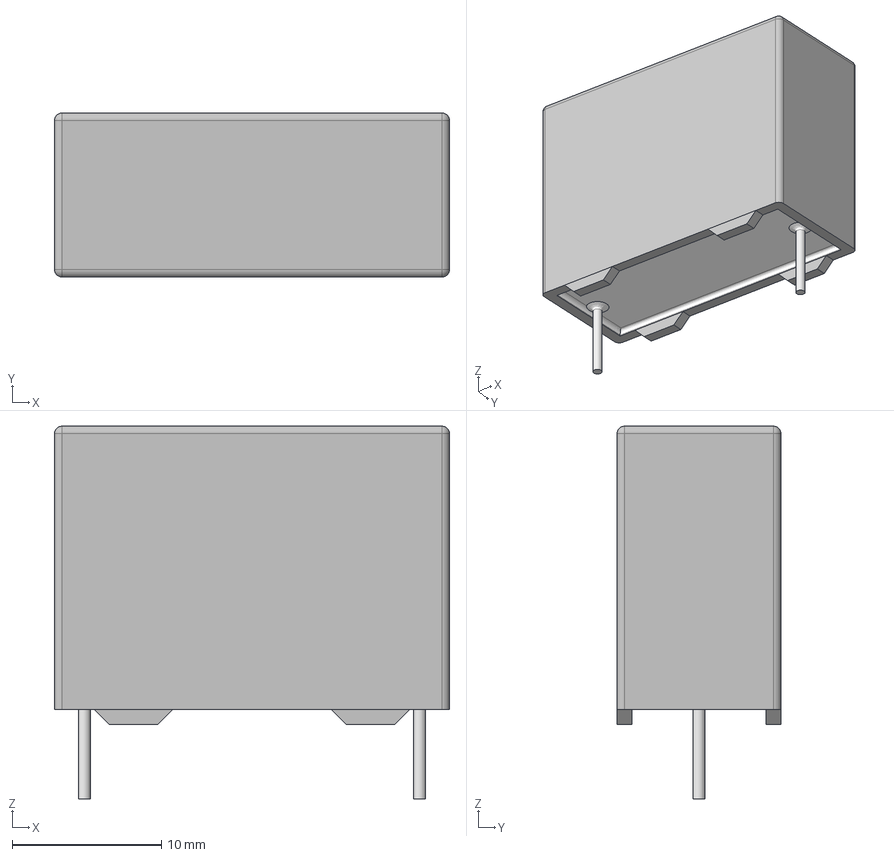
[picture p183: CAD file, 2025-10-22]
3D/Capacitor/Cap_SMD/CAP/Film Capacitor P22.5/FILM_GREY_P2250L2650W1100H2000PD80.stp
26.5 x 11.0 x 25.0 mm
