MinhThuanLe/RAI_Lab_Kicad_Library/3D/Capacitor/Cap_SMD/CAP/Film Capacitor P37.5/FILM_GREY_P3750L4150W2000H4000PD100.stp

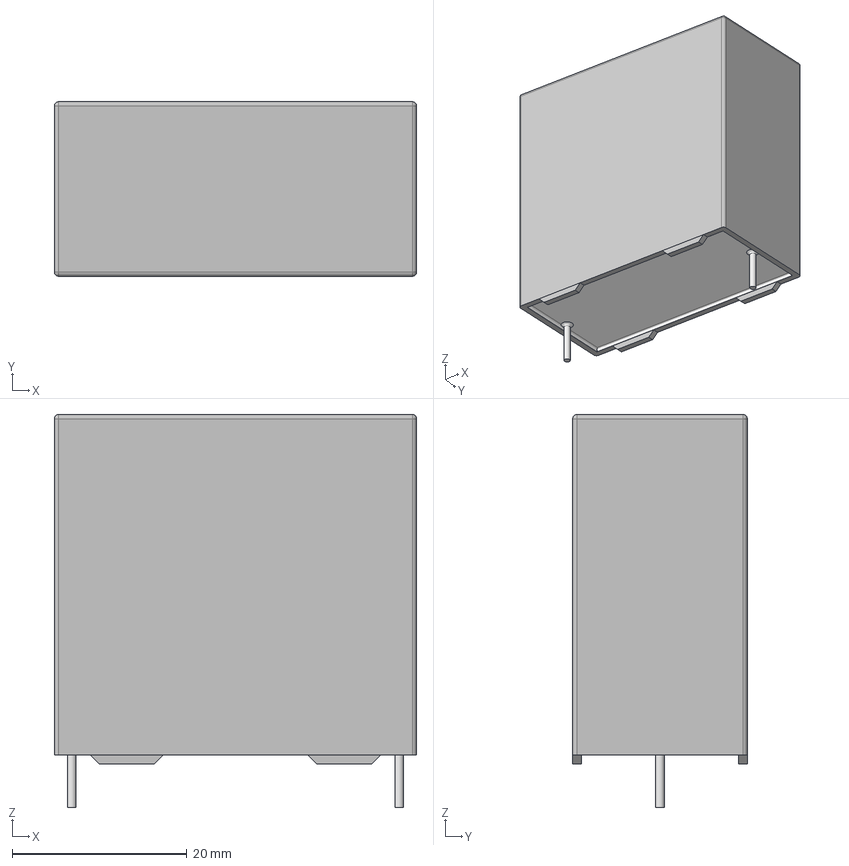
[picture p185: CAD file, 2025-10-22]
3D/Capacitor/Cap_SMD/CAP/Film Capacitor P37.5/FILM_GREY_P3750L4150W2000H4000PD100.stp
41.5 x 20.0 x 45.0 mm
