MinhThuanLe/RAI_Lab_Kicad_Library/3D/Capacitor/Cap_SMD/Tantalum/Tantalum SMD Capacitor .step

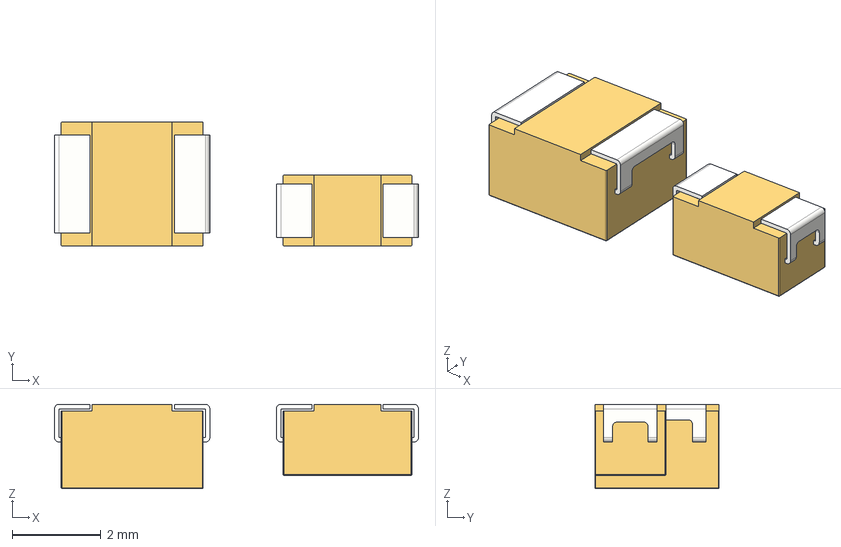
[picture p186: CAD file, 2025-10-22]
3D/Capacitor/Cap_SMD/Tantalum/Tantalum SMD Capacitor .step
8.20 x 2.80 x 1.90 mm
