MinhThuanLe/RAI_Lab_Kicad_Library/3D/Capacitor/Cap_THT/CAP/2200uF 63V electr -20x42mm -P.diameter 10mm.stp

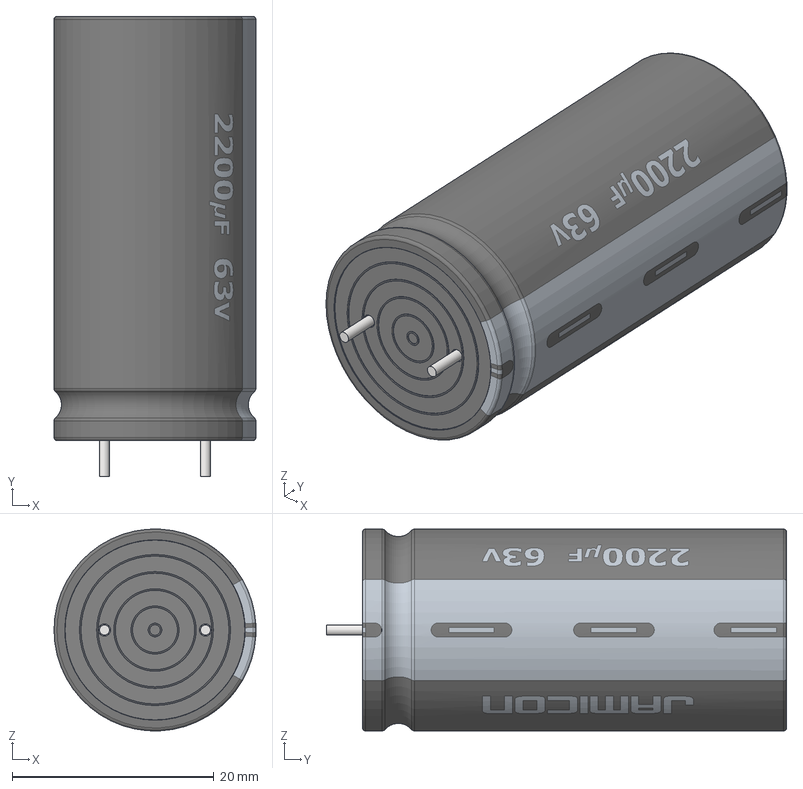
[picture p187: CAD file, 2025-10-22]
3D/Capacitor/Cap_THT/CAP/2200uF 63V electr -20x42mm -P.diameter 10mm.stp
20.0 x 45.6 x 20.0 mm
