MinhThuanLe/RAI_Lab_Kicad_Library/3D/Capacitor/Cap_THT/Film Capacitor P15/FILM_GREY_P1500L1800W1100H1900PD80.stp

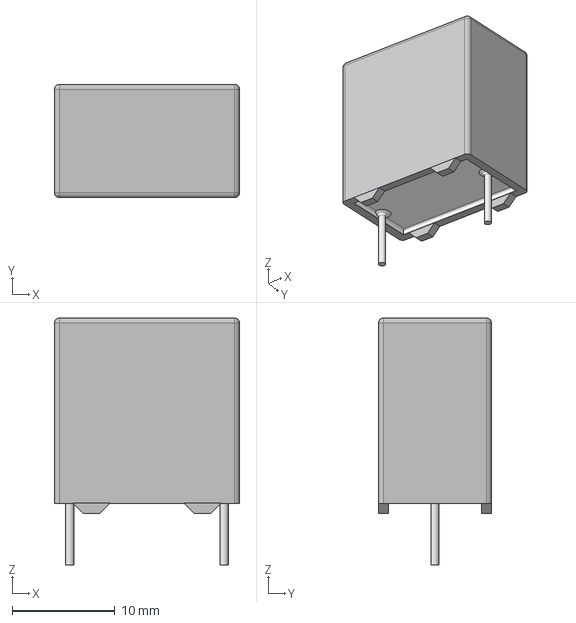
[picture p188: CAD file, 2025-10-22]
3D/Capacitor/Cap_THT/Film Capacitor P15/FILM_GREY_P1500L1800W1100H1900PD80.stp
18.0 x 11.0 x 24.0 mm
