MinhThuanLe/RAI_Lab_Kicad_Library/3D/Capacitor/Cap_THT/FilmCap/Film Capacitor P27.5/FILM_BLUE_P2750L3200W2200H3700PD90.stp

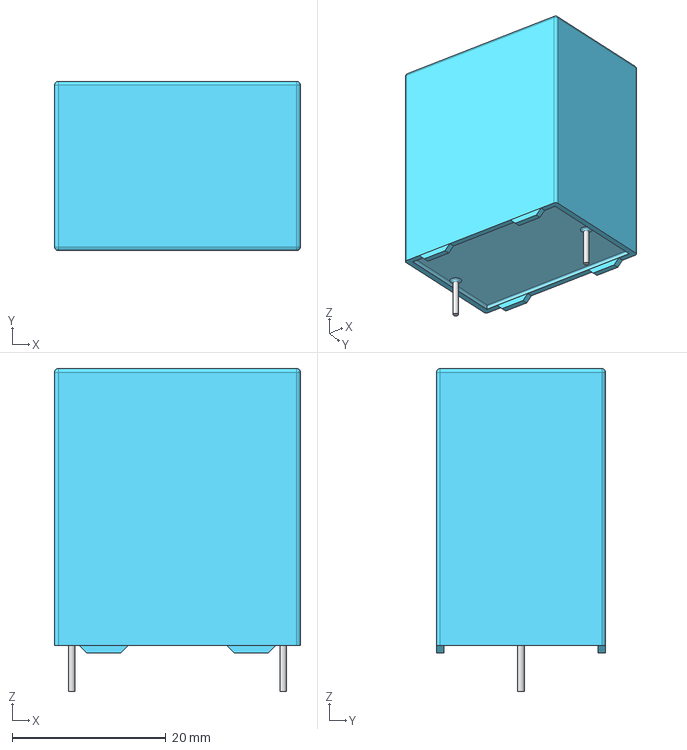
[picture p190: CAD file, 2025-10-22]
3D/Capacitor/Cap_THT/FilmCap/Film Capacitor P27.5/FILM_BLUE_P2750L3200W2200H3700PD90.stp
32.0 x 22.0 x 42.0 mm
