MinhThuanLe/RAI_Lab_Kicad_Library/3D/Capacitor/Cap_THT/MKT/MKT Capacitor Yellow (Double Width).step

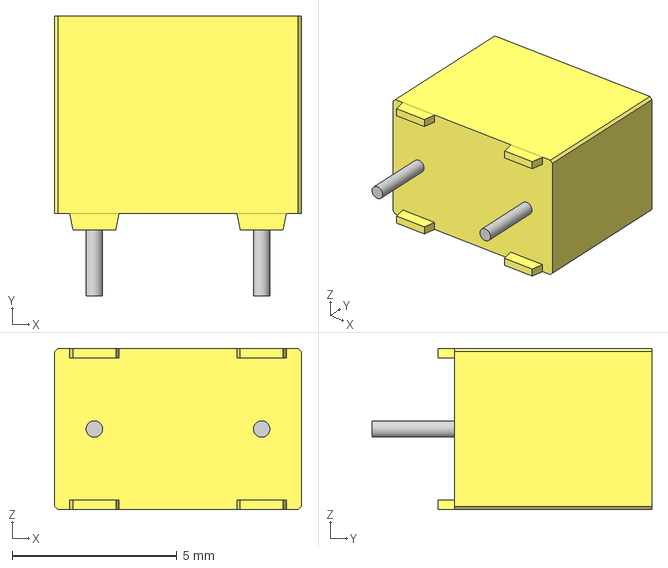
[picture p192: CAD file, 2025-10-22]
3D/Capacitor/Cap_THT/MKT/MKT Capacitor Yellow (Double Width).step
7.50 x 8.50 x 4.90 mm
