MinhThuanLe/RAI_Lab_Kicad_Library/3D/Comunication/TD301D485/User Library-TDx01D485.step

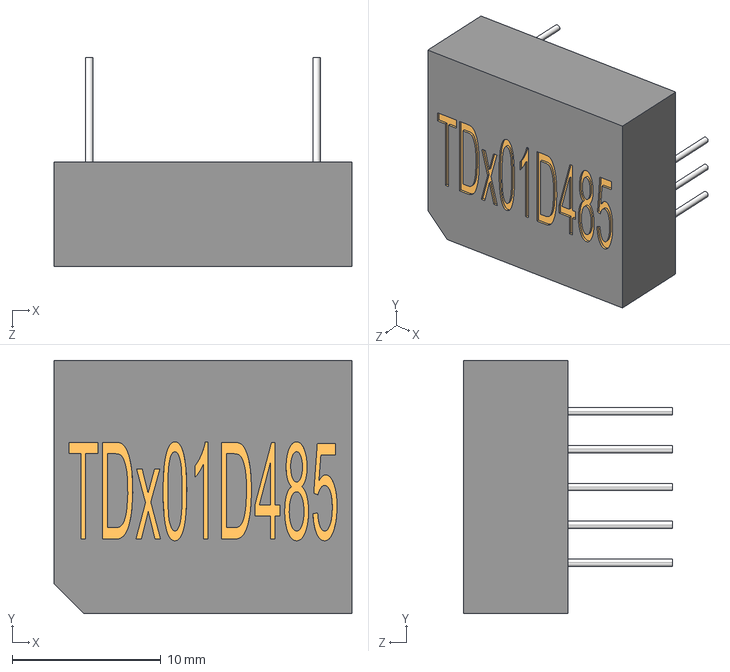
[picture p193: CAD file, 2025-10-22]
3D/Comunication/TD301D485/User Library-TDx01D485.step
20.0 x 17.0 x 14.0 mm
