MinhThuanLe/RAI_Lab_Kicad_Library/3D/Connector/Barrel Jack SMD/BarrelJackSMD v3.step

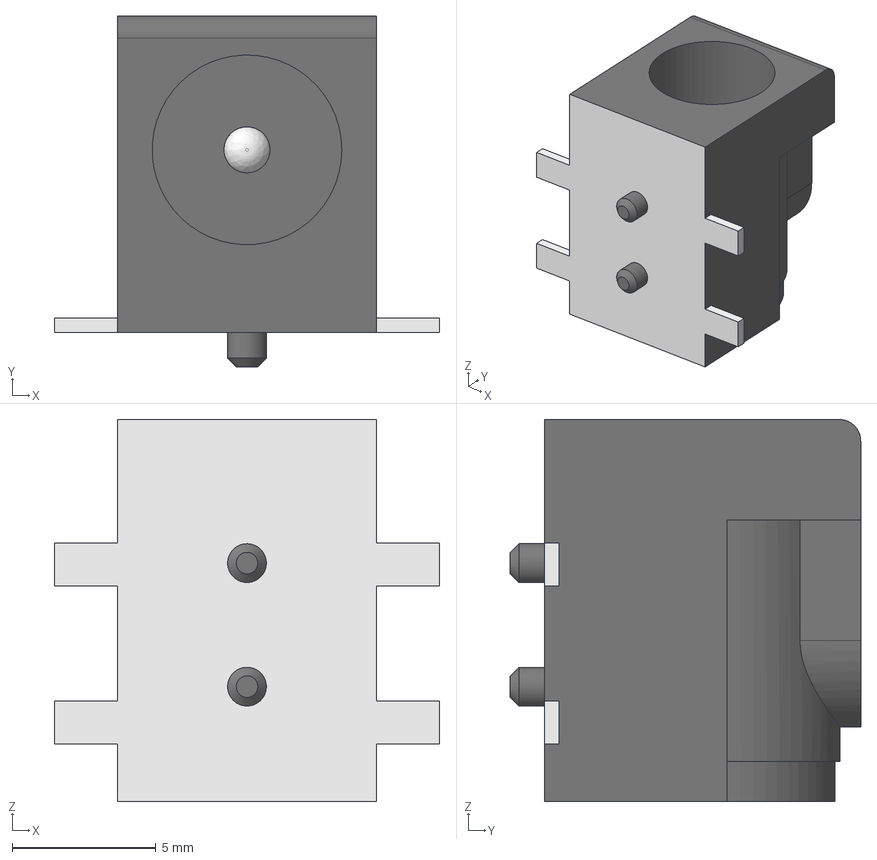
[picture p195: CAD file, 2025-10-22]
3D/Connector/Barrel Jack SMD/BarrelJackSMD v3.step
13.4 x 12.2 x 13.3 mm
