MinhThuanLe/RAI_Lab_Kicad_Library/3D/Connector/DB/Db15 male PCB Connector.STEP

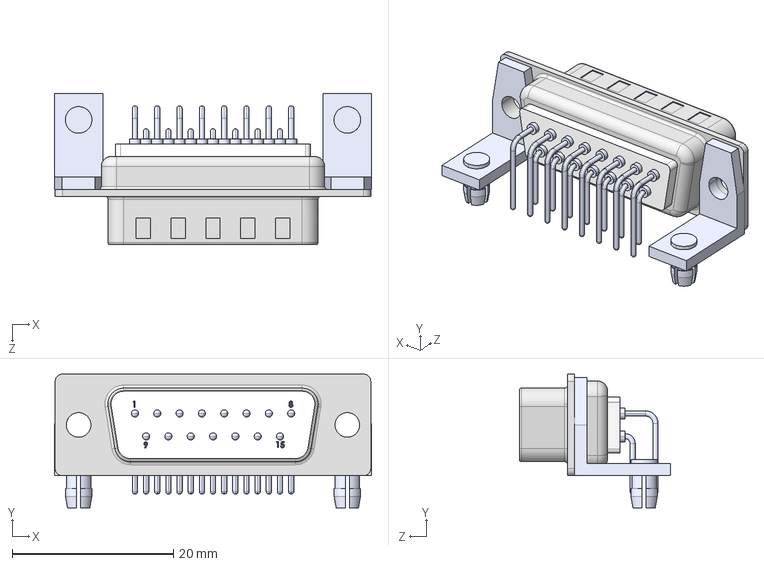
[picture p196: CAD file, 2025-10-22]
3D/Connector/DB/Db15 male PCB Connector.STEP
39.3 x 16.6 x 18.8 mm
