MinhThuanLe/RAI_Lab_Kicad_Library/3D/Connector/DB/VGA_DB15_PCB_RightAngle/VGA connector on plate (short).STEP

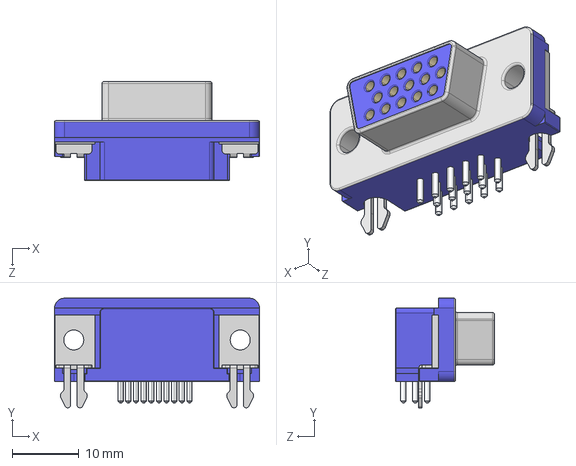
[picture p197: CAD file, 2025-10-22]
3D/Connector/DB/VGA_DB15_PCB_RightAngle/VGA connector on plate (short).STEP
30.8 x 16.5 x 14.9 mm
