MinhThuanLe/RAI_Lab_Kicad_Library/3D/Connector/FPC/FFC3B05-20-T.stp

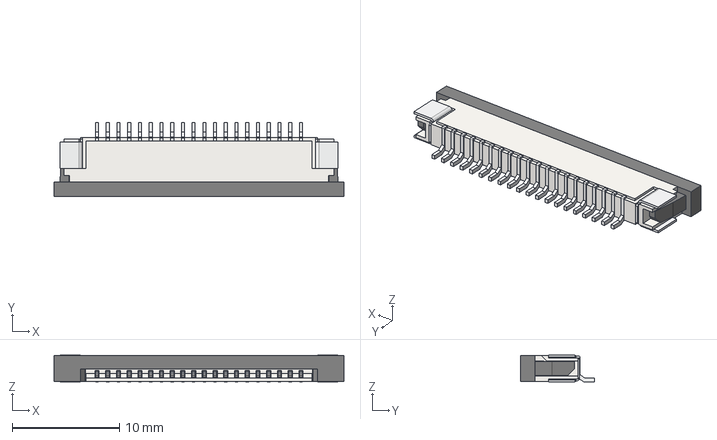
[picture p198: CAD file, 2025-10-22]
3D/Connector/FPC/FFC3B05-20-T.stp
27.0 x 6.90 x 2.50 mm
