MinhThuanLe/RAI_Lab_Kicad_Library/3D/Connector/GroveConnector/Grove Connector (flat).STEP

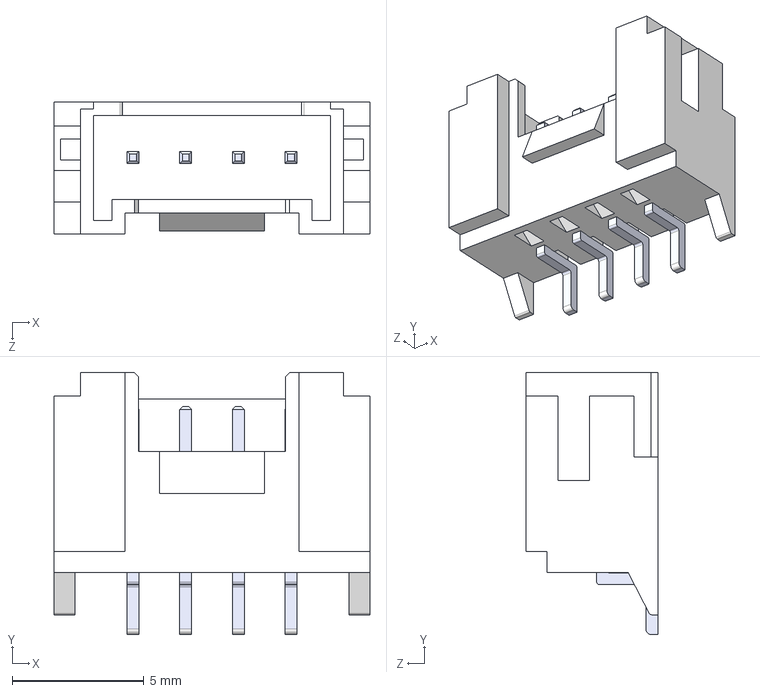
[picture p199: CAD file, 2025-10-22]
3D/Connector/GroveConnector/Grove Connector (flat).STEP
12.0 x 9.95 x 5.00 mm
