MinhThuanLe/RAI_Lab_Kicad_Library/3D/Connector/Header Male 2.0mm/2x2 2.0MM MALE SMD.STEP

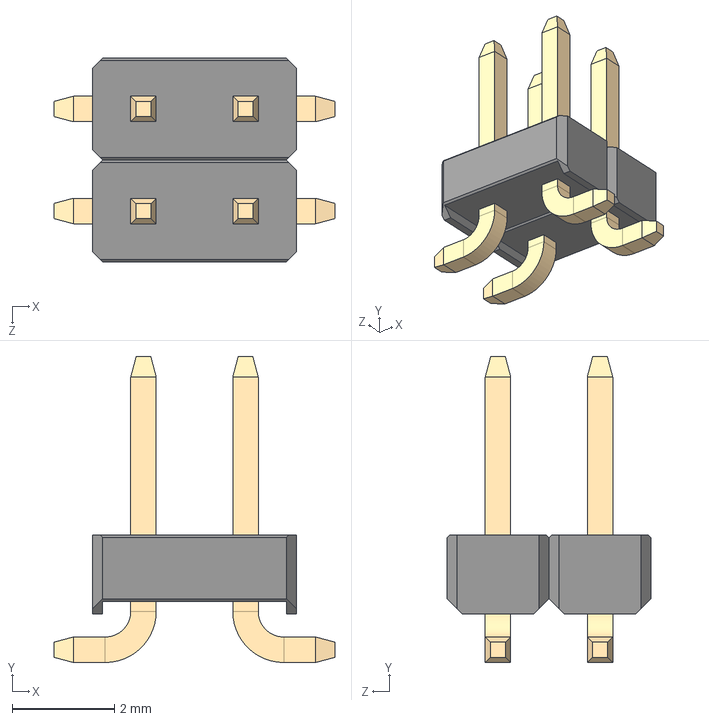
[picture p200: CAD file, 2025-10-22]
3D/Connector/Header Male 2.0mm/2x2 2.0MM MALE SMD.STEP
5.50 x 6.00 x 4.00 mm
