MinhThuanLe/RAI_Lab_Kicad_Library/3D/Connector/Header Male 2.0mm/TH/Pin Header 2x7 TH Pitch 2.54mm.stp

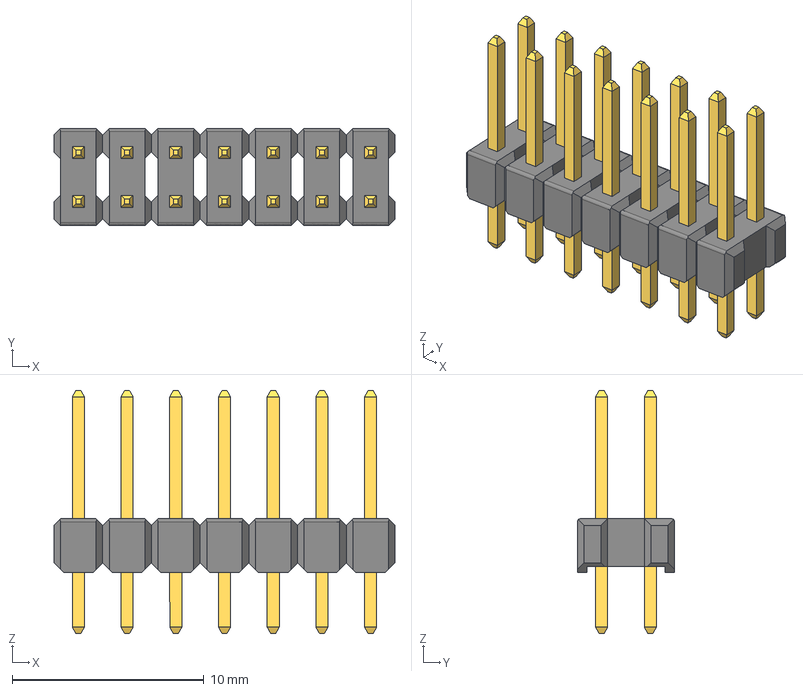
[picture p201: CAD file, 2025-10-22]
3D/Connector/Header Male 2.0mm/TH/Pin Header 2x7 TH Pitch 2.54mm.stp
17.8 x 5.08 x 12.7 mm
