MinhThuanLe/RAI_Lab_Kicad_Library/3D/Connector/Header/Header 2.54mm/Pinheader_Female_2.54/pin header female 2.54mm_0.1in.STEP

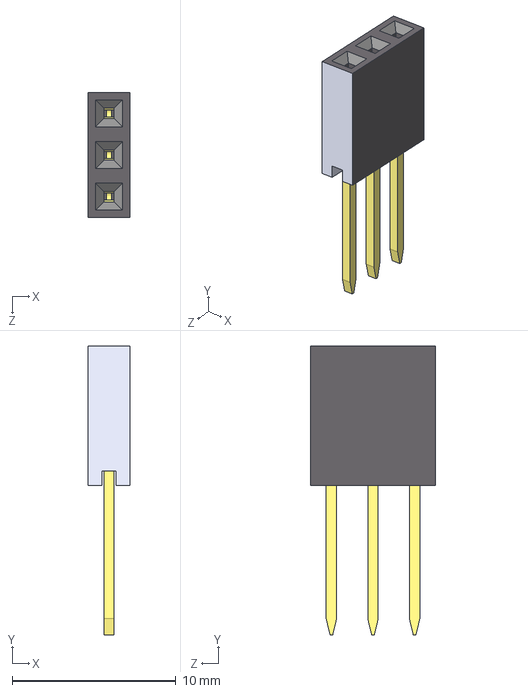
[picture p203: CAD file, 2025-10-22]
3D/Connector/Header/Header 2.54mm/Pinheader_Female_2.54/pin header female 2.54mm_0.1in.STEP
2.54 x 17.6 x 7.62 mm
