MinhThuanLe/RAI_Lab_Kicad_Library/3D/Connector/Header_1-27mm_2Row_SMD/1_27mm_Header/1_27mm_plastic_for_pin.SLDPRT

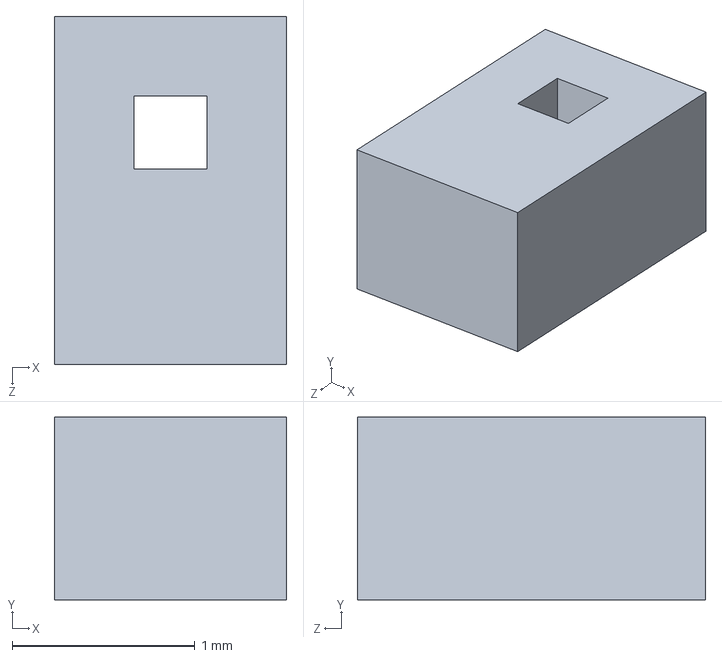
[picture p204: CAD file, 2025-10-22]
3D/Connector/Header_1-27mm_2Row_SMD/1_27mm_Header/1_27mm_plastic_for_pin.SLDPRT
1.27 x 1.00 x 1.90 mm
