MinhThuanLe/RAI_Lab_Kicad_Library/3D/Connector/HT-3.96/HT396 3.96 Connector Green v1.step

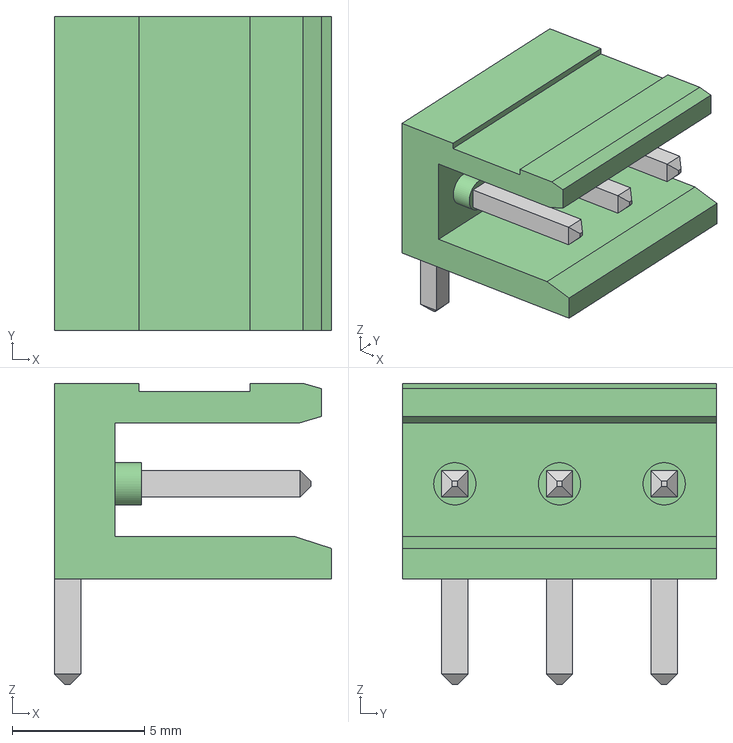
[picture p205: CAD file, 2025-10-22]
3D/Connector/HT-3.96/HT396 3.96 Connector Green v1.step
10.5 x 11.9 x 11.4 mm
