MinhThuanLe/RAI_Lab_Kicad_Library/3D/Connector/IDC/bh-connector-set-1.snapshot.1/BH-14.STEP

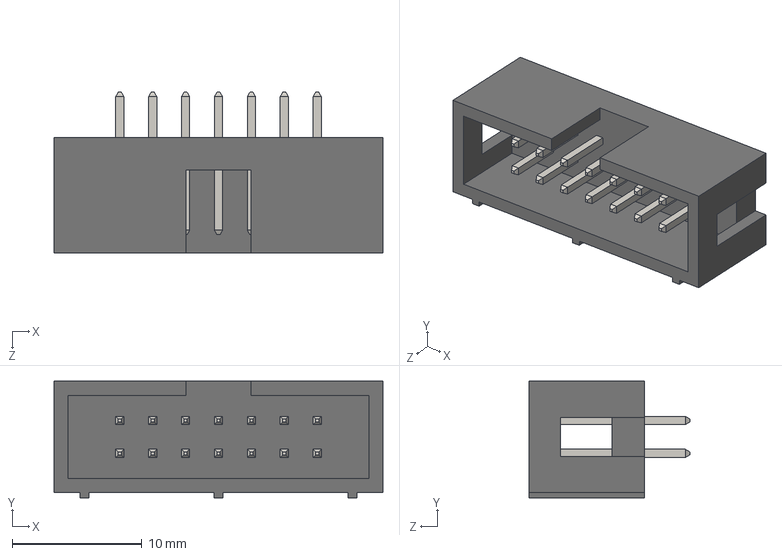
[picture p206: CAD file, 2025-10-22]
3D/Connector/IDC/bh-connector-set-1.snapshot.1/BH-14.STEP
25.4 x 9.00 x 12.4 mm
