MinhThuanLe/RAI_Lab_Kicad_Library/3D/Connector/IDC/IDC Connector 2.54mm/DS1013 (IDC CONNFLY)/DS1013-14S (IDC-14MS CONNFLY).stp

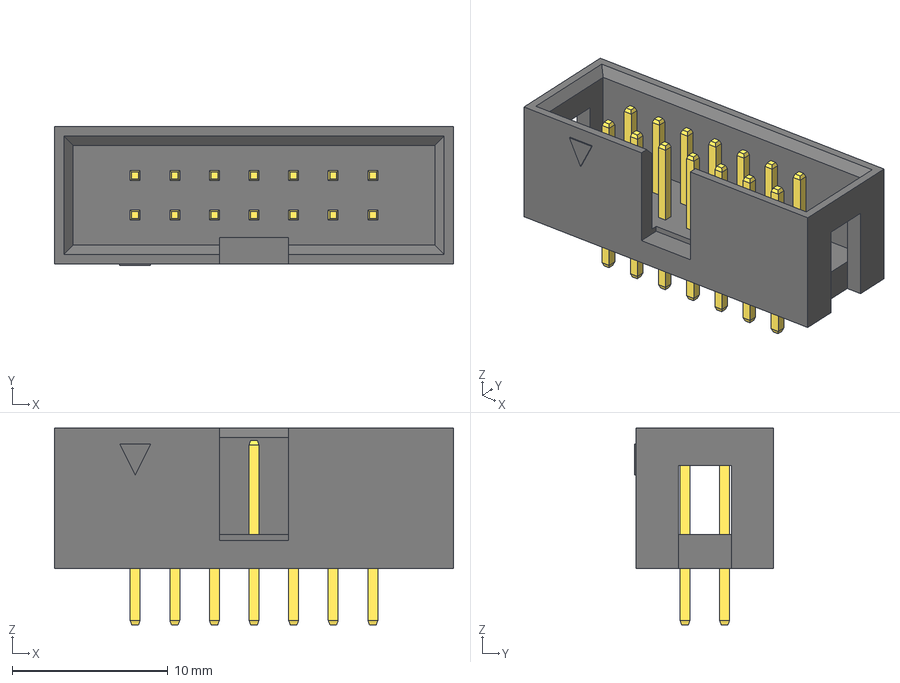
[picture p207: CAD file, 2025-10-22]
3D/Connector/IDC/IDC Connector 2.54mm/DS1013 (IDC CONNFLY)/DS1013-14S (IDC-14MS CONNFLY).stp
25.6 x 8.90 x 12.6 mm
