MinhThuanLe/RAI_Lab_Kicad_Library/3D/Connector/IPEX_Antenna/i-pex-mhf-micro-coax-45-ghz-rf-receptacle-1.snapshot.1/I-PEX MHF_7 Recepticle.STEP

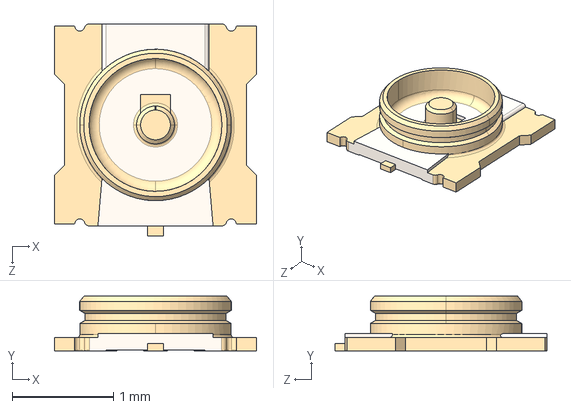
[picture p208: CAD file, 2025-10-22]
3D/Connector/IPEX_Antenna/i-pex-mhf-micro-coax-45-ghz-rf-receptacle-1.snapshot.1/I-PEX MHF_7 Recepticle.STEP
2.00 x 0.54 x 2.10 mm
