MinhThuanLe/RAI_Lab_Kicad_Library/3D/Connector/IPEX_Antenna/SMA-angled.STEP

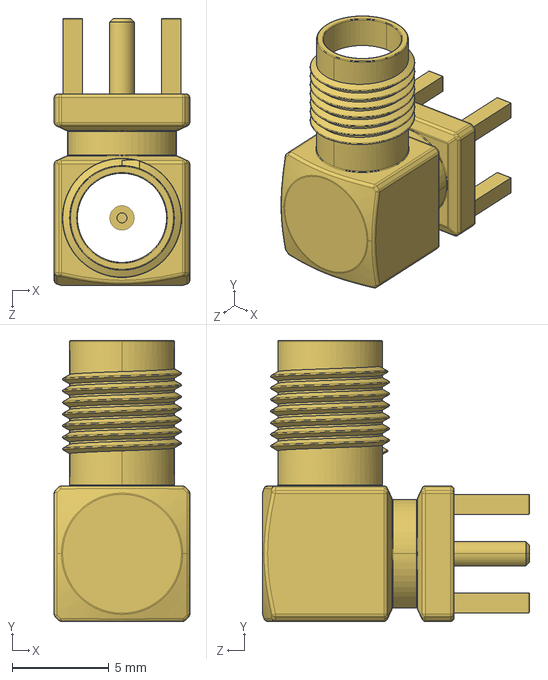
[picture p210: CAD file, 2025-10-22]
3D/Connector/IPEX_Antenna/SMA-angled.STEP
7.00 x 14.5 x 13.8 mm
