MinhThuanLe/RAI_Lab_Kicad_Library/3D/Connector/Jack_DC/DC Power Jack 5.5mm x 2.1mm.STEP

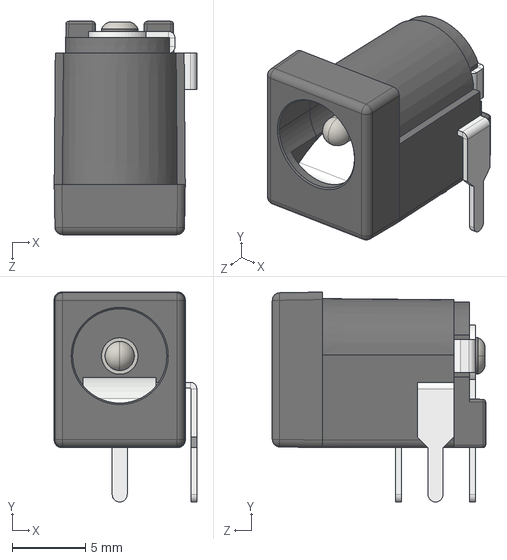
[picture p211: CAD file, 2025-10-22]
3D/Connector/Jack_DC/DC Power Jack 5.5mm x 2.1mm.STEP
9.77 x 14.4 x 14.6 mm
