MinhThuanLe/RAI_Lab_Kicad_Library/3D/Connector/JST/DIP/JST-CH-Thru-Vertical-3.96mm/JST - CH - Thru - Right- 3.96mm/JST - CH - Thru (R) - 11Pin - 3.96mm.stp

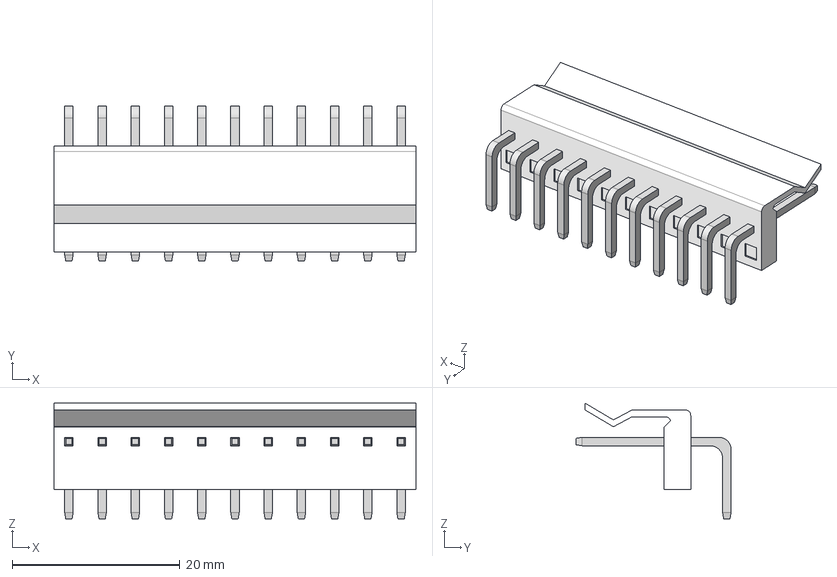
[picture p212: CAD file, 2025-10-22]
3D/Connector/JST/DIP/JST-CH-Thru-Vertical-3.96mm/JST - CH - Thru - Right- 3.96mm/JST - CH - Thru (R) - 11Pin - 3.96mm.stp
43.2 x 18.5 x 13.8 mm
