MinhThuanLe/RAI_Lab_Kicad_Library/3D/Connector/JST/DIP/JST-CH-Thru-Vertical-3.96mm/JST - CH - Thru - Vertical - 3.96mm/JST - CH - Thru (V) - 7Pin - 3.96mm.stp

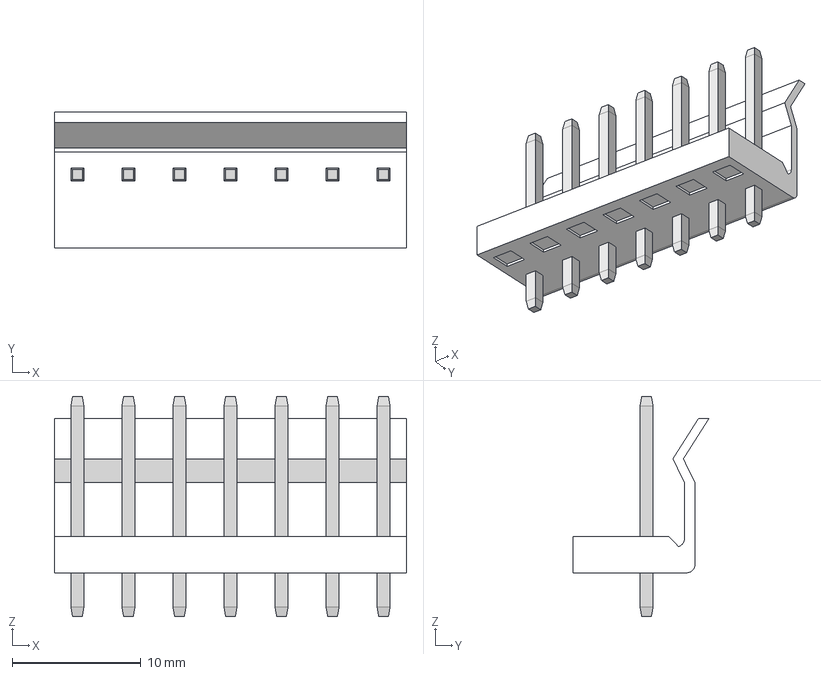
[picture p213: CAD file, 2025-10-22]
3D/Connector/JST/DIP/JST-CH-Thru-Vertical-3.96mm/JST - CH - Thru - Vertical - 3.96mm/JST - CH - Thru (V) - 7Pin - 3.96mm.stp
27.3 x 10.6 x 17.1 mm
