MinhThuanLe/RAI_Lab_Kicad_Library/3D/Connector/JST/DIP/JST-PH-Thru-Vertical-2.00mm/JST - PH - Thru (V) - 3Pin - 2.00mm.stp

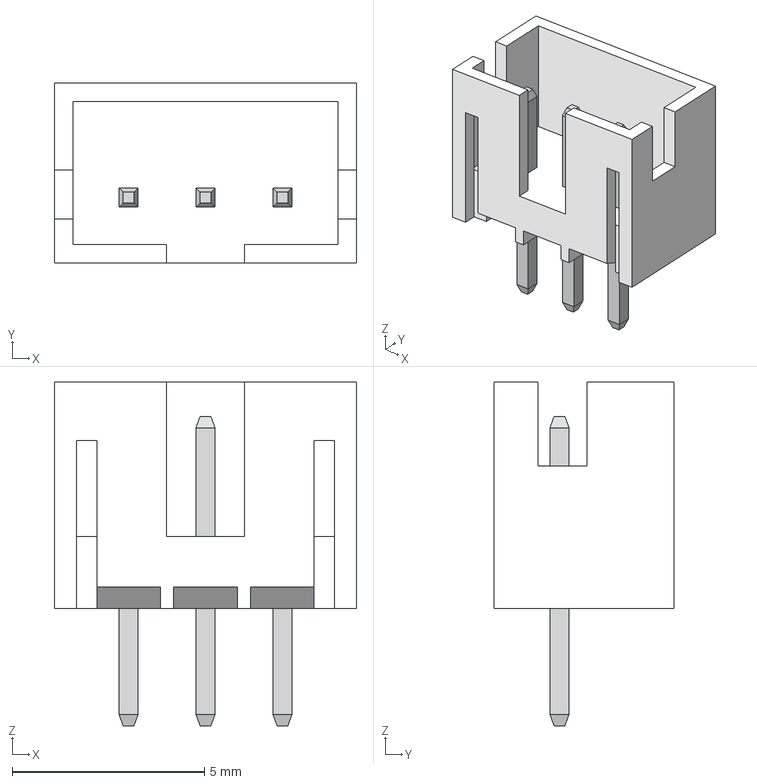
[picture p214: CAD file, 2025-10-22]
3D/Connector/JST/DIP/JST-PH-Thru-Vertical-2.00mm/JST - PH - Thru (V) - 3Pin - 2.00mm.stp
7.86 x 4.67 x 8.94 mm
