MinhThuanLe/RAI_Lab_Kicad_Library/3D/Connector/JST/DIP/JST-VH-Thru-Vertical-3.96mm/JST - VH - Thru (V) - 3Pin - 3.96mm.stp

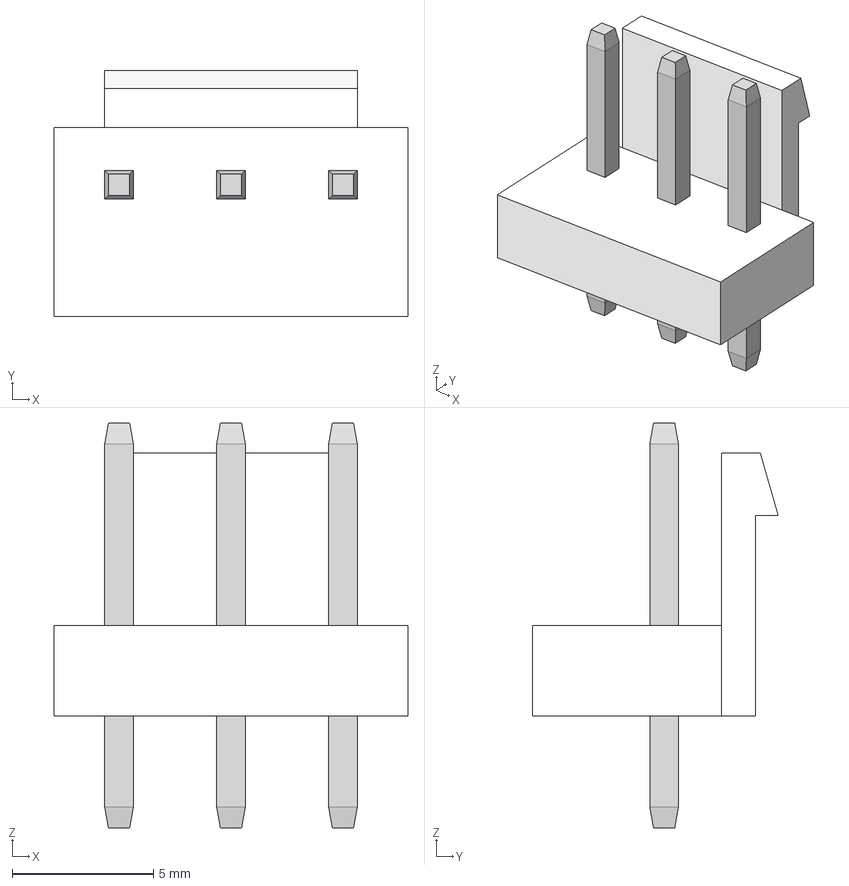
[picture p215: CAD file, 2025-10-22]
3D/Connector/JST/DIP/JST-VH-Thru-Vertical-3.96mm/JST - VH - Thru (V) - 3Pin - 3.96mm.stp
12.5 x 8.69 x 14.3 mm
