MinhThuanLe/RAI_Lab_Kicad_Library/3D/Connector/JST/DIP/JST-XH-Thru-Vertical-2.54mm-2P-8P/S4B-XH-SM4-TB.STEP

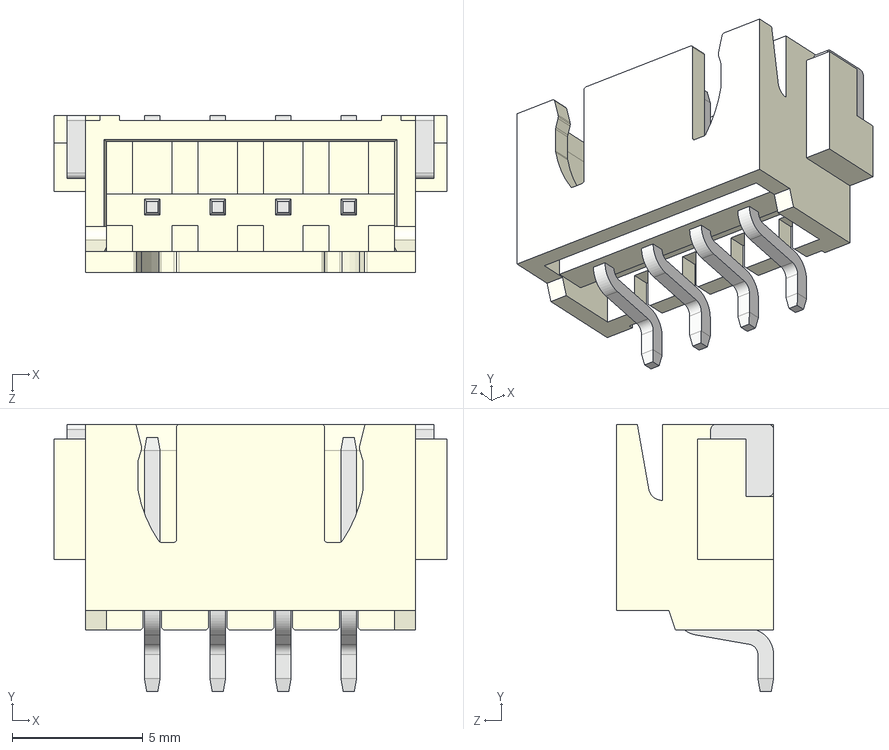
[picture p216: CAD file, 2025-10-22]
3D/Connector/JST/DIP/JST-XH-Thru-Vertical-2.54mm-2P-8P/S4B-XH-SM4-TB.STEP
15.0 x 10.2 x 6.00 mm
