MinhThuanLe/RAI_Lab_Kicad_Library/3D/Connector/JST/DIP/JST-XH-Thru-Vertical-2.54mm-4P/JST XH 4 B4B-XH-A.STEP

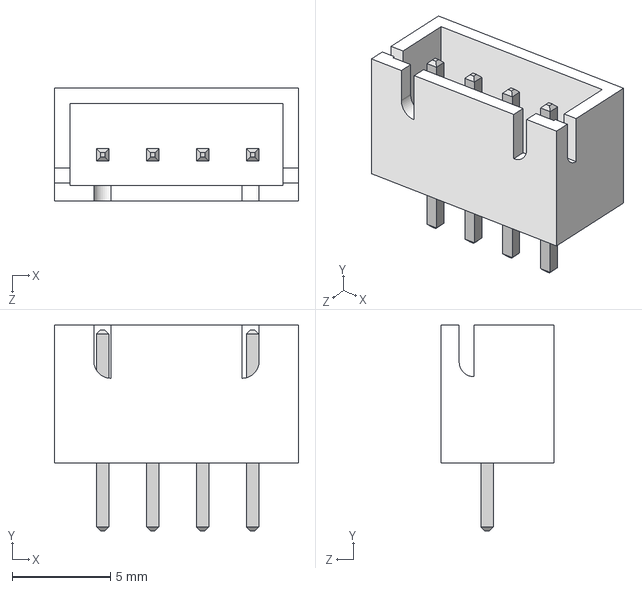
[picture p217: CAD file, 2025-10-22]
3D/Connector/JST/DIP/JST-XH-Thru-Vertical-2.54mm-4P/JST XH 4 B4B-XH-A.STEP
12.4 x 10.5 x 5.75 mm
