MinhThuanLe/RAI_Lab_Kicad_Library/3D/Connector/JST/DIP/JST-XH-Thru-Vertical-2.54mm-5P/JST 5pin.stp

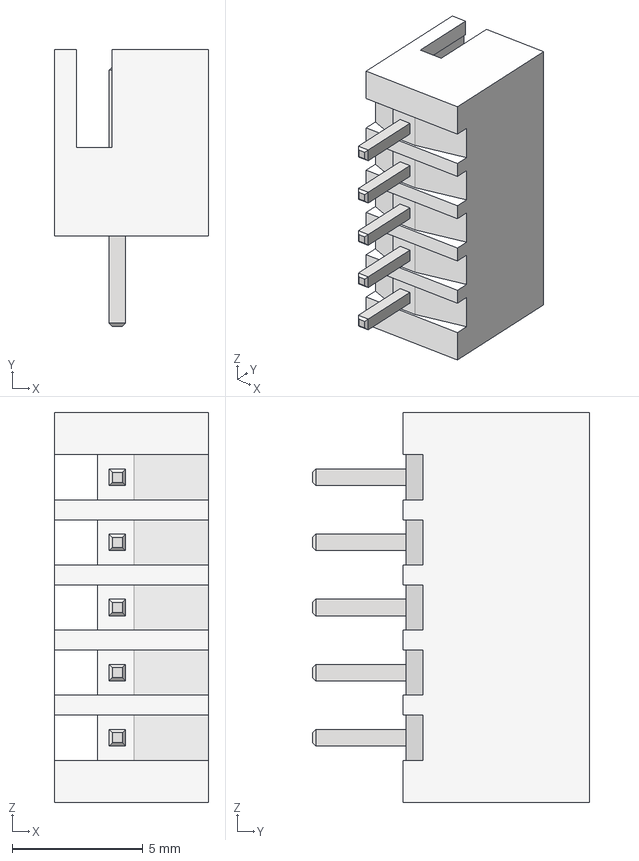
[picture p218: CAD file, 2025-10-22]
3D/Connector/JST/DIP/JST-XH-Thru-Vertical-2.54mm-5P/JST 5pin.stp
5.91 x 10.6 x 14.9 mm
