MinhThuanLe/RAI_Lab_Kicad_Library/3D/Connector/JST/SMD/JST-PH-SMD-Right-2.0mm/JST - PH - SMD (R) - 12Pin - 2.00mm.stp

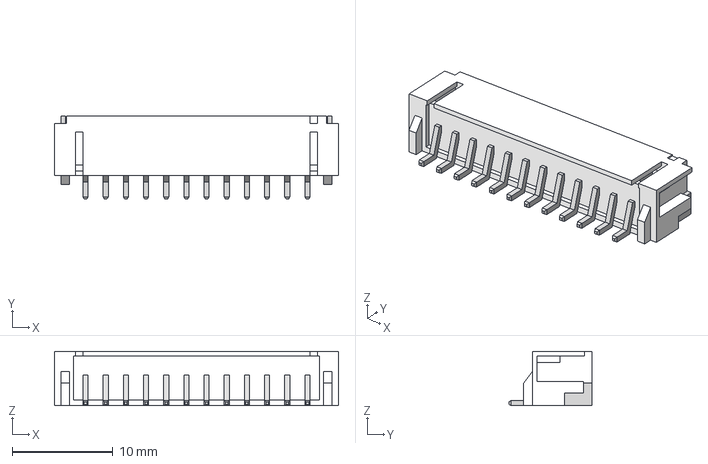
[picture p220: CAD file, 2025-10-22]
3D/Connector/JST/SMD/JST-PH-SMD-Right-2.0mm/JST - PH - SMD (R) - 12Pin - 2.00mm.stp
28.1 x 8.26 x 5.38 mm
