MinhThuanLe/RAI_Lab_Kicad_Library/3D/Connector/JST_Connector/JST_PH_2.0mm_DIP/JST - PH - SMD - Right - 1.25mm/JST - PH - SMD (R) - 11Pin - 2.00mm.stp

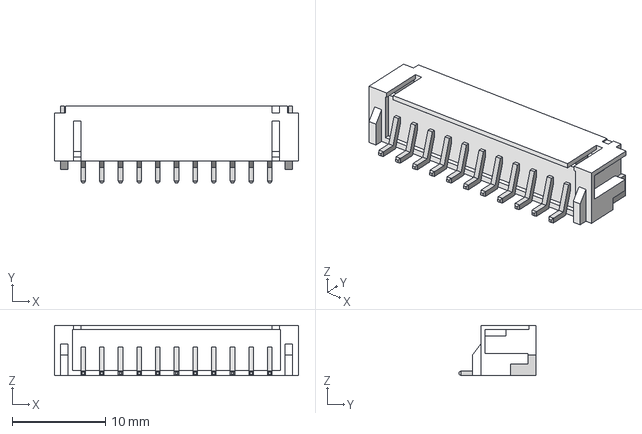
[picture p222: CAD file, 2025-10-22]
3D/Connector/JST_Connector/JST_PH_2.0mm_DIP/JST - PH - SMD - Right - 1.25mm/JST - PH - SMD (R) - 11Pin - 2.00mm.stp
26.1 x 8.26 x 5.38 mm
