MinhThuanLe/RAI_Lab_Kicad_Library/3D/Connector/JST_Connector/JST_PH_2.0mm_DIP/JST - PH - Thru - Vertical - 2.00mm/JST - PH - Thru (V) - 2Pin - 2.00mm.stp

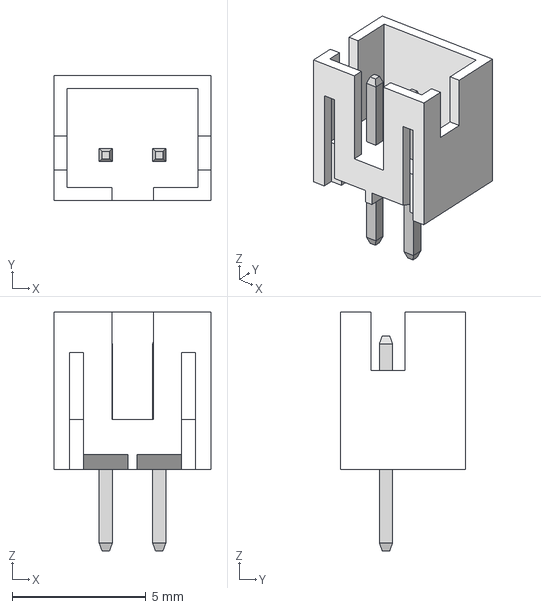
[picture p223: CAD file, 2025-10-22]
3D/Connector/JST_Connector/JST_PH_2.0mm_DIP/JST - PH - Thru - Vertical - 2.00mm/JST - PH - Thru (V) - 2Pin - 2.00mm.stp
5.86 x 4.67 x 8.94 mm
