MinhThuanLe/RAI_Lab_Kicad_Library/3D/Connector/JST_Connector/JST_XH_2.54mm/S5B-XH-SM4-TB.STEP

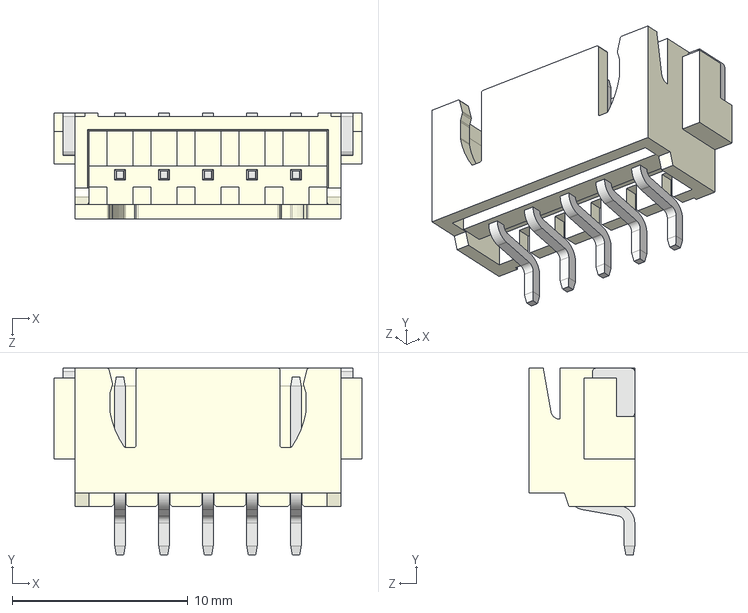
[picture p224: CAD file, 2025-10-22]
3D/Connector/JST_Connector/JST_XH_2.54mm/S5B-XH-SM4-TB.STEP
17.5 x 10.6 x 6.00 mm
