MinhThuanLe/RAI_Lab_Kicad_Library/3D/Connector/KF-5.08/2P.STEP

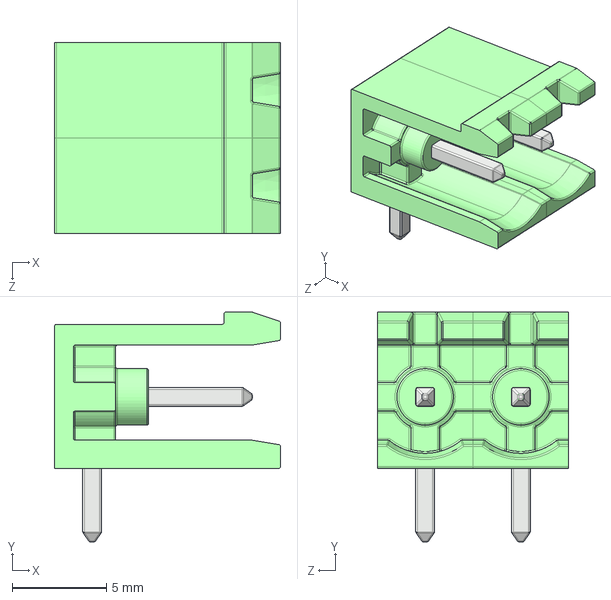
[picture p225: CAD file, 2025-10-22]
3D/Connector/KF-5.08/2P.STEP
12.0 x 12.2 x 10.2 mm
