MinhThuanLe/RAI_Lab_Kicad_Library/3D/Connector/KF128/TER-KF128-2P.step

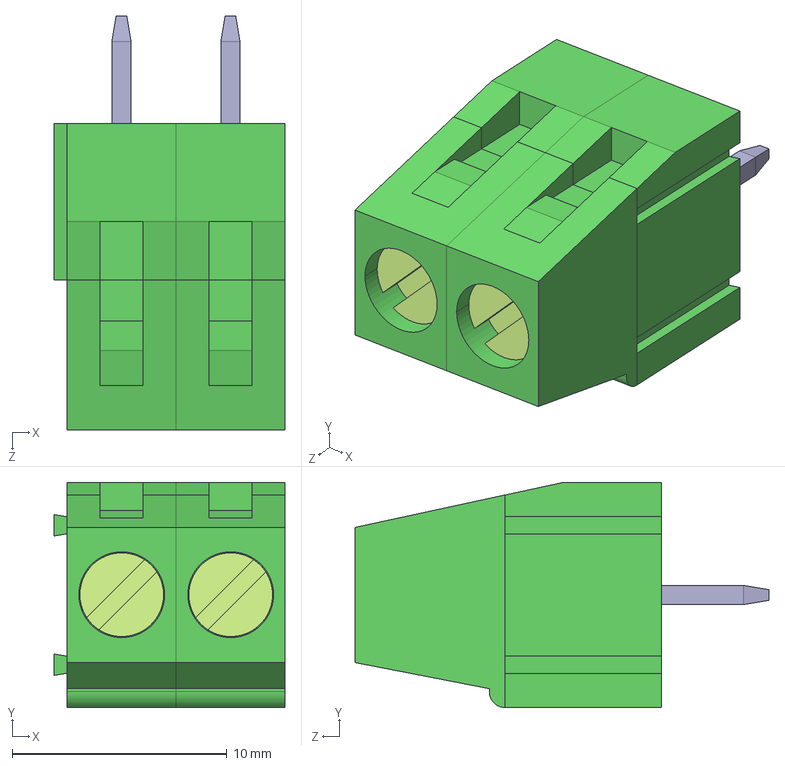
[picture p226: CAD file, 2025-10-22]
3D/Connector/KF128/TER-KF128-2P.step
10.8 x 10.5 x 19.3 mm
