MinhThuanLe/RAI_Lab_Kicad_Library/3D/Connector/KF2510/molex-2.54-3pin.STEP

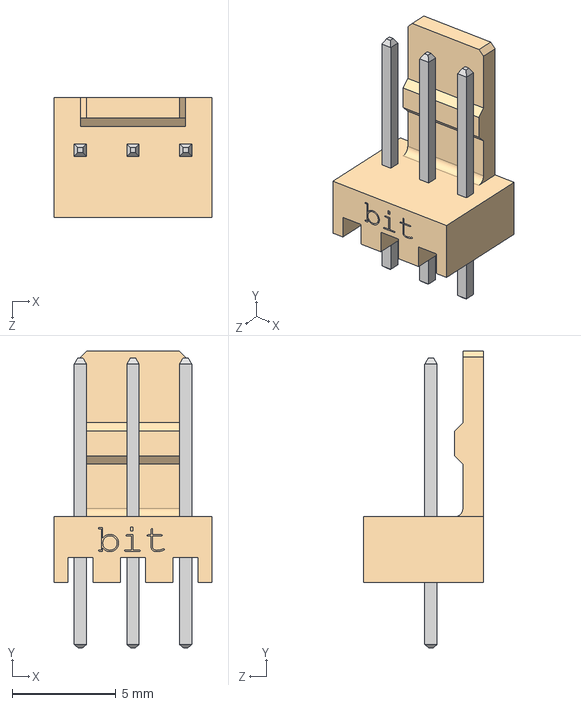
[picture p227: CAD file, 2025-10-22]
3D/Connector/KF2510/molex-2.54-3pin.STEP
7.62 x 14.3 x 5.80 mm
Pieza3
pin x 3
