MinhThuanLe/RAI_Lab_Kicad_Library/3D/Connector/KF2EDG/3P.STEP

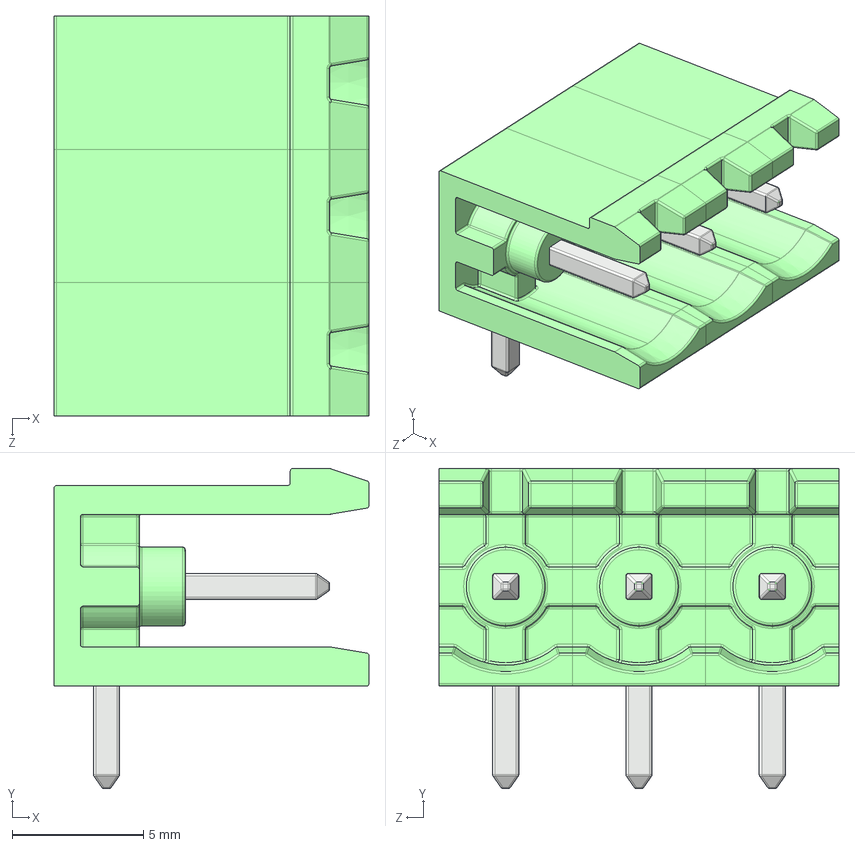
[picture p228: CAD file, 2025-10-22]
3D/Connector/KF2EDG/3P.STEP
12.0 x 12.2 x 15.2 mm
