MinhThuanLe/RAI_Lab_Kicad_Library/3D/Connector/KF2EDG/KF-5.08/1P.DXF

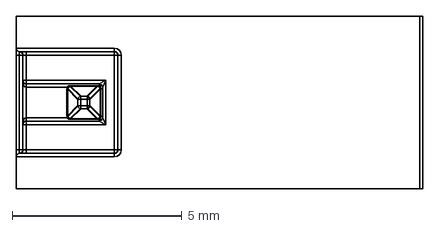
[picture p229: CAD file, 2025-10-22]
3D/Connector/KF2EDG/KF-5.08/1P.DXF
12.0 x 5.08 mm
