MinhThuanLe/RAI_Lab_Kicad_Library/3D/Connector/pin-headers-dual-rows-1.snapshot.2/Pin Header 2x10 TH Pitch 2.54mm.stp

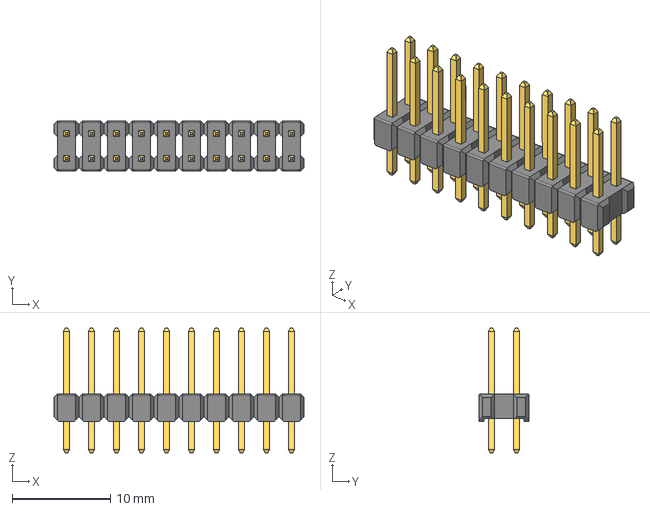
[picture p231: CAD file, 2025-10-22]
3D/Connector/pin-headers-dual-rows-1.snapshot.2/Pin Header 2x10 TH Pitch 2.54mm.stp
25.4 x 5.08 x 12.7 mm
