MinhThuanLe/RAI_Lab_Kicad_Library/3D/Connector/QHPPC-2.5mm_Magsafe Connector Pair/QHPPC-2.5mm_Magsafe Connector Pair.STEP

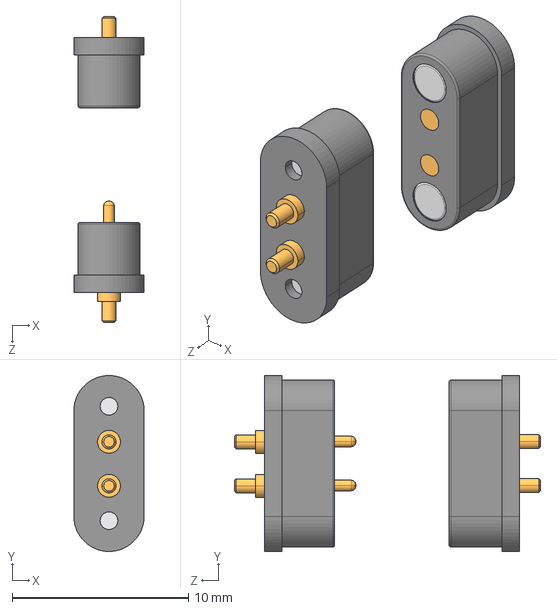
[picture p232: CAD file, 2025-10-22]
3D/Connector/QHPPC-2.5mm_Magsafe Connector Pair/QHPPC-2.5mm_Magsafe Connector Pair.STEP
4.00 x 10.0 x 17.4 mm
