MinhThuanLe/RAI_Lab_Kicad_Library/3D/Connector/RJ11/TJ6P4C/TJ6P4C.stp

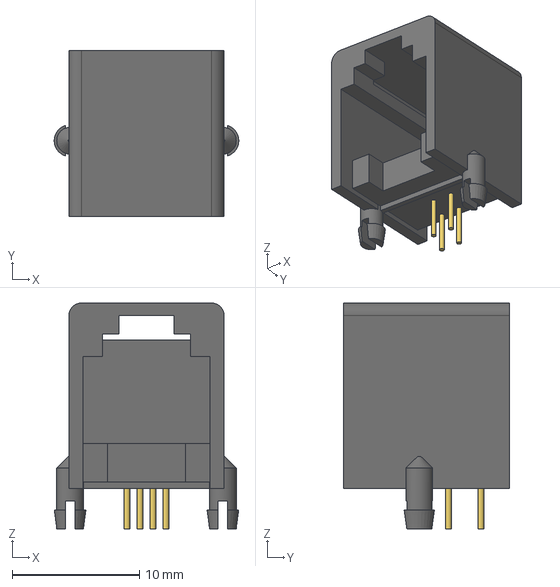
[picture p233: CAD file, 2025-10-22]
3D/Connector/RJ11/TJ6P4C/TJ6P4C.stp
14.5 x 13.0 x 17.8 mm
