MinhThuanLe/RAI_Lab_Kicad_Library/3D/Connector/RJ45/User Library-HR911105A.STEP

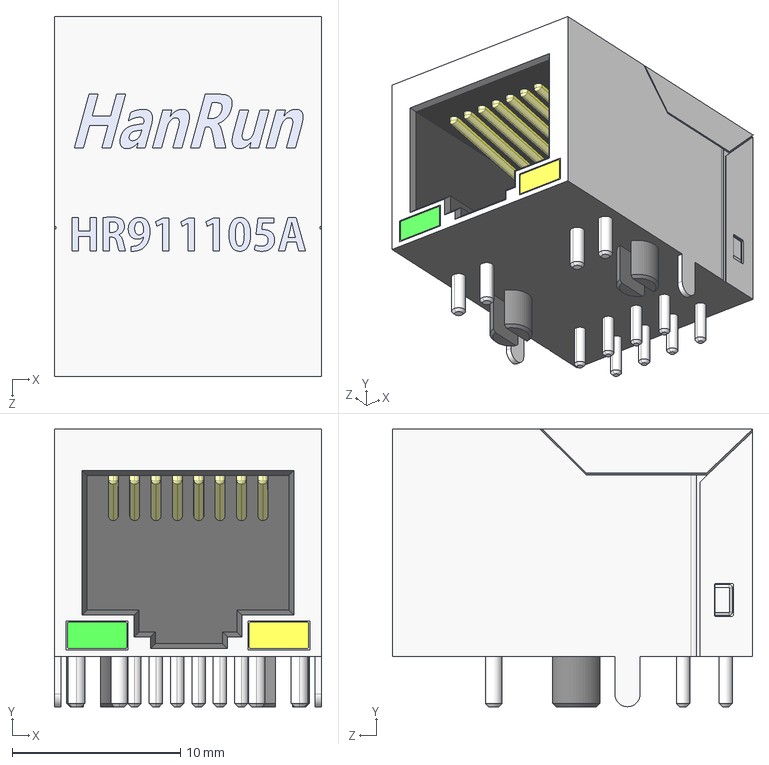
[picture p234: CAD file, 2025-10-22]
3D/Connector/RJ45/User Library-HR911105A.STEP
15.9 x 16.5 x 21.4 mm
