MinhThuanLe/RAI_Lab_Kicad_Library/3D/Connector/S2B-ZR-SM4A-TF.step

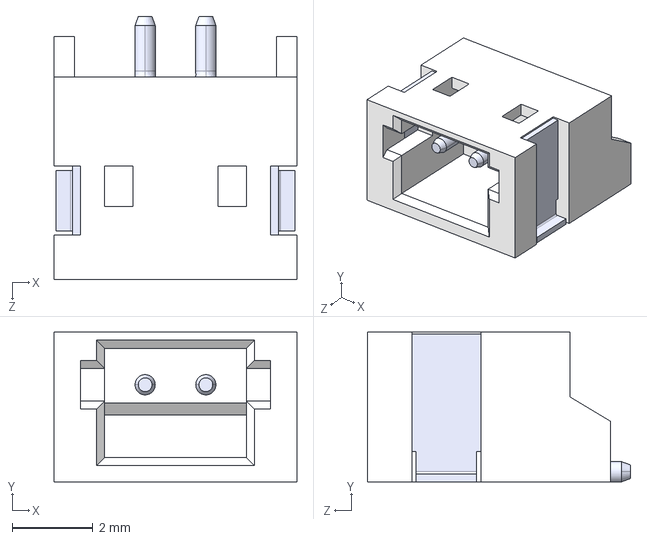
[picture p235: CAD file, 2025-10-22]
3D/Connector/S2B-ZR-SM4A-TF.step
6.00 x 3.70 x 6.50 mm
