MinhThuanLe/RAI_Lab_Kicad_Library/3D/Connector/ShuntJumpter/Jumper Closed.stp

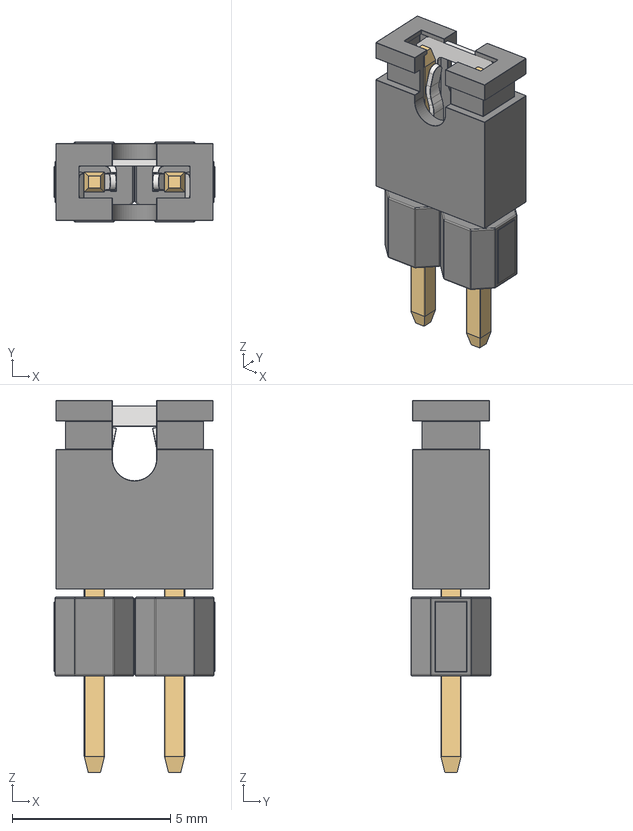
[picture p236: CAD file, 2025-10-22]
3D/Connector/ShuntJumpter/Jumper Closed.stp
5.08 x 2.54 x 11.8 mm
