MinhThuanLe/RAI_Lab_Kicad_Library/3D/Connector/Sim_card_holder/ATTEND_115A-ADA0-R02.STEP

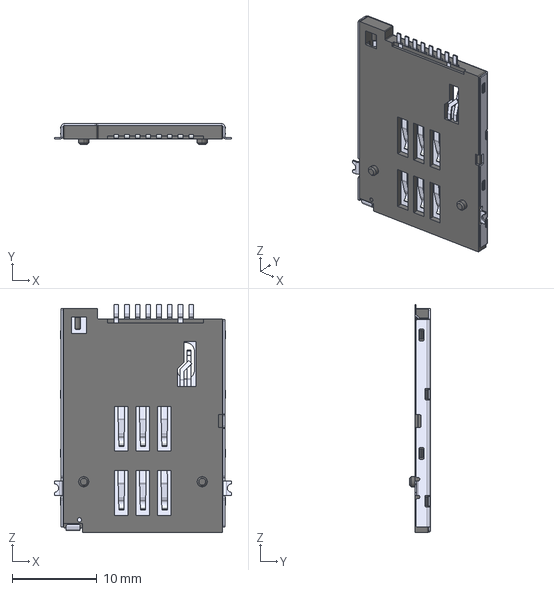
[picture p237: CAD file, 2025-10-22]
3D/Connector/Sim_card_holder/ATTEND_115A-ADA0-R02.STEP
20.9 x 2.54 x 26.9 mm
