MinhThuanLe/RAI_Lab_Kicad_Library/3D/Connector/SIMCardHolder/NanoSIM/SIM8060/User Library-SIM8060.STEP

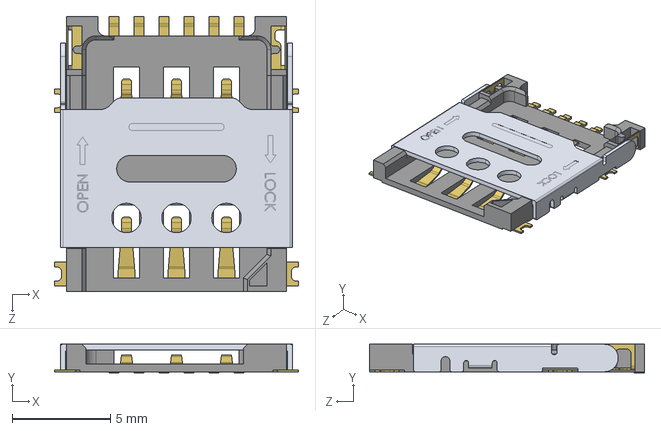
[picture p238: CAD file, 2025-10-22]
3D/Connector/SIMCardHolder/NanoSIM/SIM8060/User Library-SIM8060.STEP
12.4 x 1.45 x 14.0 mm
