MinhThuanLe/RAI_Lab_Kicad_Library/3D/Connector/SIMCardHolder/NanoSIM/User Library-NANO SIM-1/User Library-NANO SIM-1.STEP

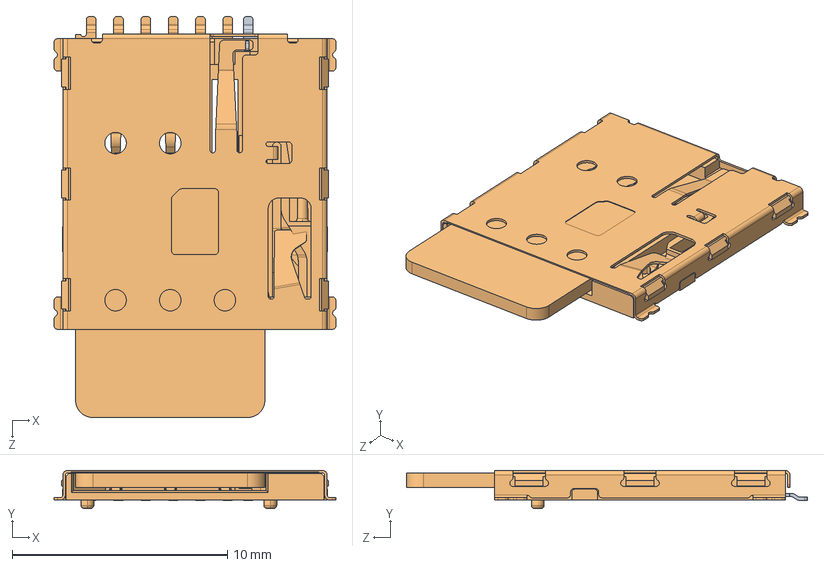
[picture p239: CAD file, 2025-10-22]
3D/Connector/SIMCardHolder/NanoSIM/User Library-NANO SIM-1/User Library-NANO SIM-1.STEP
13.1 x 1.77 x 18.6 mm
