MinhThuanLe/RAI_Lab_Kicad_Library/3D/Connector/terminal-block-connector-1.snapshot.7/TE_1776244-2.STEP

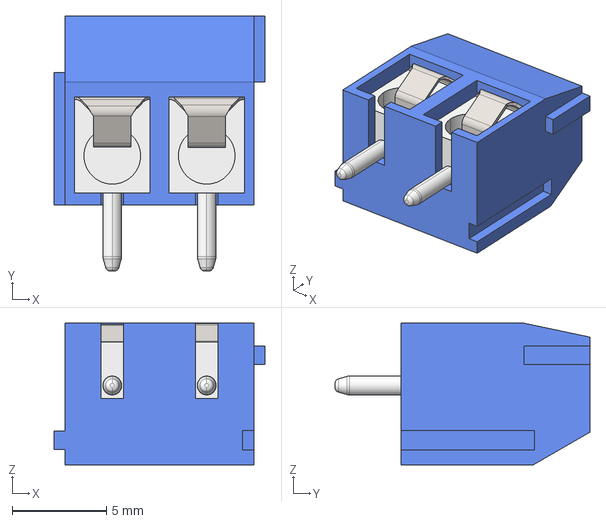
[picture p240: CAD file, 2025-10-22]
3D/Connector/terminal-block-connector-1.snapshot.7/TE_1776244-2.STEP
11.2 x 13.5 x 7.50 mm
