MinhThuanLe/RAI_Lab_Kicad_Library/3D/Connector/TerminalBlock/borne-5-08mm-duplo-nivel-1.snapshot.2/borne br12 deslocado à direita.STEP

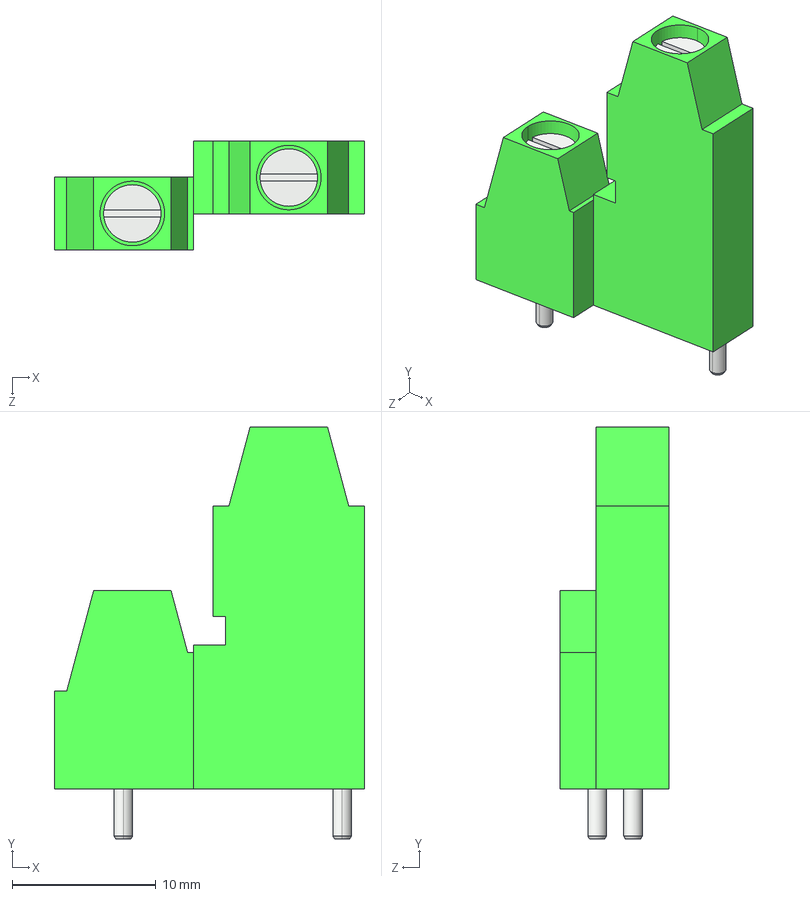
[picture p241: CAD file, 2025-10-22]
3D/Connector/TerminalBlock/borne-5-08mm-duplo-nivel-1.snapshot.2/borne br12 deslocado à direita.STEP
21.6 x 28.7 x 7.58 mm
