MinhThuanLe/RAI_Lab_Kicad_Library/3D/Connector/TerminalBlock/TE 1776244/3P Blue/Terminal_3pin.STEP

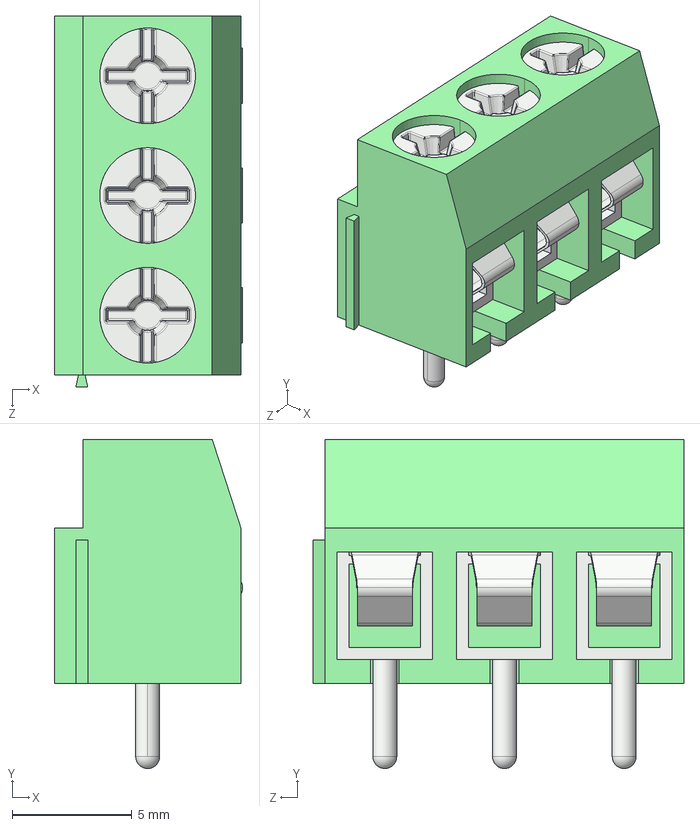
[picture p243: CAD file, 2025-10-22]
3D/Connector/TerminalBlock/TE 1776244/3P Blue/Terminal_3pin.STEP
7.87 x 13.8 x 15.5 mm
Outter
Screw x 3
Inner x 3
