MinhThuanLe/RAI_Lab_Kicad_Library/3D/Connector/TerminalBlock/WURTH_691216510002/WURTH_691216510002.STEP

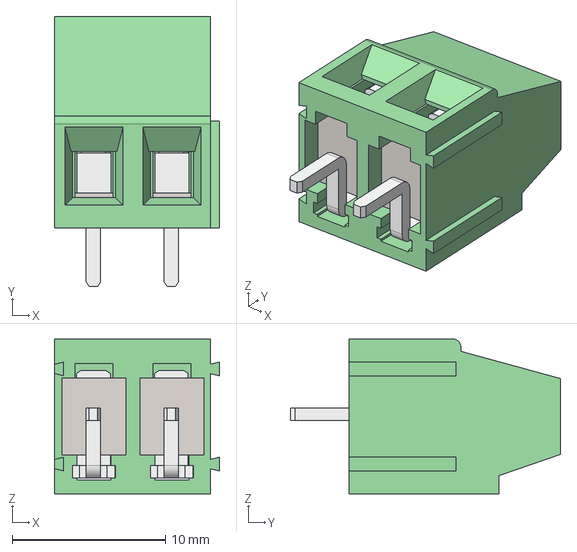
[picture p244: CAD file, 2025-10-22]
3D/Connector/TerminalBlock/WURTH_691216510002/WURTH_691216510002.STEP
10.8 x 17.6 x 10.1 mm
