MinhThuanLe/RAI_Lab_Kicad_Library/3D/Connector/TerminalBlock_HB9500/HB9500_01x02_P9.50mm.step

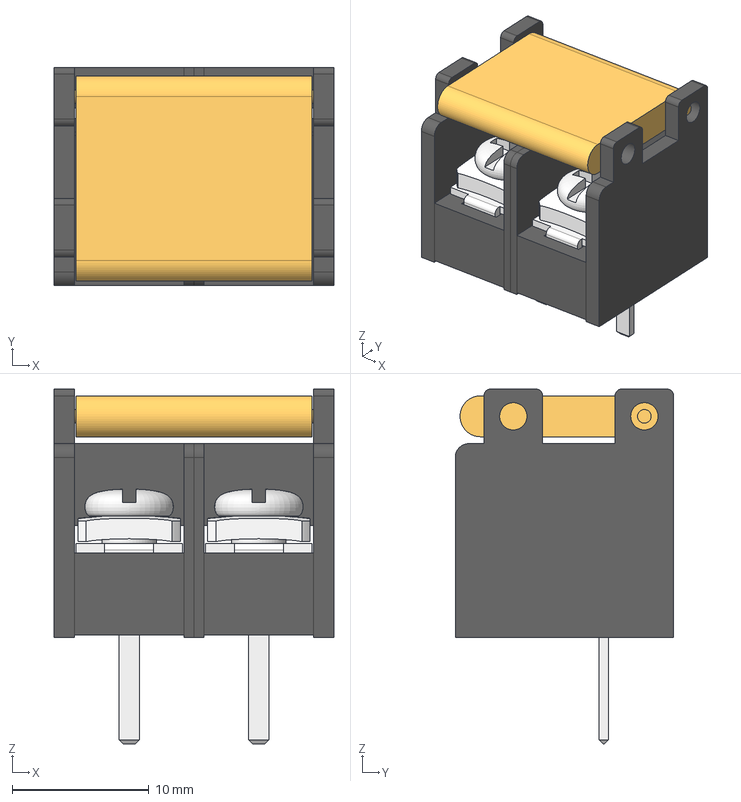
[picture p245: CAD file, 2025-10-22]
3D/Connector/TerminalBlock_HB9500/HB9500_01x02_P9.50mm.step
20.5 x 16.0 x 26.0 mm
LCS_Origin
BodyLeft
LCS_BodyLeft
CoverAxisL
BodyRight
Cover
