MinhThuanLe/RAI_Lab_Kicad_Library/3D/Connector/USB-C_12pin_SMD/USB Type C Port (SMD Type).STEP

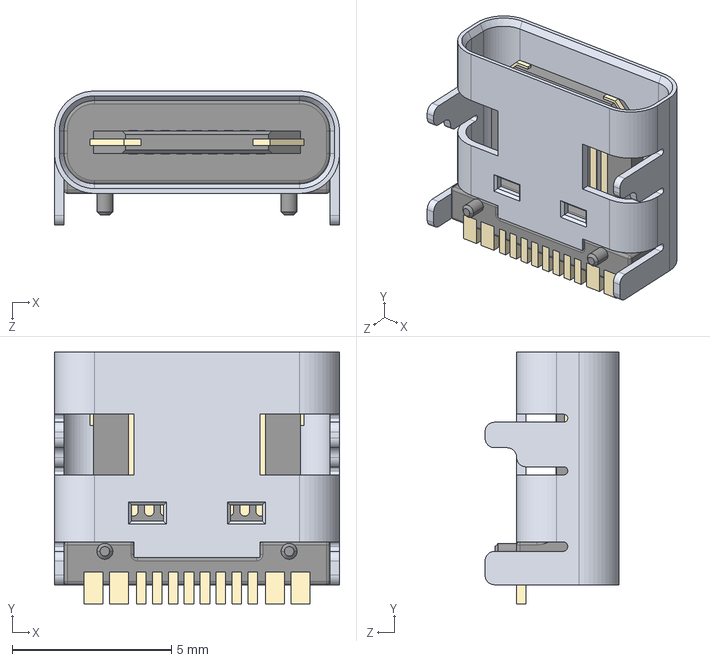
[picture p246: CAD file, 2025-10-22]
3D/Connector/USB-C_12pin_SMD/USB Type C Port (SMD Type).STEP
8.94 x 7.90 x 4.20 mm
