MinhThuanLe/RAI_Lab_Kicad_Library/3D/Connector/USB/MicroUSB/XKB Connectivity U254-051N-4BH806.step

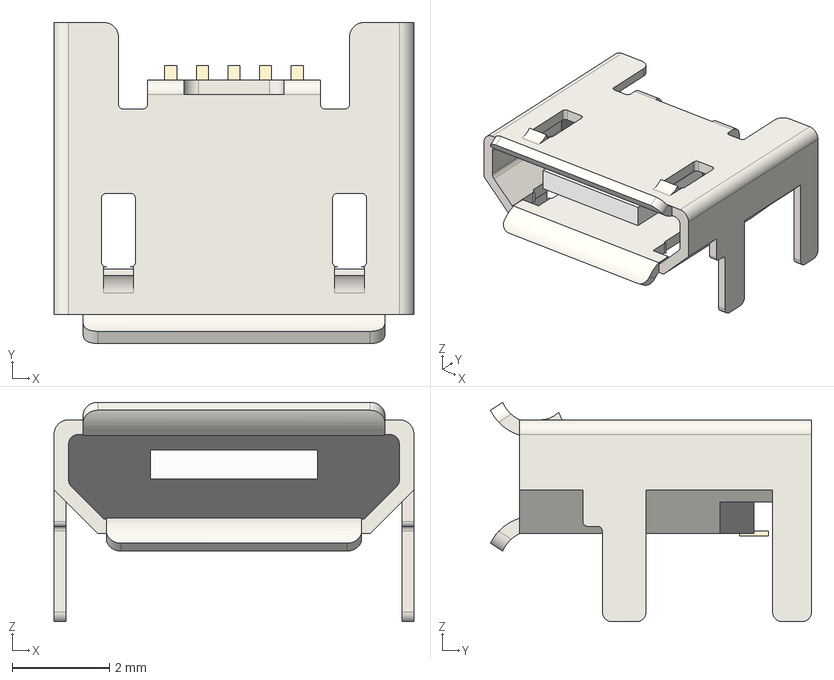
[picture p247: CAD file, 2025-10-22]
3D/Connector/USB/MicroUSB/XKB Connectivity U254-051N-4BH806.step
7.40 x 6.60 x 4.51 mm
