MinhThuanLe/RAI_Lab_Kicad_Library/3D/Connector/USB/USB_typeA/Dual_Female/usb double.STEP

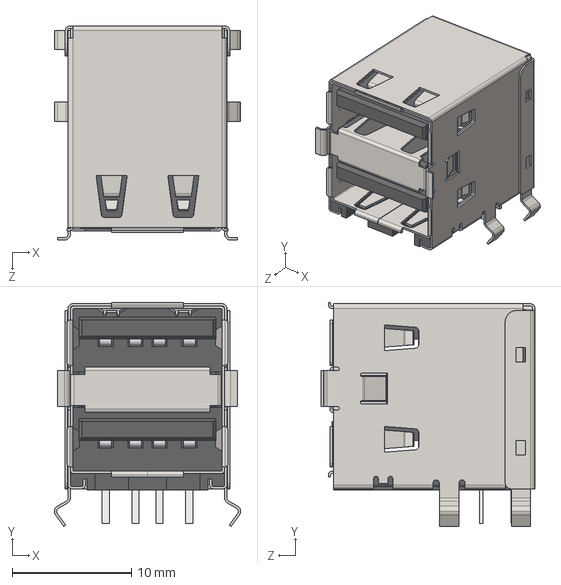
[picture p248: CAD file, 2025-10-22]
3D/Connector/USB/USB_typeA/Dual_Female/usb double.STEP
15.6 x 18.7 x 17.9 mm
