MinhThuanLe/RAI_Lab_Kicad_Library/3D/Connector/USB/USB_typeA/Male/USB1061-GF-L-A--3DModel-STEP-269445.STEP

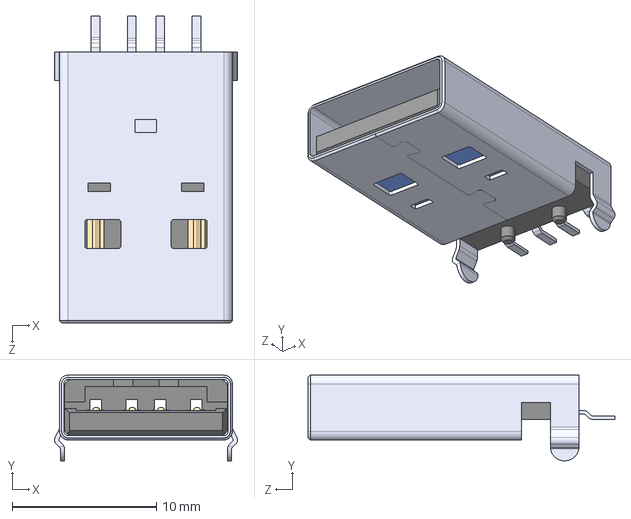
[picture p249: CAD file, 2025-10-22]
3D/Connector/USB/USB_typeA/Male/USB1061-GF-L-A--3DModel-STEP-269445.STEP
12.7 x 5.95 x 21.3 mm
