MinhThuanLe/RAI_Lab_Kicad_Library/3D/Connector/USB/USB_typeA/USB-A 111 (vertical on plate).STEP

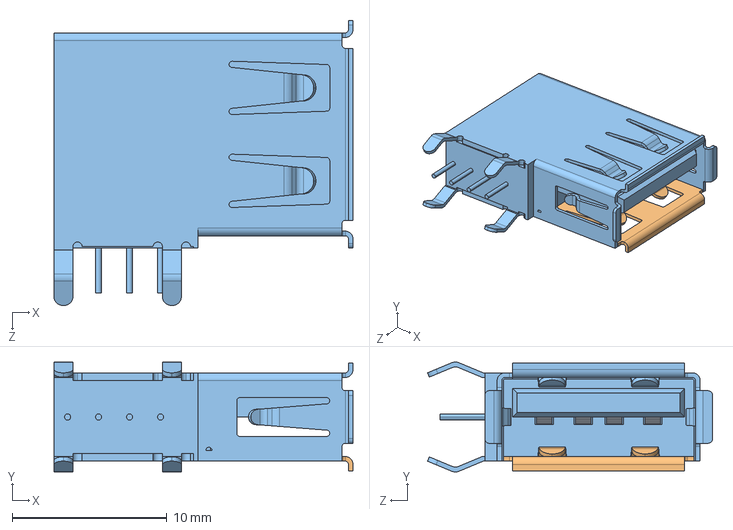
[picture p250: CAD file, 2025-10-22]
3D/Connector/USB/USB_typeA/USB-A 111 (vertical on plate).STEP
19.3 x 7.10 x 18.4 mm
