MinhThuanLe/RAI_Lab_Kicad_Library/3D/Connector/USB/USB_typeA/usb-type-a-4.snapshot.2/1_USB_Type_A v3.step

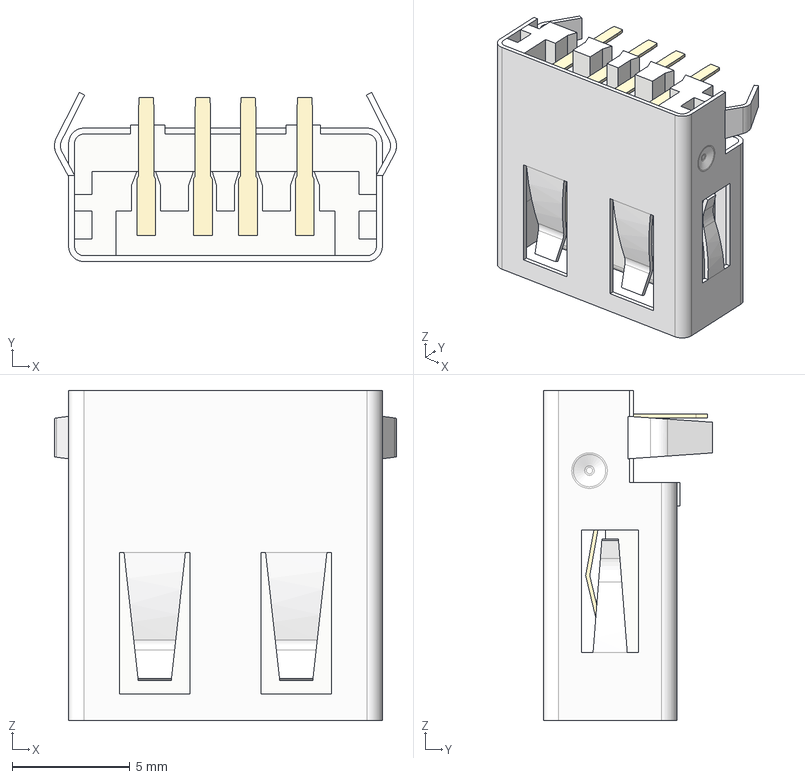
[picture p251: CAD file, 2025-10-22]
3D/Connector/USB/USB_typeA/usb-type-a-4.snapshot.2/1_USB_Type_A v3.step
14.5 x 7.17 x 14.0 mm
USB_A_GND
USB_A_Teflon
USB_A_Pin x 2
USB_A_Pin(Mirror) x 2
