MinhThuanLe/RAI_Lab_Kicad_Library/3D/Connector/VH3.96/jst-vh-3-96mm-connector-set-1.snapshot.17/JST - VH - Thru (V) - 12Pin - 3.96mm.stp

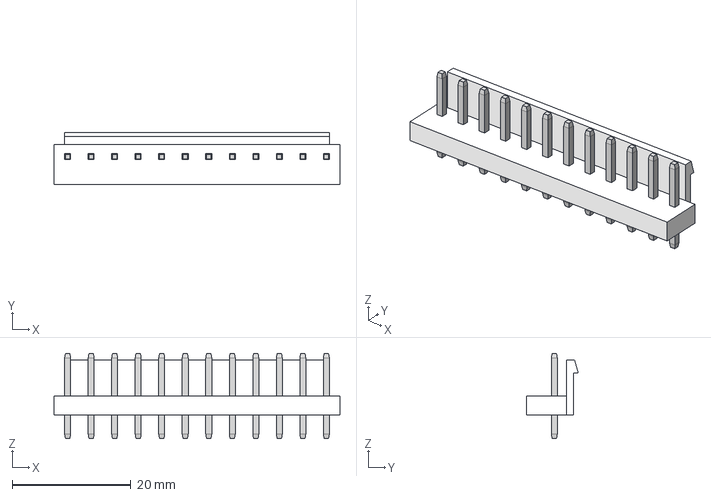
[picture p252: CAD file, 2025-10-22]
3D/Connector/VH3.96/jst-vh-3-96mm-connector-set-1.snapshot.17/JST - VH - Thru (V) - 12Pin - 3.96mm.stp
48.2 x 8.69 x 14.3 mm
