MinhThuanLe/RAI_Lab_Kicad_Library/3D/Connector/XH_2.54/SMD Horizontal/JST - XH - SMD (R) - 19Pin - 2.54mm.stp

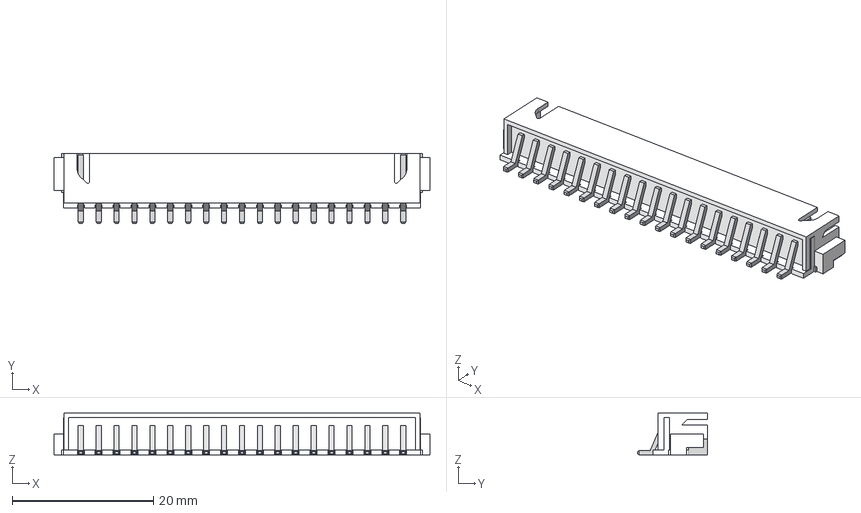
[picture p253: CAD file, 2025-10-22]
3D/Connector/XH_2.54/SMD Horizontal/JST - XH - SMD (R) - 19Pin - 2.54mm.stp
53.3 x 9.91 x 5.92 mm
