MinhThuanLe/RAI_Lab_Kicad_Library/3D/Connector/XH_2.54/Thru Horizontal/JST - XH - Thru (R) - 16Pin - 2.54mm.stp

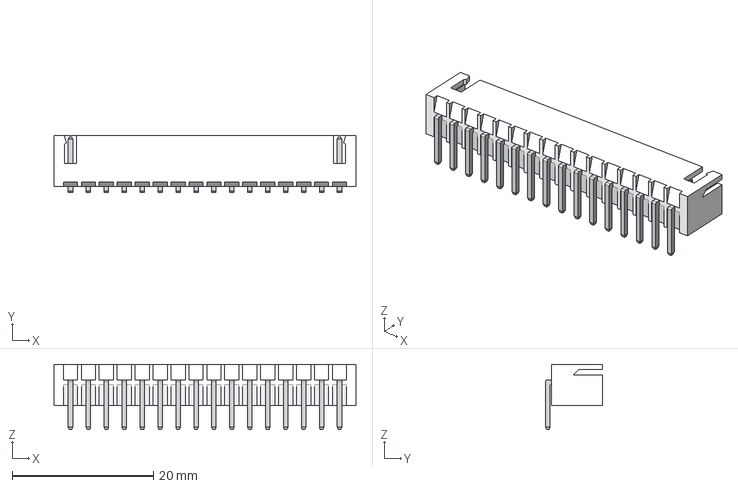
[picture p254: CAD file, 2025-10-22]
3D/Connector/XH_2.54/Thru Horizontal/JST - XH - Thru (R) - 16Pin - 2.54mm.stp
42.8 x 8.04 x 9.22 mm
