MinhThuanLe/RAI_Lab_Kicad_Library/3D/Connector/XH_2.54/Thru Vertical/JST - XH - Thru (V) - 8Pin - 2.54mm.stp

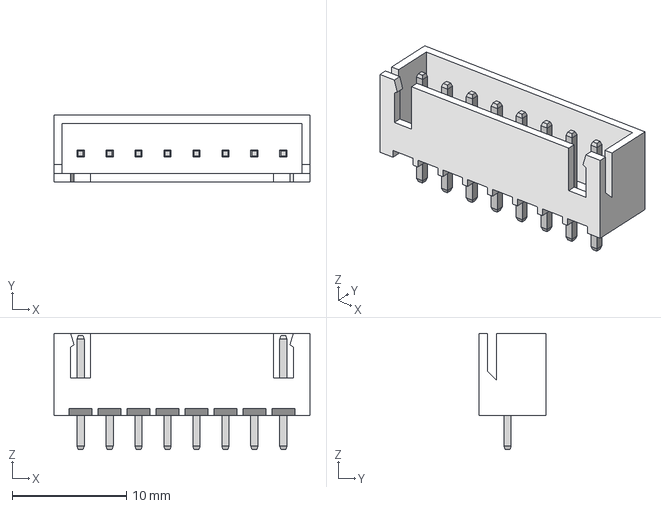
[picture p255: CAD file, 2025-10-22]
3D/Connector/XH_2.54/Thru Vertical/JST - XH - Thru (V) - 8Pin - 2.54mm.stp
22.5 x 5.84 x 10.2 mm
