MinhThuanLe/RAI_Lab_Kicad_Library/3D/Crystal/CrystalOscillator2016_4P_SMD/QFN_2016_4pins.STEP

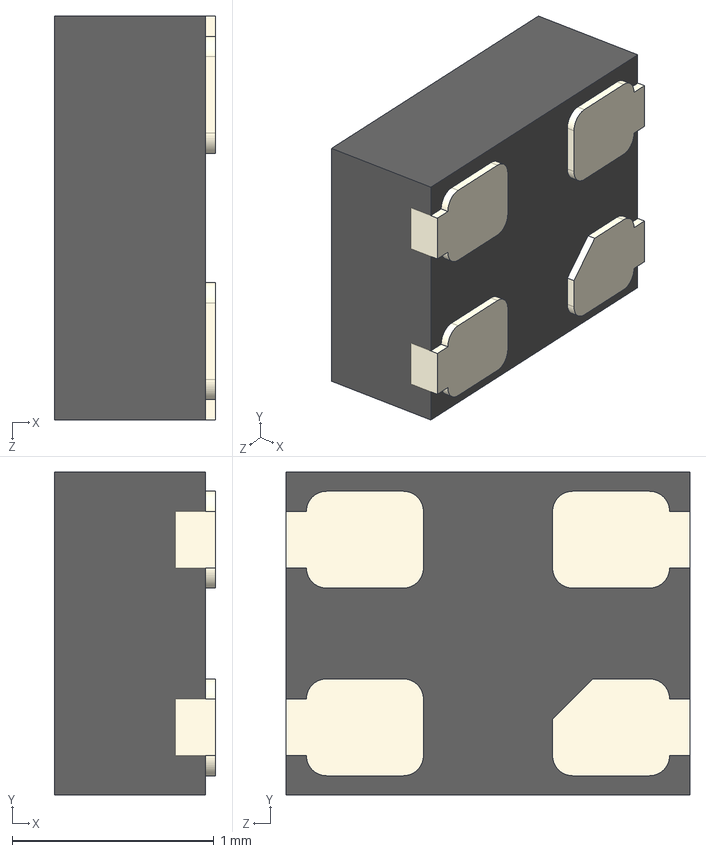
[picture p256: CAD file, 2025-10-22]
3D/Crystal/CrystalOscillator2016_4P_SMD/QFN_2016_4pins.STEP
0.8 x 1.60 x 2.00 mm
