MinhThuanLe/RAI_Lab_Kicad_Library/3D/Crystal/SMD/Crystal_SMD_3225-4Pin_5.0x3.2mm/OSC3225.STEP

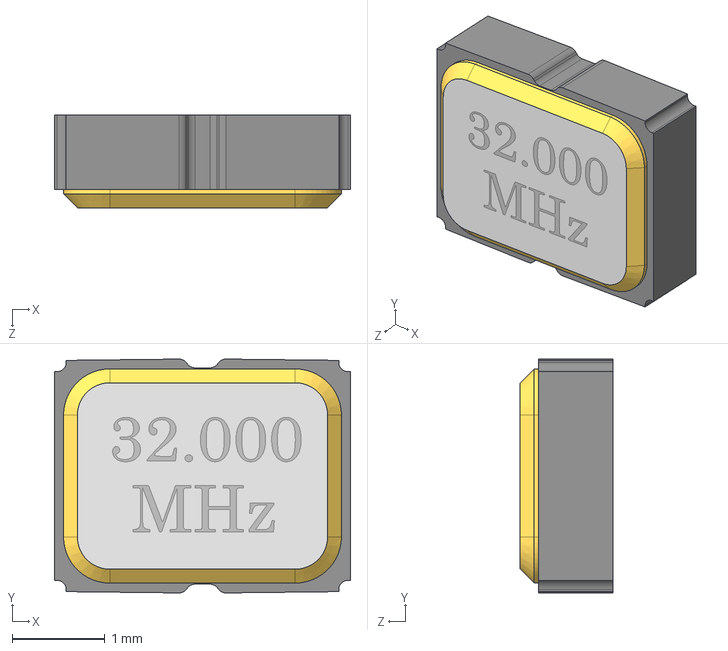
[picture p257: CAD file, 2025-10-22]
3D/Crystal/SMD/Crystal_SMD_3225-4Pin_5.0x3.2mm/OSC3225.STEP
3.20 x 2.53 x 1.00 mm
