MinhThuanLe/RAI_Lab_Kicad_Library/3D/Crystal/SMD/Crystal_SMD_5032-4Pin_5.0x3.2mm/OSC5032.STEP

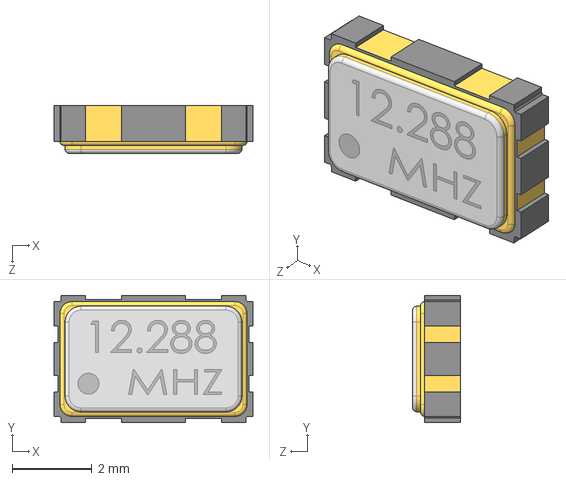
[picture p258: CAD file, 2025-10-22]
3D/Crystal/SMD/Crystal_SMD_5032-4Pin_5.0x3.2mm/OSC5032.STEP
5.00 x 3.20 x 1.20 mm
