MinhThuanLe/RAI_Lab_Kicad_Library/3D/Crystal/SMD/MC306-ABS25-32.768KHZ/MC306-ABS25-32.768KHZ.STEP

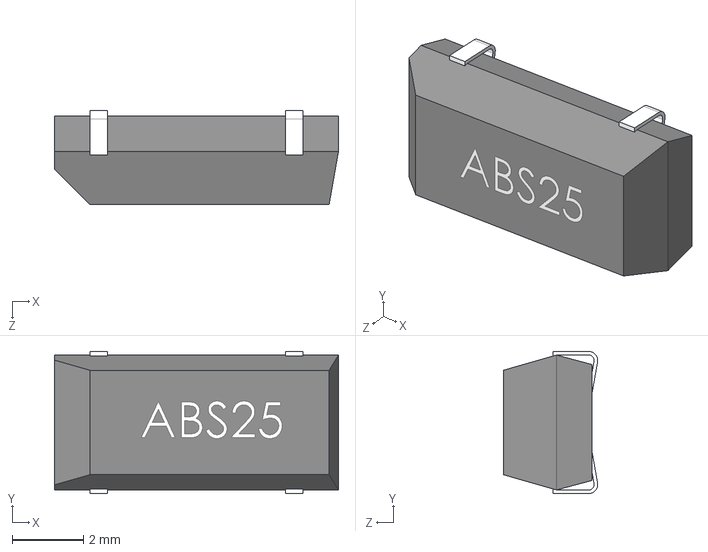
[picture p260: CAD file, 2025-10-22]
3D/Crystal/SMD/MC306-ABS25-32.768KHZ/MC306-ABS25-32.768KHZ.STEP
8.00 x 4.00 x 2.66 mm
