MinhThuanLe/RAI_Lab_Kicad_Library/3D/Diode/Bridge/MB10E/MB10F-13.step

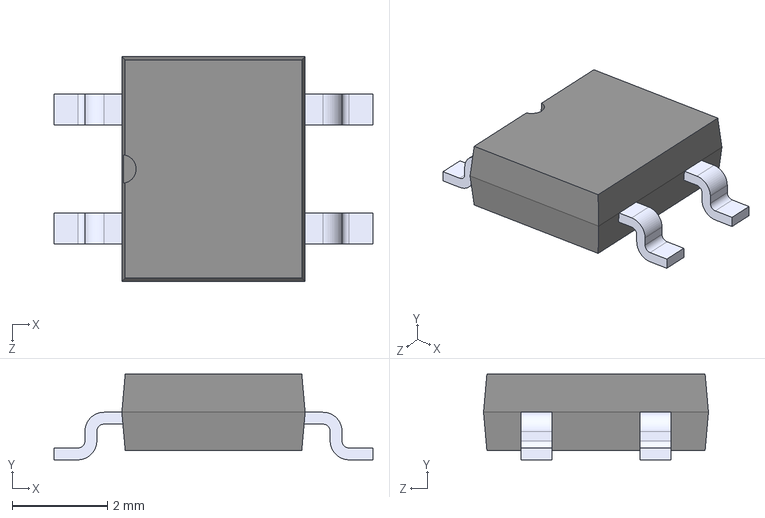
[picture p261: CAD file, 2025-10-22]
3D/Diode/Bridge/MB10E/MB10F-13.step
6.70 x 1.80 x 4.72 mm
