MinhThuanLe/RAI_Lab_Kicad_Library/3D/Diode/LED/7Segment/3 digit 7seg 38x19.step

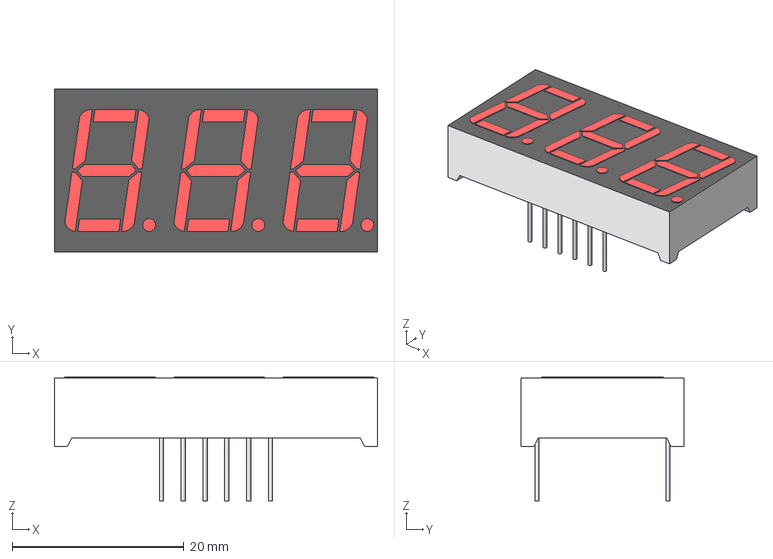
[picture p262: CAD file, 2025-10-22]
3D/Diode/LED/7Segment/3 digit 7seg 38x19.step
37.6 x 19.0 x 14.4 mm
