MinhThuanLe/RAI_Lab_Kicad_Library/3D/Diode/LED/DIP/5mm/LED 5mm Red.step

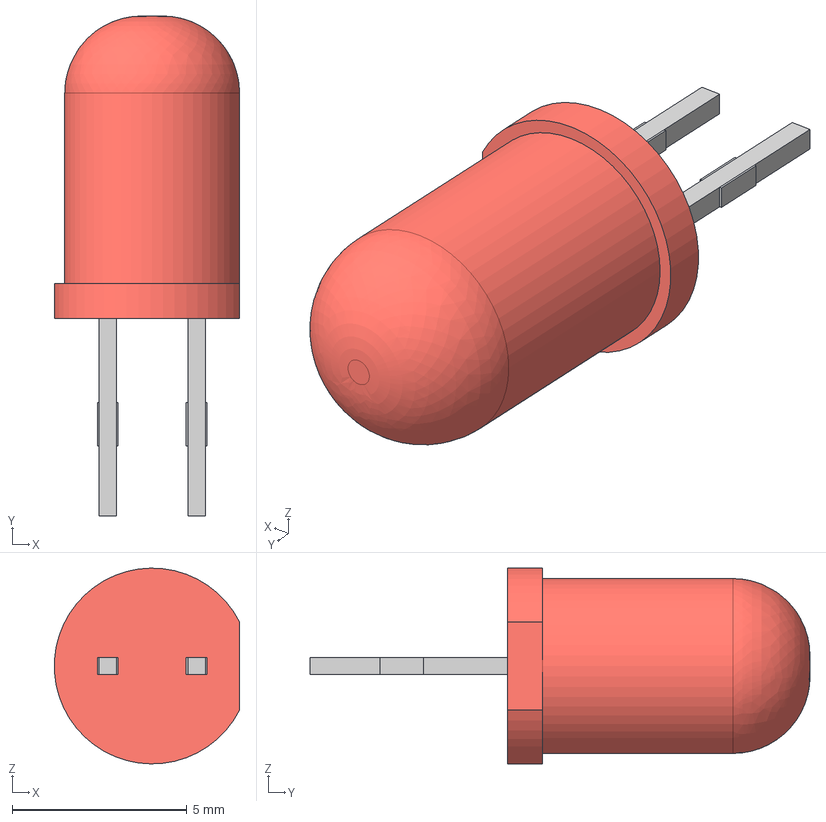
[picture p263: CAD file, 2025-10-22]
3D/Diode/LED/DIP/5mm/LED 5mm Red.step
5.29 x 14.3 x 5.60 mm
