MinhThuanLe/RAI_Lab_Kicad_Library/3D/Diode/LED/ITR9909.step

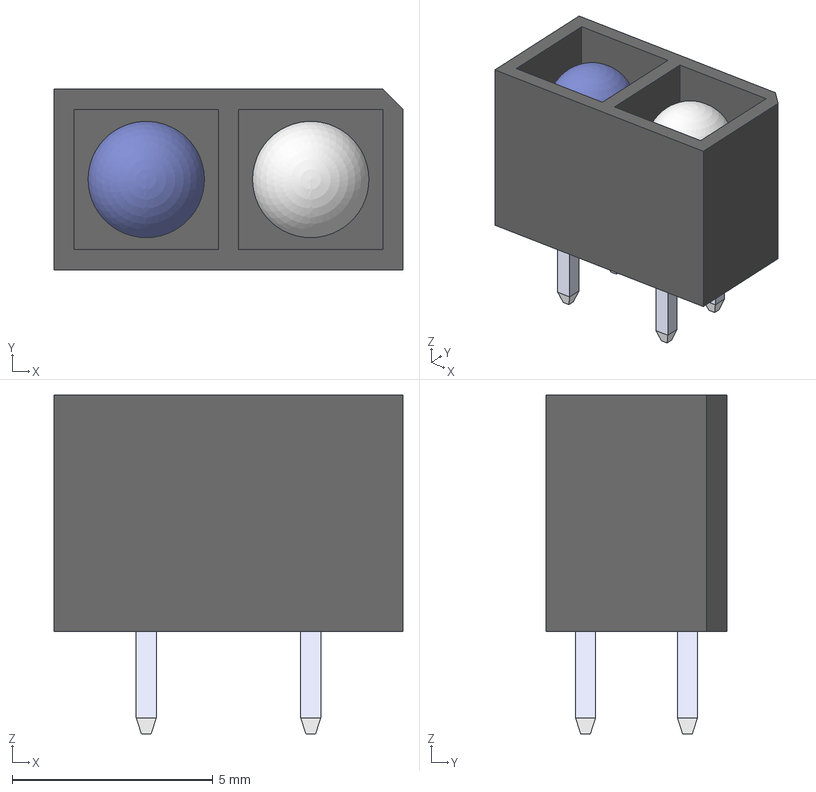
[picture p264: CAD file, 2025-10-22]
3D/Diode/LED/ITR9909.step
8.70 x 4.50 x 8.45 mm
Phototransistor
Infrared LED
