MinhThuanLe/RAI_Lab_Kicad_Library/3D/Diode/LED/LED/0603 Red.step

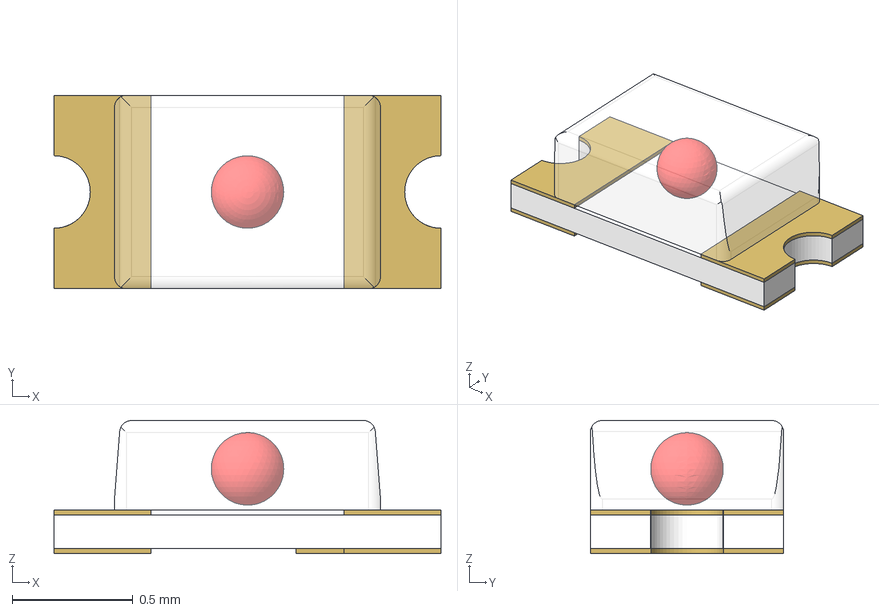
[picture p265: CAD file, 2025-10-22]
3D/Diode/LED/LED/0603 Red.step
1.60 x 0.8 x 0.55 mm
