MinhThuanLe/RAI_Lab_Kicad_Library/3D/Diode/LED/Led_3mm_DIP/LED 3mm Yellow.step

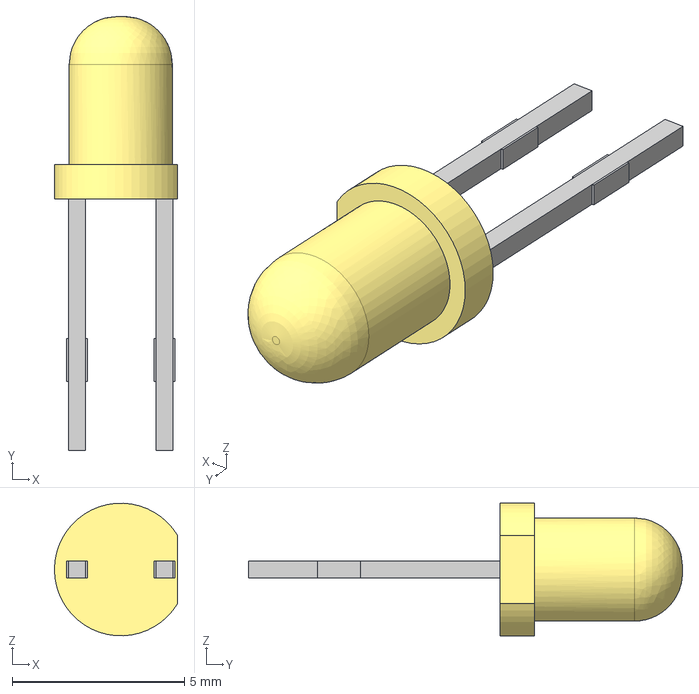
[picture p266: CAD file, 2025-10-22]
3D/Diode/LED/Led_3mm_DIP/LED 3mm Yellow.step
3.58 x 12.6 x 3.85 mm
