MinhThuanLe/RAI_Lab_Kicad_Library/3D/Diode/LED/LED_Housing/LED 3mm red housing.stp

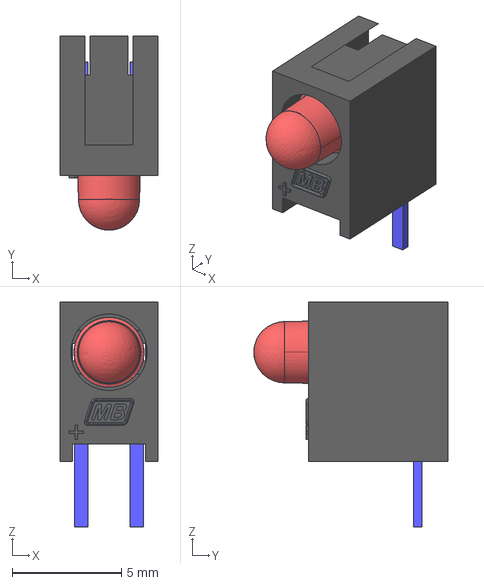
[picture p267: CAD file, 2025-10-22]
3D/Diode/LED/LED_Housing/LED 3mm red housing.stp
4.50 x 8.90 x 10.3 mm
