MinhThuanLe/RAI_Lab_Kicad_Library/3D/Diode/LED/QBLP680-RGB1/QBLP680-RGB1.step

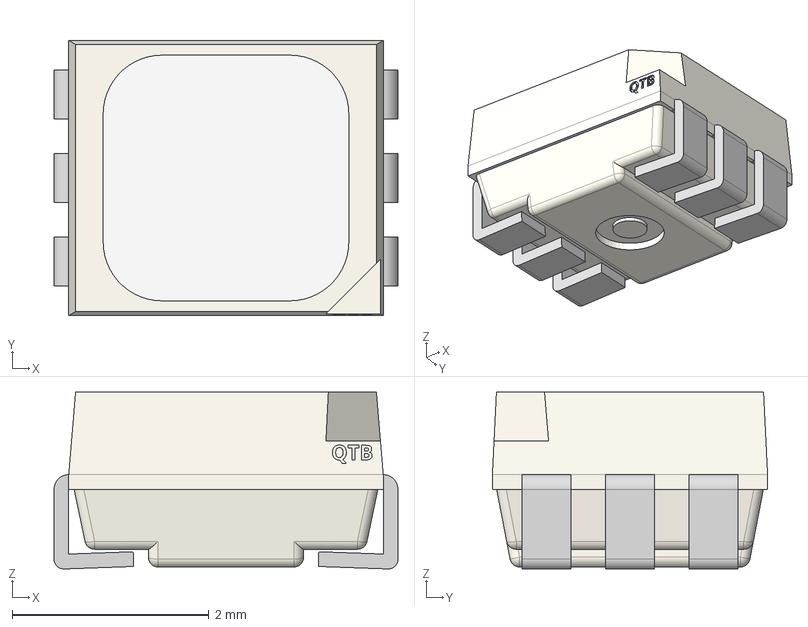
[picture p268: CAD file, 2025-10-22]
3D/Diode/LED/QBLP680-RGB1/QBLP680-RGB1.step
3.50 x 2.80 x 1.80 mm
