MinhThuanLe/RAI_Lab_Kicad_Library/3D/Diode/SMA/SMA (DO-214AC).STEP

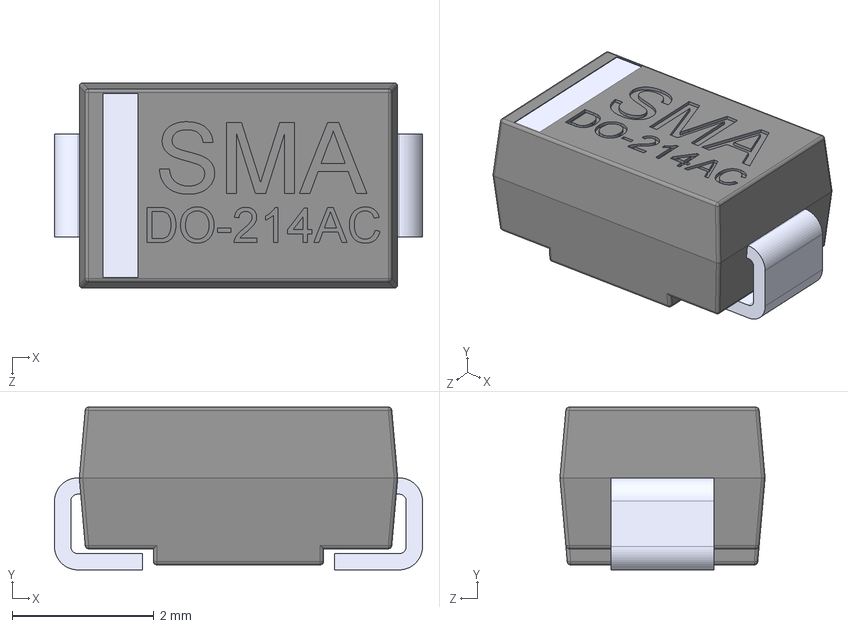
[picture p269: CAD file, 2025-10-22]
3D/Diode/SMA/SMA (DO-214AC).STEP
5.20 x 2.30 x 2.90 mm
