MinhThuanLe/RAI_Lab_Kicad_Library/3D/Diode/SOD-128/SOD-128.step

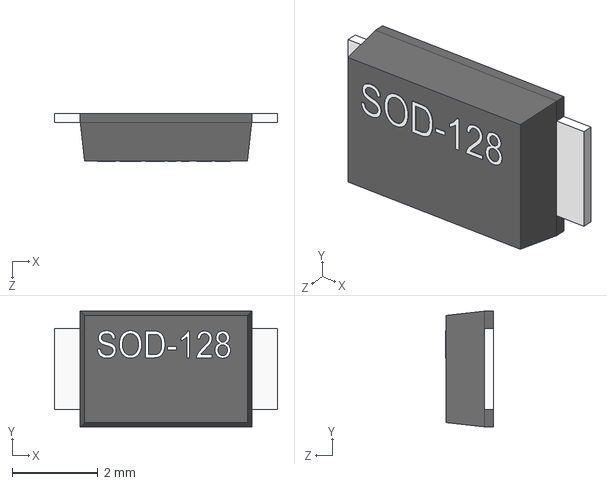
[picture p270: CAD file, 2025-10-22]
3D/Diode/SOD-128/SOD-128.step
5.20 x 2.70 x 1.11 mm
