MinhThuanLe/RAI_Lab_Kicad_Library/3D/Diode/SOD123/SOD123.step

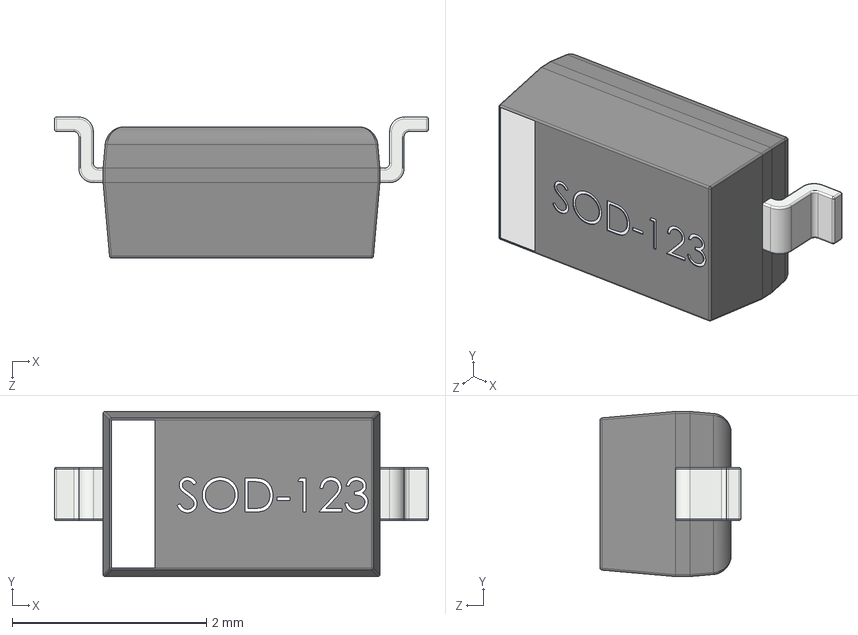
[picture p271: CAD file, 2025-10-22]
3D/Diode/SOD123/SOD123.step
3.85 x 1.70 x 1.45 mm
