MinhThuanLe/RAI_Lab_Kicad_Library/3D/Diode/SOD123F/SOD-123F.step

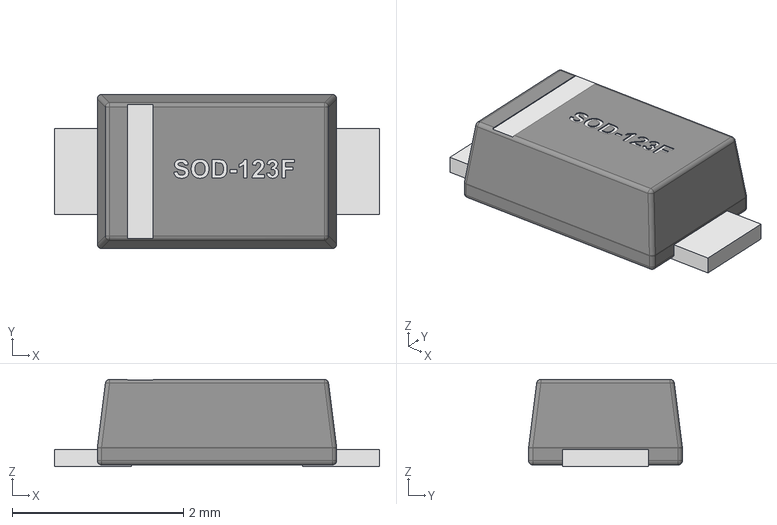
[picture p272: CAD file, 2025-10-22]
3D/Diode/SOD123F/SOD-123F.step
3.80 x 1.80 x 1.02 mm
