MinhThuanLe/RAI_Lab_Kicad_Library/3D/Diode/SOD323/SOD323.step

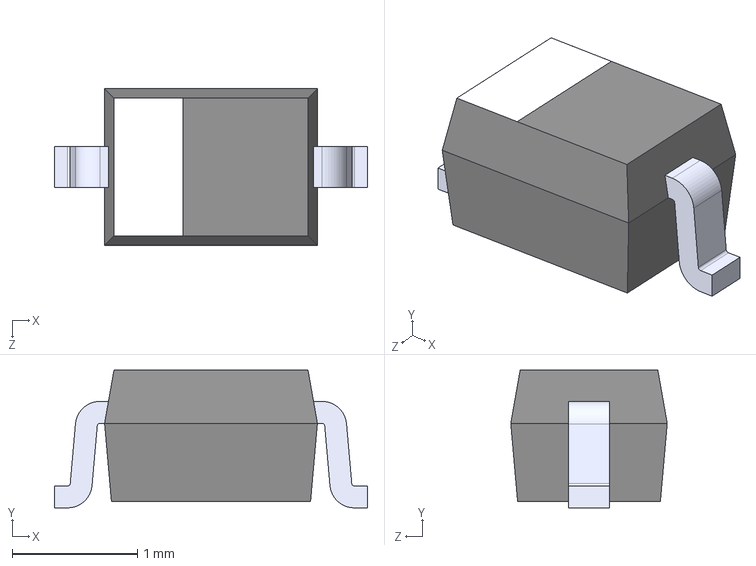
[picture p273: CAD file, 2025-10-22]
3D/Diode/SOD323/SOD323.step
2.50 x 1.10 x 1.25 mm
