MinhThuanLe/RAI_Lab_Kicad_Library/3D/Diode/THT/1N4007-T.STEP

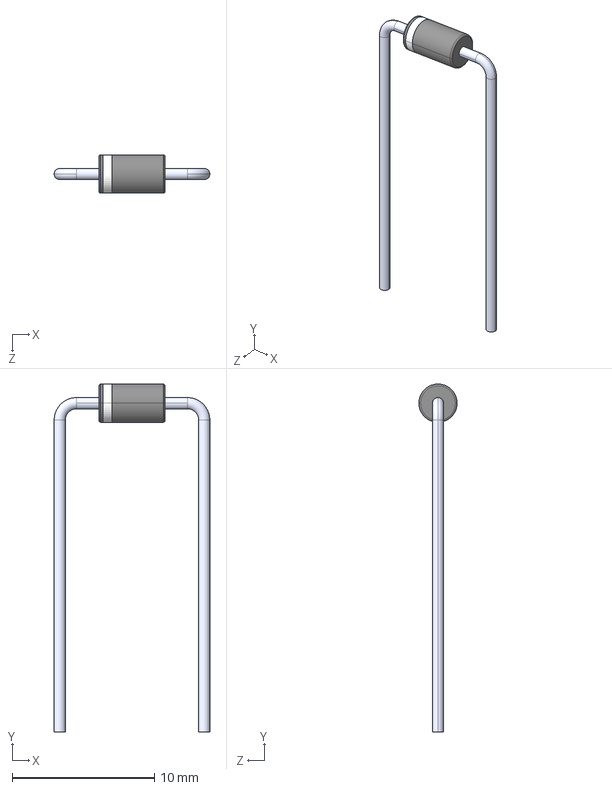
[picture p274: CAD file, 2025-10-22]
3D/Diode/THT/1N4007-T.STEP
10.9 x 24.5 x 2.69 mm
