MinhThuanLe/RAI_Lab_Kicad_Library/3D/Diode/TPD4EUSB30DQAR/TPD4EUSB30DQAR.step

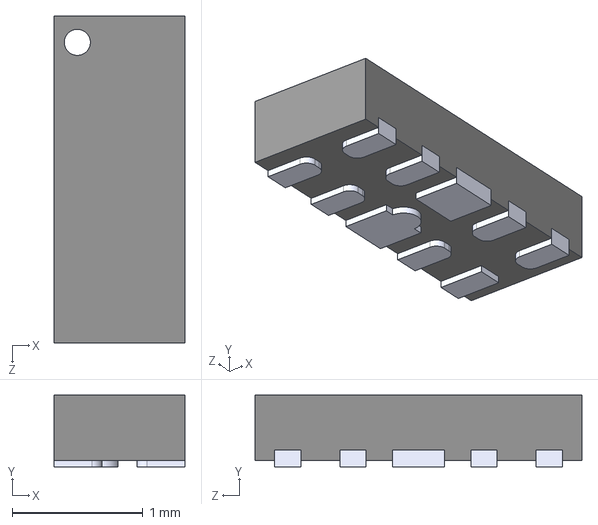
[picture p275: CAD file, 2025-10-22]
3D/Diode/TPD4EUSB30DQAR/TPD4EUSB30DQAR.step
1.00 x 0.55 x 2.50 mm
