MinhThuanLe/RAI_Lab_Kicad_Library/3D/Driver/L298N.step

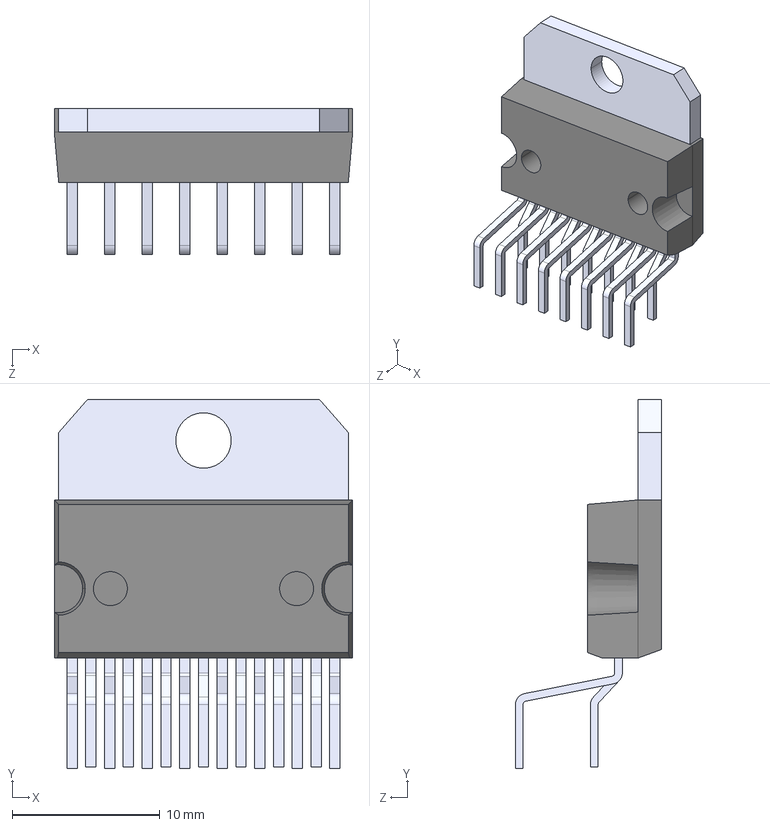
[picture p276: CAD file, 2025-10-22]
3D/Driver/L298N.step
20.2 x 25.0 x 9.89 mm
