MinhThuanLe/RAI_Lab_Kicad_Library/3D/Encoder/DIP/11mm-metal-shaft-rotary-encoders-horizontal-w-push-on-switch/Encoders/EC11B-SW-Horiz-15K-black.step

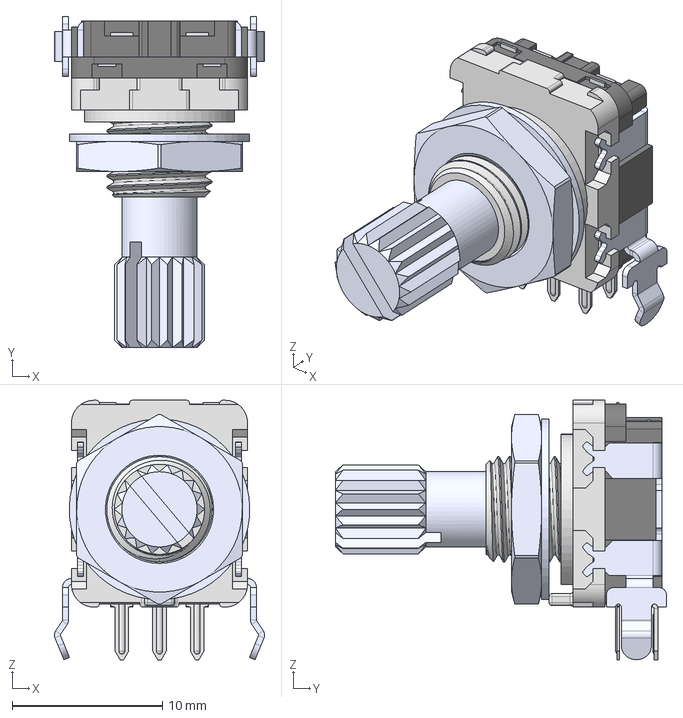
[picture p277: CAD file, 2025-10-22]
3D/Encoder/DIP/11mm-metal-shaft-rotary-encoders-horizontal-w-push-on-switch/Encoders/EC11B-SW-Horiz-15K-black.step
14.0 x 22.0 x 17.3 mm
