MinhThuanLe/RAI_Lab_Kicad_Library/3D/Encoder/DIP/11mm-metal-shaft-rotary-encoders-tht-vertical-w-push-on-switch/Encoders/EC11-THT-20R-green.step

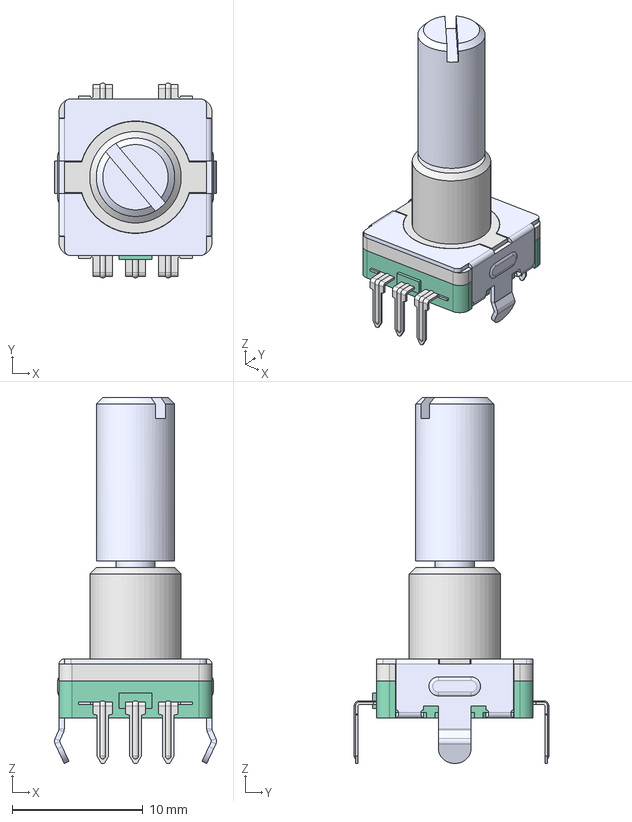
[picture p278: CAD file, 2025-10-22]
3D/Encoder/DIP/11mm-metal-shaft-rotary-encoders-tht-vertical-w-push-on-switch/Encoders/EC11-THT-20R-green.step
12.4 x 14.9 x 28.0 mm
Lb7
20R
EC11-Housing-THT
