MinhThuanLe/RAI_Lab_Kicad_Library/3D/Filter/AC Filter Choke/filtr-ac-pins7x8.STEP

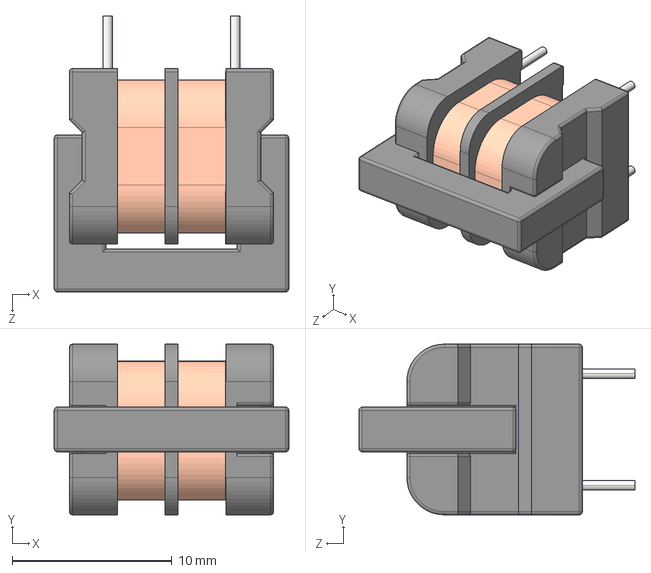
[picture p280: CAD file, 2025-10-22]
3D/Filter/AC Filter Choke/filtr-ac-pins7x8.STEP
14.7 x 10.7 x 17.3 mm
