MinhThuanLe/RAI_Lab_Kicad_Library/3D/Filter/Gas Discharge Tubes/User Library-SH_Series.STEP

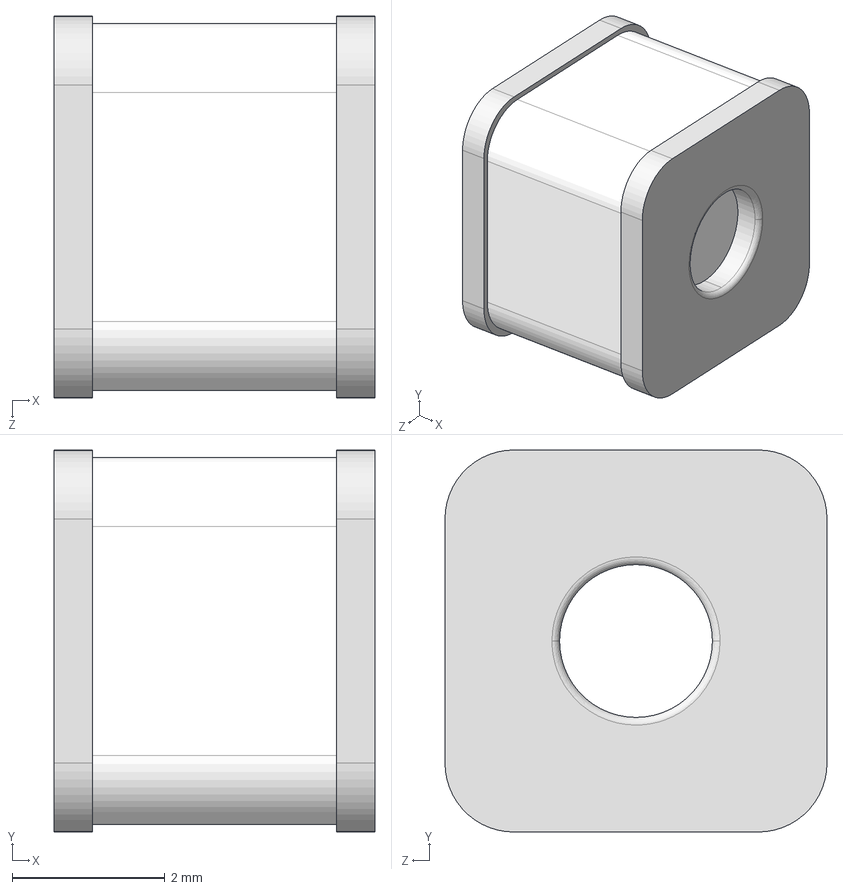
[picture p281: CAD file, 2025-10-22]
3D/Filter/Gas Discharge Tubes/User Library-SH_Series.STEP
4.20 x 5.00 x 5.00 mm
