MinhThuanLe/RAI_Lab_Kicad_Library/3D/Fuses/FuseHolderGlass5x20mm/Fuse_BLX-A22mm.STEP

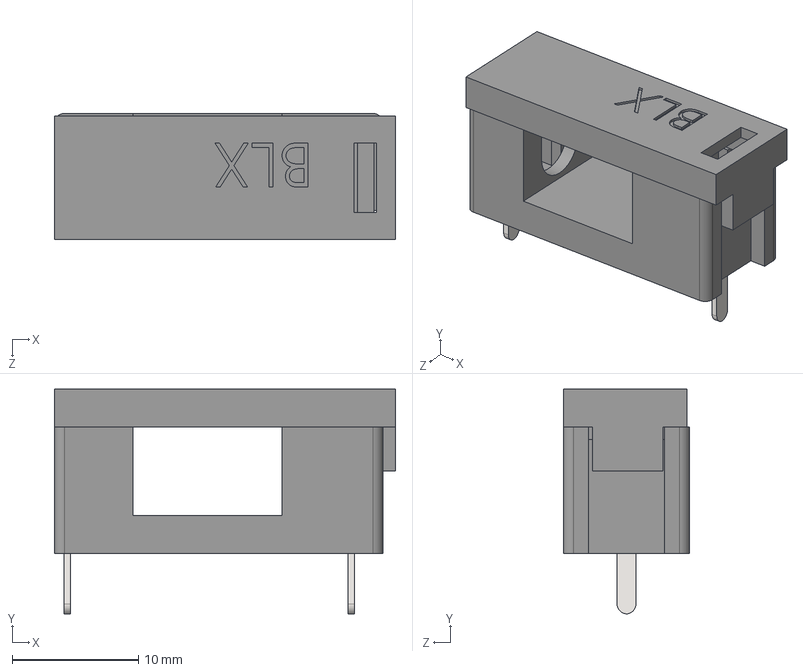
[picture p282: CAD file, 2025-10-22]
3D/Fuses/FuseHolderGlass5x20mm/Fuse_BLX-A22mm.STEP
27.0 x 17.8 x 10.0 mm
