MinhThuanLe/RAI_Lab_Kicad_Library/3D/Fuses/FuseSMD/litteFuse/Littelfuse 0154.500DRT v5.step

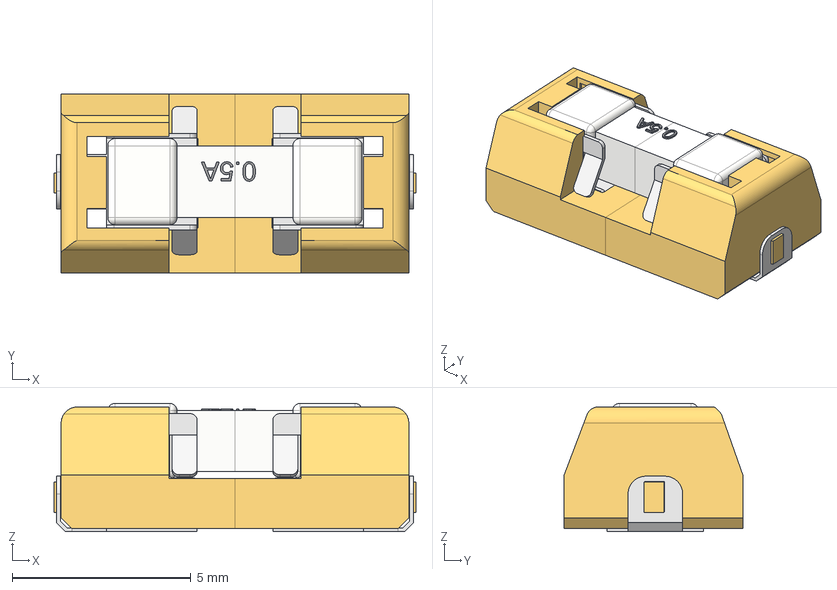
[picture p283: CAD file, 2025-10-22]
3D/Fuses/FuseSMD/litteFuse/Littelfuse 0154.500DRT v5.step
10.1 x 5.00 x 3.59 mm
Komponente1
Komponente2
Komponente3
Komponente4
