MinhThuanLe/RAI_Lab_Kicad_Library/3D/Fuses/FuseSMD/Resettable Fuse/0603/fuse_silicon_0603L.step

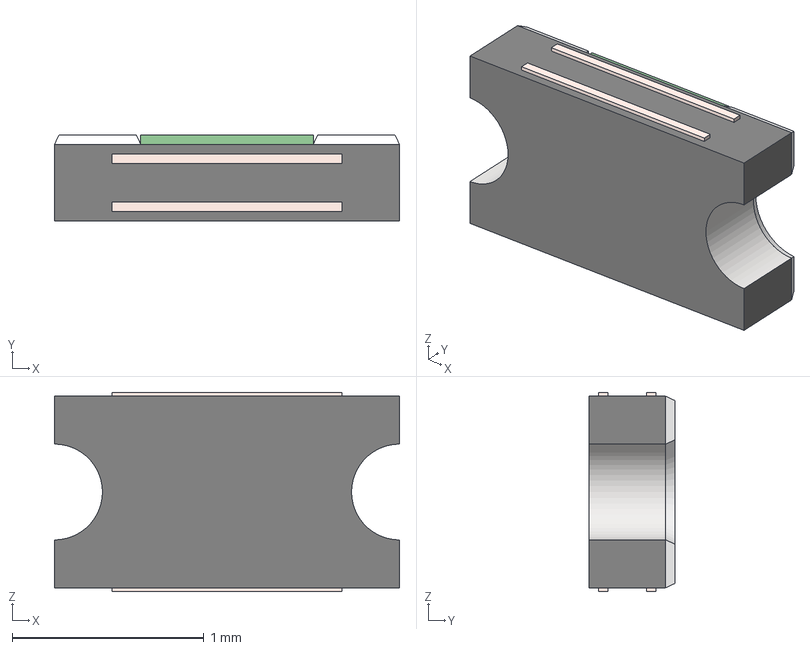
[picture p284: CAD file, 2025-10-22]
3D/Fuses/FuseSMD/Resettable Fuse/0603/fuse_silicon_0603L.step
1.80 x 0.45 x 1.04 mm
