MinhThuanLe/RAI_Lab_Kicad_Library/3D/Fuses/FuseSMD/Resettable Fuse/1206/Bourns SF Fuse/SF-1206SA2000R-2.stp

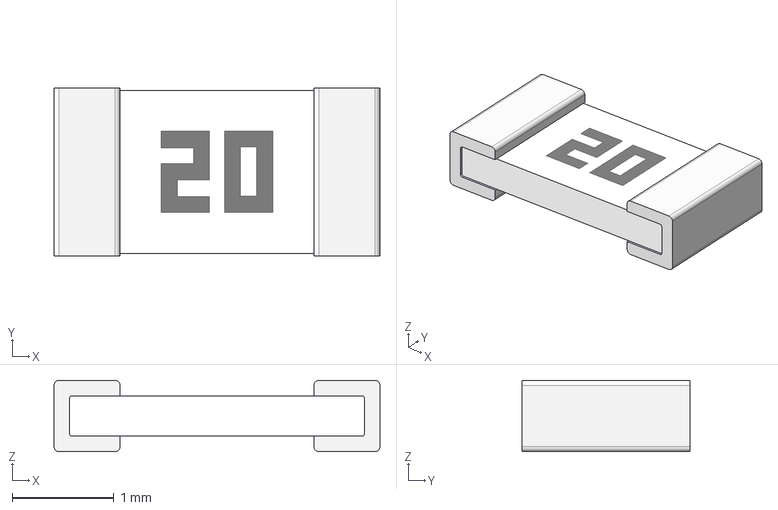
[picture p285: CAD file, 2025-10-22]
3D/Fuses/FuseSMD/Resettable Fuse/1206/Bourns SF Fuse/SF-1206SA2000R-2.stp
3.20 x 1.65 x 0.7 mm
