MinhThuanLe/RAI_Lab_Kicad_Library/3D/Fuses/FuseSMD/Resettable Fuse/1206/fuse_silicon_1206L.step

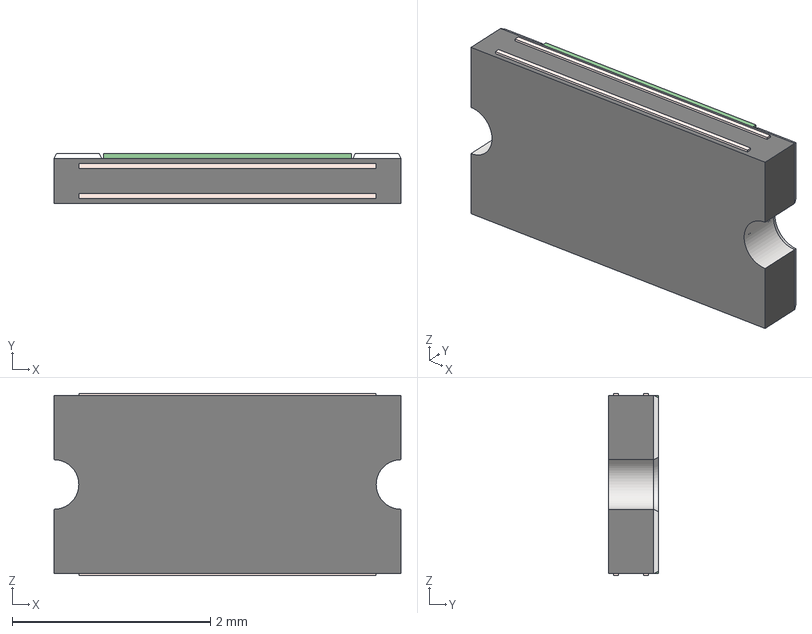
[picture p286: CAD file, 2025-10-22]
3D/Fuses/FuseSMD/Resettable Fuse/1206/fuse_silicon_1206L.step
3.50 x 0.5 x 1.84 mm
