MinhThuanLe/RAI_Lab_Kicad_Library/3D/Fuses/FuseSMD/Resettable Fuse/1812/smd1812.stp

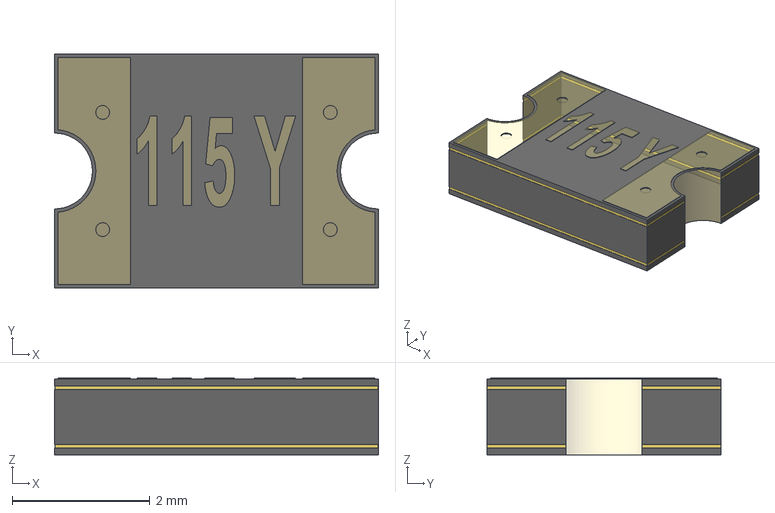
[picture p287: CAD file, 2025-10-22]
3D/Fuses/FuseSMD/Resettable Fuse/1812/smd1812.stp
4.70 x 3.40 x 1.11 mm
