MinhThuanLe/RAI_Lab_Kicad_Library/3D/IC/ADXL345BCCZ.STEP

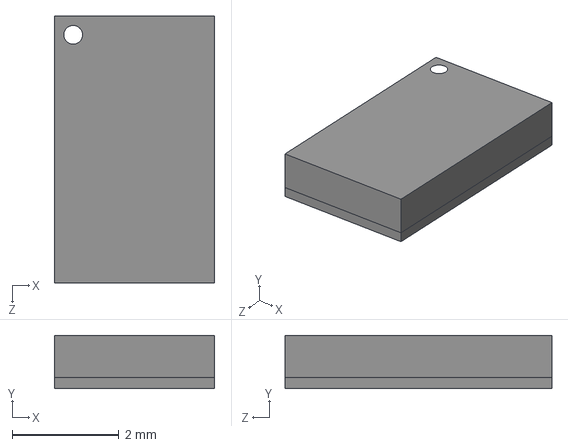
[picture p288: CAD file, 2025-10-22]
3D/IC/ADXL345BCCZ.STEP
3.00 x 1.00 x 5.00 mm
