MinhThuanLe/RAI_Lab_Kicad_Library/3D/Inductor/SMD/CDRH104R/CDRH104R.STEP

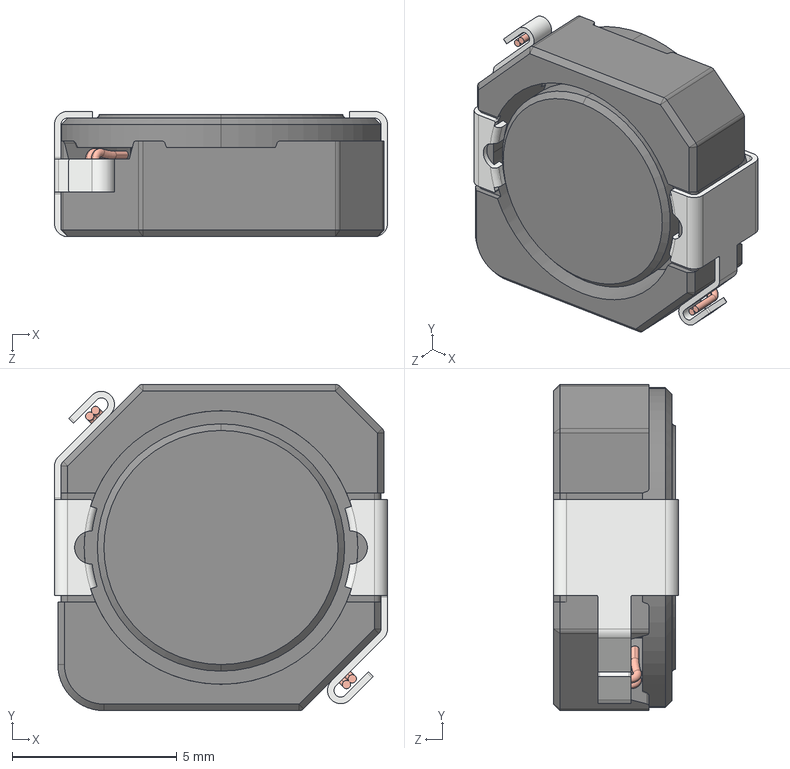
[picture p289: CAD file, 2025-10-22]
3D/Inductor/SMD/CDRH104R/CDRH104R.STEP
10.1 x 9.90 x 3.80 mm
