MinhThuanLe/RAI_Lab_Kicad_Library/3D/Inductor/SMD/GrayPowerInductor/Inductor_SMD_AMPLF_0620.STEP

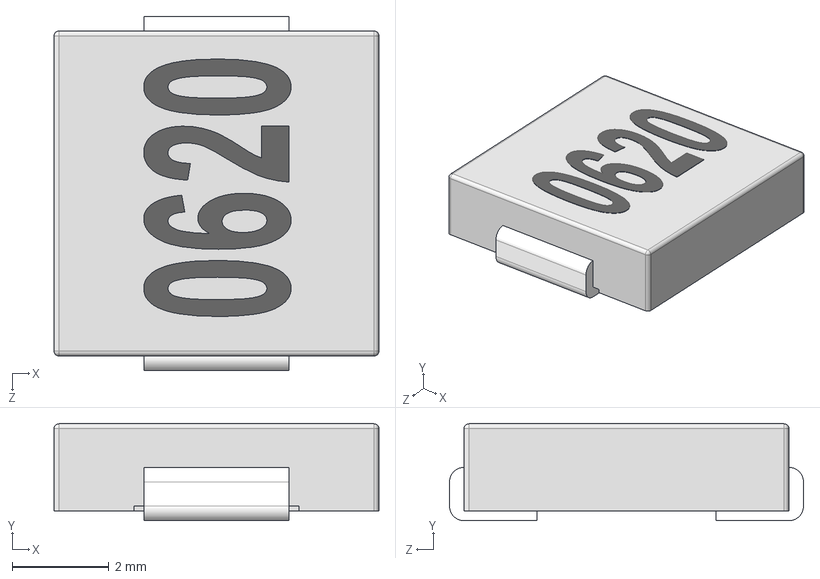
[picture p290: CAD file, 2025-10-22]
3D/Inductor/SMD/GrayPowerInductor/Inductor_SMD_AMPLF_0620.STEP
6.70 x 2.01 x 7.30 mm
