MinhThuanLe/RAI_Lab_Kicad_Library/3D/Isolation/OPTO/MOC/MOC3020.step

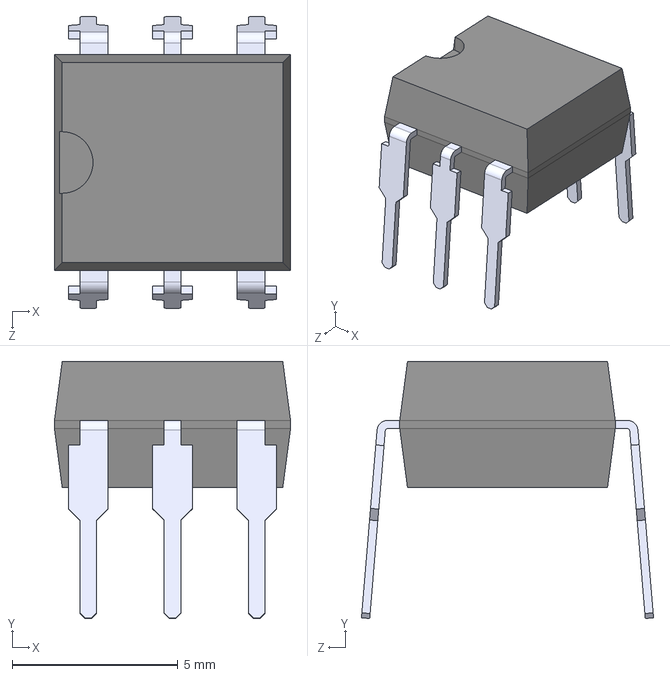
[picture p291: CAD file, 2025-10-22]
3D/Isolation/OPTO/MOC/MOC3020.step
7.12 x 7.75 x 8.81 mm
