MinhThuanLe/RAI_Lab_Kicad_Library/3D/Isolation/OPTO/pc817/pc817 dip6.step

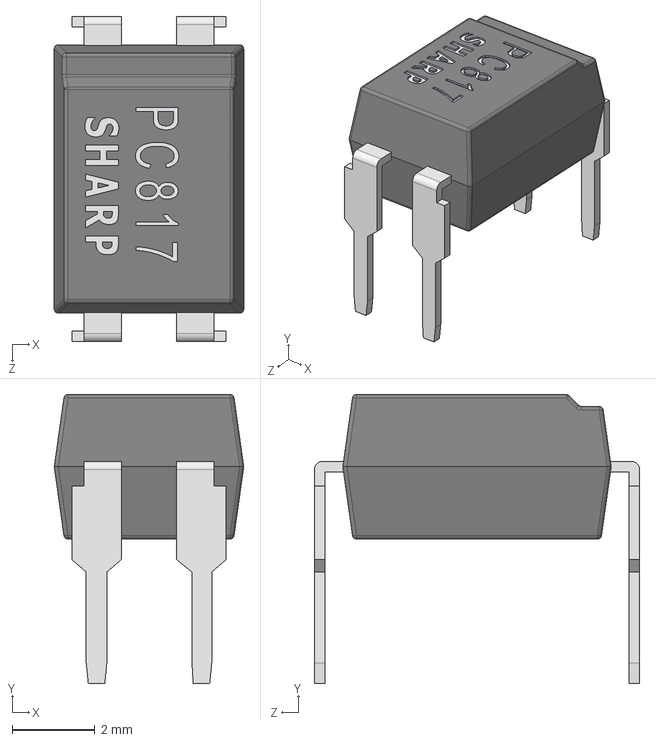
[picture p292: CAD file, 2025-10-22]
3D/Isolation/OPTO/pc817/pc817 dip6.step
4.59 x 7.00 x 7.88 mm
