MinhThuanLe/RAI_Lab_Kicad_Library/3D/MachCauH/BTS7960B--3DModel-STEP-1.STEP

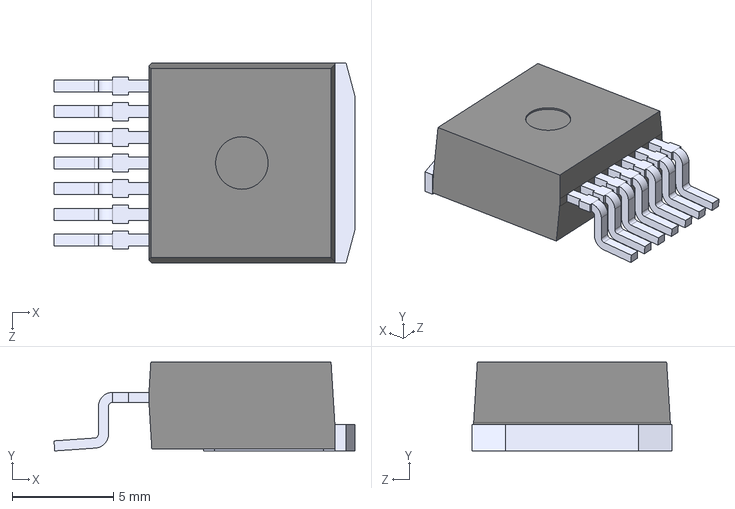
[picture p293: CAD file, 2025-10-22]
3D/MachCauH/BTS7960B--3DModel-STEP-1.STEP
14.9 x 4.40 x 9.90 mm
